Khodii/OmniMoveCar/README.md

# OmniMoveCar
Design, Herstellung und Software für ein OmniMove Auto in kleinem Maßstab

Praktikum Konstruktionslehre
Besondere Eigenschaft: omnidirektionales Fahren möglich durch holonome Räder und Planetengetriebe
