Khodii/OmniMoveCar/Bericht/LaTeX/kapitel3.tex

\chapter{Planung}
Nachdem das Lastenheft abgegeben wurde war der nächste Meilenstein der Abschluss der Konzeptphase, zu dem eine kurze Präsentation über Gesamt- und Teilfunktionen, Lösungsprinzipien und Morphologischer Kasten gehalten werden sollte. Außerdem sollte die Präsentation pro Gruppenmitglied ein vorläufiges Konzept mit Freihandskizze enthalten. 

\section{Entwürfe}
Da die Entscheidung für das finale Konzept sehr früh gefallen ist, wurde sich darauf geeinigt, dass zwei Gruppenmitglieder dieses Konzept bearbeiten, und dabei viel tiefer ins Detail gehen. 
Die übrigen zwei Gruppenmitglieder haben jeweils eine eigene Idee behandelt, blieben dabei aber deutlich oberflächlicher. 

Insgesamt sind dabei die drei im Folgenden vorgestellte Konzepte entwickelt worden.

\subsection{Seggway}
Das Konzept des (S)Eggways (Abb.~\ref{bild:seggway}) ist, wie der Name schon verrät, inspiriert durch die immer populärer werdende Fortbewegungsart des Segways. 
Dieses Konzept würde viele Vorteile mit sich bringen: Das Gesamtgewicht des Seggways ist relativ gering, da es keine massiven Bauteile gibt und technische Bauteile wie das Breadboard gleichzeitig mehrere Zwecke erfüllen (Stabilisierung und Verbindung). 

Zusätzlich könnte der Seggway einen sicheren Ei-Transport durch eine passende Regelung sicherstellen, da diese ermöglicht, dass auch bei starken Steigungen und unebenen Strecken immer das Gleichgewicht beibehalten beziehungsweise wiederhergestellt werden kann. 
Das gelingt durch das Prinzip des inversen Pendels. 

Die Steuerung des Fahrzeugs erfolgt über das eingezeichnete Bluetooth-Modul, welches die erhaltenen Daten an den Arduino weitergibt. 
Der Arduino verarbeitet die Daten und steuert anschließend (falls nötig) die zwei Stepper-Motoren an. 

Die Stepper-Motoren sind für diese Anwendung ideal geeignet und können auch direkt ohne Getriebe mit den zwei Reifen verbunden werden. 
Das Gyroskop dient dem Messen von Geschwindigkeit, Beschleunigung und aktuellem Winkel. 

Der Eierhalter ist genau so konzipiert wie in dem realisierten TEGGLA Modell, nämlich werden mehrere einzelne Segmente verbunden um möglichst wenig Gewicht mit möglichst viel Stabilität zu verbinden.

\begin{figure}[H]
	\centering
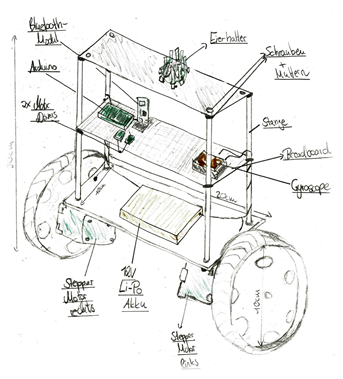
[picture p1: Bericht/LaTeX/bilder/seggway.png]
	
	\caption{Skizze Seggway}
	\label{bild:seggway}
\end{figure}

Siehe Tabelle~\ref{table:seggway} für eine genaue Aufzählung der benötigten Komponenten. 
Alle restlichen Bauteile wie die Stangen, Ebenen und Reifen könnten problemlos via 3D-Druck mit PLA hergestellt werden.

\begin{table}[H]
	\centering
\begin{tabular}{lc}
	Bezeichnung & Anzahl \\
	\midrule[2pt]
	Bluetooth-Modul & 1\\
	\midrule
	Arduino & 1 \\
	\midrule
	Motor Driver & 2 \\
	\midrule
	Stepper Motor & 2 \\
	\midrule
	12V Li-Po Akku & 1 \\
	\midrule
	Gyroscope & 1 \\
	\midrule
	Breadboard & 1 \\
	\midrule
	Schraube + Mutter & 8 \\

\end{tabular} 
\caption{Stückliste Seggway} 
\label{table:seggway}
\end{table} 

\subsection{Weggchair}
Beim Weggchair ist die Namensgebung leider ein wenig misslungen. 
Der Rest vom Konzept wäre mit den vom Lehrstuhl bereitgestellten Materialien recht leicht zu realisieren gewesen.
Deswegen wäre es der Plan B gewesen, falls das präferierte Konzept nicht realisiert werden kann. 

Das Konzept orientiert sich, wie der Name andeuten soll, recht nahe an einem Rollstuhl. 
Die gesamte Elektronik befindet sich in einer Zwischenebene unter der ``Sitzfläche''. 
Gelenkt wird der Weggchair indem sich beide Motoren verschieden schnell drehen. 

Wie in der Skizze (Abb.~\ref{bild:weggchair}) zu sehen ist, ist das ``Stützrad'' eher eine ``Stützkugel'', die in alle Richtungen über den Boden gleiten kann. 
Statt einer Kugel wären auch eine oder zwei drehbar gelagerte Rollen denkbar gewesen, ähnlich wie bei einem Einkaufswagen oder natürlich dem originalen Rollstuhl. 

Da die verwendeten DC-Motoren unter Volllast über 7000 Umdrehungen schaffen, dafür aber weniger Drehmoment haben, wäre -- wie in der finalen Idee -- ein Planetengetriebe innerhalb der großen Räder zum Einsatz gekommen. 

Das Ei wäre beim Weggchair an der Stelle befestigt, wo normalerweise der Rollstuhlfahrer sitzt. Dafür wäre eine Federung und Halterung an dieser Stelle gewesen. Vermutlich wäre ein mit Watte oder einem ähnlichen elastischen, polsternden Material ausgestatteter Eierbecher zum Einsatz gekommen.

\begin{figure}[!htbp]
	\centering
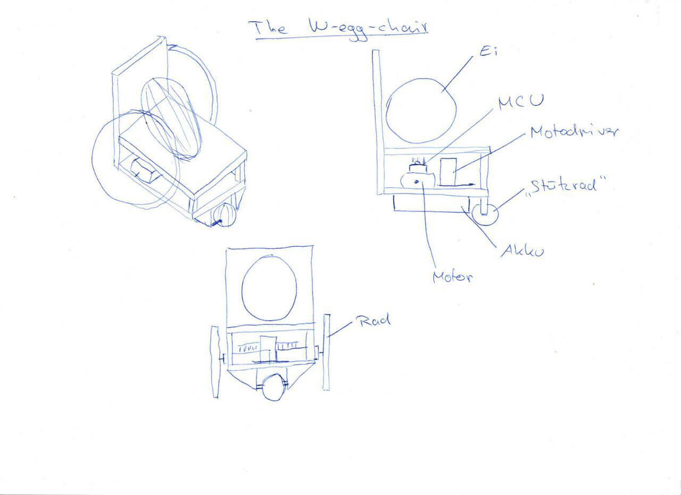
[picture p2: Bericht/LaTeX/bilder/weggchair.jpg]
	
	\caption{Skizze Weggchair}
	\label{bild:weggchair}
\end{figure}

\subsection{TEGGLA}
Da sich die nächsten drei Kapitel nur mit dem finalen Konzept auseinandersetzen, wird an dieser Stelle nur ganz kurz auf das Konzept des TEGGLA (Abb.~\ref{bild:tegglaskizze}) eingegangen, damit die nachfolgenden Kapitel nachvollziehbar sind. 

Das besondere Feature beim TEGGLA sind die omnidirektionalen Räder, auch als Mecanum bezeichnet, die neben dem normalen Vorwärtsfahren auch Seitwärtsbewegungen und Rotation zulassen. 
Diese drei Freiheitsgrade lassen sich auch beliebig kombinieren. 
Dadurch ist in der Ebene jede denkbare Richtung befahrbar. Dazu sind allerdings vier Motoren notwendig. 

Daher wächst die Elektronikteileliste wie folgt: Für die zwei Extramotoren wird eine zusätzliche H-Brücke benötigt. 
Leider hat das bereitgestellte ESP-8266 nicht genug Pins für die zusätzliche Elektronik, weswegen zum ESP-32 upgegraded werden musste. 

Es folgen noch viel mehr Details, aber um die folgenden Kapitel zu verstehen, muss noch gesagt werden, dass der TEGGLA in der Entwicklungsphase noch Omni-Move hieß. Beide Namen sind im Folgenden also synonym. 

\begin{figure}[!ht]
	\centering
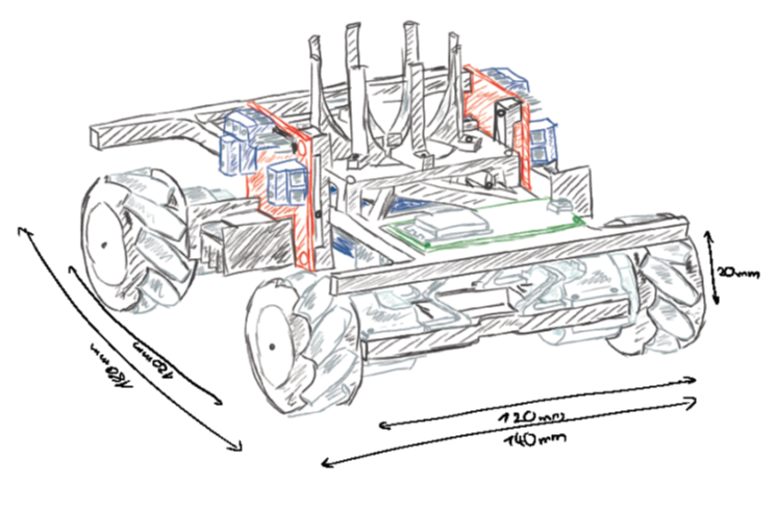
[picture p3: Bericht/LaTeX/bilder/tegglaskizze.png]
	
	\caption{Skizze TEGGLA}
	\label{bild:tegglaskizze}
\end{figure}

\section{Morphologischer Kasten}
Mithilfe des Morphologischen Kastens (Abb.~\ref{bild:morphkasten}) lassen sich die benötigten Komponenten auf eine einfach ersichtliche Weise vergleichen.
\begin{figure}[!htb]
	\centering
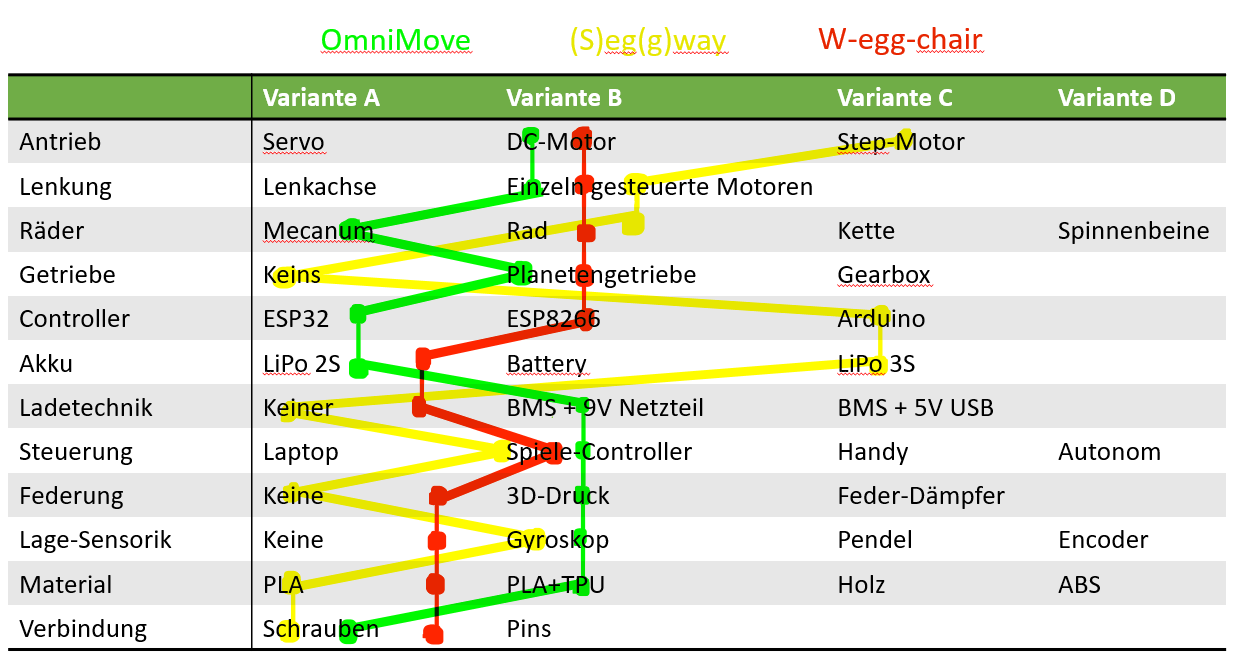
[picture p4: Bericht/LaTeX/bilder/morphkasten.png]
	
	\caption{Morphologischer Kasten}
	\label{bild:morphkasten}
\end{figure}

Um sich aufrecht zu halten benötigt der Seggway Stepper-Motoren statt der DC-Motoren, da diese genauer kontrolliert werden können.
Dadurch könnte das Getriebe gespart werden. Allerdings braucht der Seggway auf jeden Fall ein Gyroskop (und eine gute Regelung) um aufrecht stehen zu bleiben und zu fahren. 

Bei der Steuerung setzen alle Konzepte auf einen Spiele-Controller, da es keine leichtere und intuitivere Steuerung gibt.

Der Weggchair würde, wie oben angemerkt, mit den vom Lehrstuhl bereitgestellten Materialien auskommen. Für die Übersetzung wäre ein Planetengetriebe im Rad zuständig. 

Der TEGGLA braucht ein ESP-32, da das ESP-8266 zu wenig Anschlüsse hat. Das Highlight, die Räder, sind bei diesem Konzept die Mecanum-Wheels. Als Energiespeicher kommt ein zweizelliger LiPo in Kombination mit einem BMS (Battery Management System) zum Einsatz. Hier ist der Einsatz des Spiele Controllers besonders wichtig, da damit alle drei Achsen (X-Achse, Y-Achse und Rotation) analog gesteuert werden können. Für die Sicherheit des Eies sorgt eine Federung aus TPU. Zum TEGGLA werden alle Teile und Entscheidungen in diesem Bericht noch näher beleuchtet. 

\section{Online Bestellungen}
Um das Fahrzeug nach dem Praktikum behalten zu können, war eine Voraussetzung, dass nur Teile verbaut werden, die nicht Eigentum des Lehrstuhls sind.
Aus diesem Grund wurden die nötigen Bauteile bei unterschiedlichen Onlineshops herausgesucht und bestellt.
Hierbei fiel die Entscheidung auf Pollin, einem deutschen Elektronik-Händler und AliExpress, einem chinesischen Großhändler.
In der ursprünglichen Planung wurden die Kosten pro Fahrzeug auf circa \EUR{20} -- \EUR{25} überschlagen.
In der finalen Bestellung beliefen sich die Kosten auf insgesamt etwa \EUR{32}.

Da die Bauteile in Sammelbestellungen für insgesamt 4 Fahrzeuge getätigt wurden, verteilten sich die Versandkosten auf die Fahrzeuge, wodurch sich der Preis nach unten hin anpasste. 

Siehe Tabelle~\ref{table:Kosten} für eine genaue Aufteilung der Kosten.
\begin{table}[!ht]
	\centering
\begin{tabular}{lcccc}
	Artikel & Stk & \euro/Stk & \euro{} & Laden\\
	\midrule[2pt]
	Netzteil 9V 1A & 1 & 0,95 & 0,95 & Pollin\\
	\midrule
	DC Motor & 4 & 0,95 & 3,80 & Pollin\\
	\midrule
	2S LiPo & 1 & 9,95 & 9,95 & Pollin\\
	\midrule
	XT60 5er Satz & 0,5 & 1,8 & 0,90 & AliExpress\\
	\midrule
	ESP32 & 1 & 3,77 & 3,77 & AliExpress\\
	\midrule
	2s BMS & 1 & 0,89 & 0,89 & AliExpress\\
	\midrule
	Kabelset 20cm & 0,5 & 3,30 & 1,65 & AliExpress\\
	\midrule
	Kabelset F -- F 10cm & 0,5 & 0,68 & 0,34 & AliExpress\\
	\midrule
	Gyroskop & 1 & 0,93 & 0,93 & AliExpress\\
	\midrule
	H-Brücken & 2 & 1,17 & 2,34 & Bestand\\
	\midrule
	Filament \textit{[kg]} & 0,05 & 20,00 & 1,00 & Bestand\\
	\midrule
	Schrauben + Muttern \textit{[Set]} & 1 & 1,00 & 1,00 & Bestand\\
	\midrule
	Motorkabel & 1 & 0,50 & 0,50 & Bestand\\
	\midrule
	Versandkosten AliExpress & 0,25 & 9,00 & 2,25 & \\
	\midrule
	Versandkosten Pollin & 0,25 & 5,00 & 1,25 & \\
	\midrule
	\midrule
	 &  & Total & \EUR{31,52} & \\
\end{tabular} 
\caption{Kostenübersicht} 
\label{table:Kosten}
\end{table} 

\section{Verwendete Technologien}
Damit alle Teammitglieder an dem Projekt arbeiten können, musste sich vor dem Beginn auf die Software geeinigt werden, die verwendet wird. 
Diese Entscheidungsfindung wird in diesem Kapitel genauer betrachtet.

\subsection{Git}
Zu Beginn des Projekts war bereits klar, dass eine Datenversionskontrolle für alle Projektdateien benötigt wird.
Durch verschiede Vorerfahrungen fiel die Entscheidung sehr leicht. Git löst genau diese Aufgaben perfekt. Das Projekt wurde in einem privaten Repository auf Github gehostet. 
Die Wahl der graphischen Oberfläche für Git war jedem Gruppenmitglied selbst überlassen.
Vereinzelt wurde hier auf ``Git Extensions'' oder meist eher ``GitKraken'' (Abb.~\ref{bild:gitkraken}) gesetzt, aufgrund der übersichtlichen graphischen Oberfläche.

\begin{figure}[!ht]
	\centering
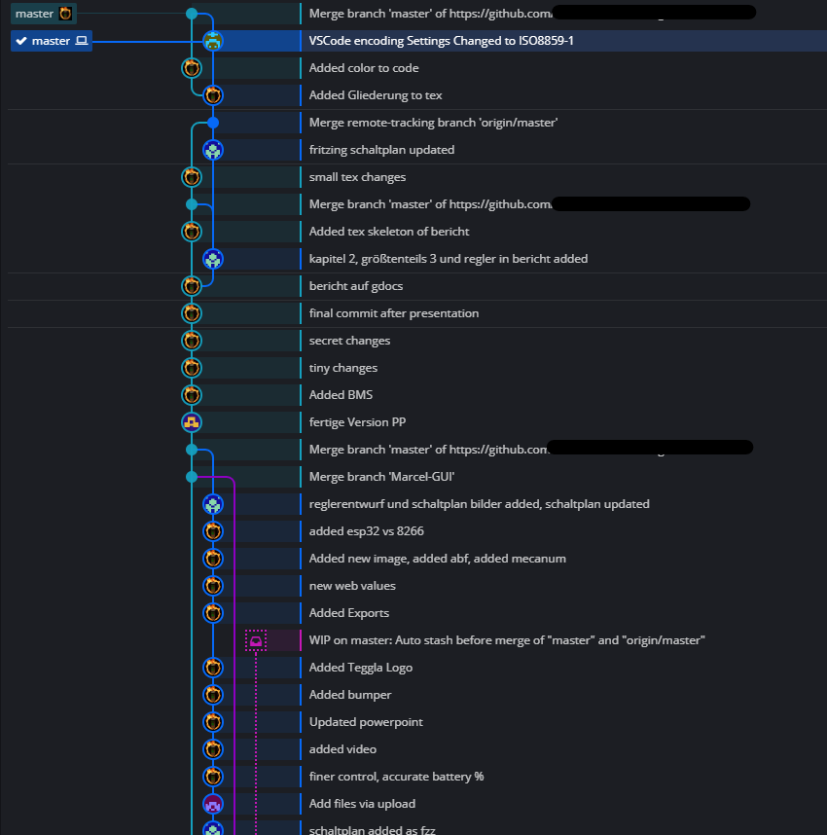
[picture p5: Bericht/LaTeX/bilder/GitKrakenUebersicht.png]
	
	\caption{Graphische Oberfläche für Git (GitKraken)}
	\label{bild:gitkraken}
\end{figure}

\subsection{Creo}
Bei der CAD-Software standen mehrere unterschiedliche Programme unterschiedlicher Hersteller zur Auswahl.
Diese waren ``Catia'' von Dassault Systemes, ``Sketchup'' von Trimble Inc., ``Creo Parametrics'' von PTC Inc., ``Blender'' von Blender Foundation, ``OpenSCAD'' (Opensource Programm) und ``FreeCAD'' (ebenfalls Opensource).
Nach längerem Abwägen fiel die Entscheidung auf das Programm Creo Parametrics (Abb.~\ref{bild:gitkraken}), da dieses vergleichbar einfach zu bedienen ist, aber trotzdem einen sehr großen Funktionsumfang bieten kann.
Des Weiteren bietet Creo eine gute 3D-Maus Unterstützung, was das Modellieren deutlich vereinfacht.
Trotz des großen Funktionsumfangs reichten die Möglichkeiten, die Creo bietet, nicht immer aus, weshalb in Einzelfällen auf andere CAD-Programme zurückgegriffen wurde. Diese werden allerdings an den betroffenen Stellen extra erwähnt. 

\begin{figure}[!ht]
	\centering
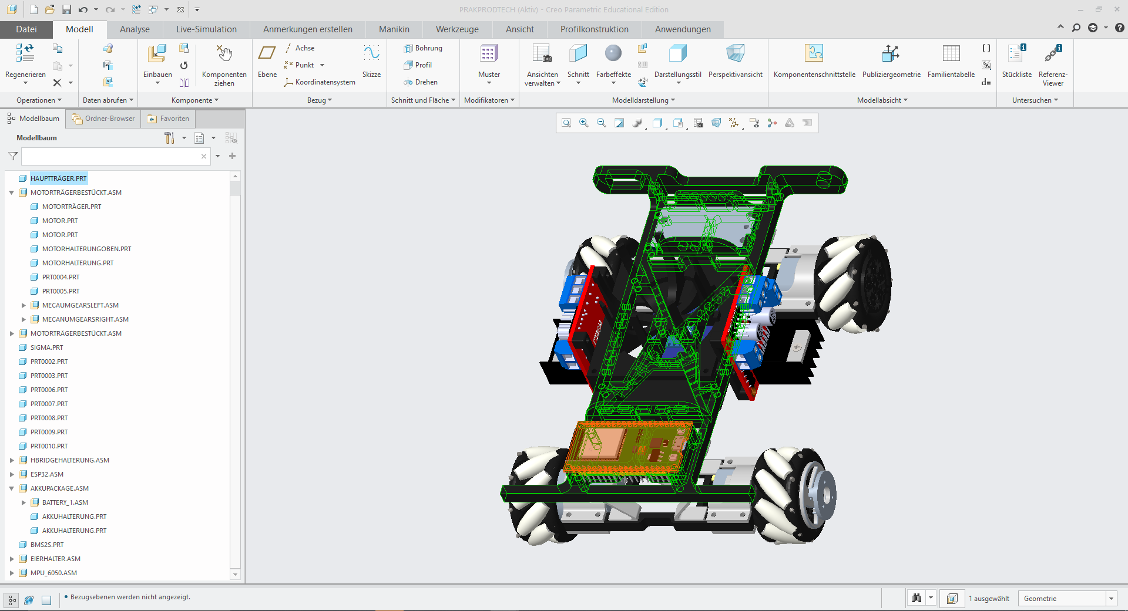
[picture p6: Bericht/LaTeX/bilder/CreoParametrics.png]
	
	\caption{CAD Programm ``Creo Parametrics''}
	\label{bild:creo}
\end{figure}

\newpage
\subsection{PlatformIO}
Die Wahl der Entwicklungsumgebung fiel auf Visual Studio Code mit PlatformIO, anstelle der in der Vorlesung vorgestelleten Arduino IDE.

Mit der umfangreichen Erweiterbarkeit von VSCode ist hier die Programmierung einfacher und fehlerfreier durchzuführen, da in Arduino IDE nur bedingtes Syntax-checking vorhanden ist.

Durch PlatformIO stellt sich das Einbinden von externen Bibliotheken ebenfalls als Leichtigkeit heraus.
Des Weiteren ist hier die Unterstützung von einer Vielzahl von MicroControllern bereits integriert.
