Khodii/OmniMoveCar/Bericht/LaTeX/anhang_quellcode.tex

\chapter{Quellcode}

\section{ESP32}
\includeC{../../Arduino/OmniMoveESP/src/communication.cpp}{communication.cpp}
\includeC{../../Arduino/OmniMoveESP/src/communication.h}{communication.h}

\includeC{../../Arduino/OmniMoveESP/src/movement.cpp}{movement.cpp}
\includeC{../../Arduino/OmniMoveESP/src/movement.h}{movement.h}

\includeC{../../Arduino/OmniMoveESP/src/util.cpp}{util.cpp}
\includeC{../../Arduino/OmniMoveESP/src/util.h}{util.h}

\includeC{../../Arduino/OmniMoveESP/src/main.cpp}{main.cpp}

\section{Webpage}
\includeLang{../../Arduino/OmniMoveESP/data/index.html}{index.html}{html}
\includeLang{../../Arduino/OmniMoveESP/data/code.js}{code.js}{java}
\includeLang{../../Arduino/OmniMoveESP/data/style.css}{style.css}{java}

\section{Java}
\includeLang{../../Code_GUI/ProduktionstechnikPraktikum/src/main/ConnectUI.java}{main/ConnectUI.java}{java}

\includeLang{../../Code_GUI/ProduktionstechnikPraktikum/src/components/SpeedMeter.java}{components/SpeedMeter.java}{java}
\includeLang{../../Code_GUI/ProduktionstechnikPraktikum/src/Toaster/Toaster.java}{Toaster/Toaster.java}{java}
\includeLang{../../Code_GUI/ProduktionstechnikPraktikum/src/Toaster/ToasterBody.java}{Toaster/ToasterBody.java}{java}
\includeLang{../../Code_GUI/ProduktionstechnikPraktikum/src/Utils/UIUtils.java}{Utils/UIUtils.java}{java}
\includeLang{../../Code_GUI/ProduktionstechnikPraktikum/src/Utils/TextFieldIP.java}{Utils/TextFieldIP.java}{java}
\includeLang{../../Code_GUI/ProduktionstechnikPraktikum/src/Utils/TextFieldPort.java}{Utils/TextFieldPort.java}{java}
\includeLang{../../Code_GUI/ProduktionstechnikPraktikum/src/zweitesFenster/Main.java}{main/Main.java}{java}
\includeLang{../../Code_GUI/ProduktionstechnikPraktikum/src/zweitesFenster/ZweitesFenster.java}{main/ZweitesFenster.java}{java}
