Khodii/OmniMoveCar/Praktikum Produktionstechnik M2.pptx

## Praktikum Produktionstechnik

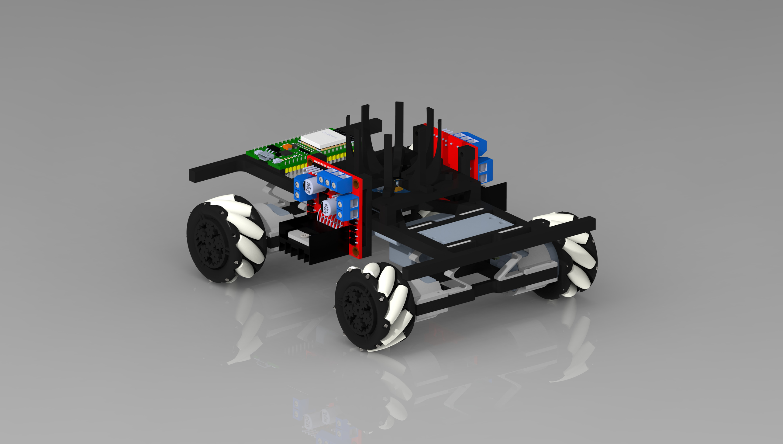
[picture p32: figure]

M2: Abschluss Konzeptphase
Gruppe 4

## Gliederung

1. Morphologischer Kasten
2. Alternative 1: (S)EggWay
(1) Skizze
3. Alternative 2: W-egg-Chair
  1. Skizze
4. Hauptidee: OmniMove
  1. Skizzen
  2. Gesamt- und Teilfunktionen
  3. Lösungsprinzipien

## Morphologischer Kasten

OmniMove

(S)eg(g)way

W-egg-chair

| Variante A | Variante B | Variante C | Variante D
Antrieb | Servo | DC-Motor | Step-Motor
Lenkung | Lenkachse | Einzeln gesteuerte Motoren
Räder | Mecanum | Rad | Kette | Spinnenbeine
Getriebe | Keins | Planetengetriebe | Gearbox
Controller | ESP32 | ESP8266 | Arduino
Akku | LiPo 2S | Battery | LiPo 3S
Ladetechnik | Keiner | BMS + 9V Netzteil | BMS + 5V USB
Steuerung | Laptop | Spiele-Controller | Handy | Autonom
Federung | Keine | 3D-Druck | Feder-Dämpfer
Lage-Sensorik | Keine | Gyroskop | Pendel | Encoder
Material | PLA | PLA+TPU | Holz | ABS
Verbindung | Schrauben | Pins

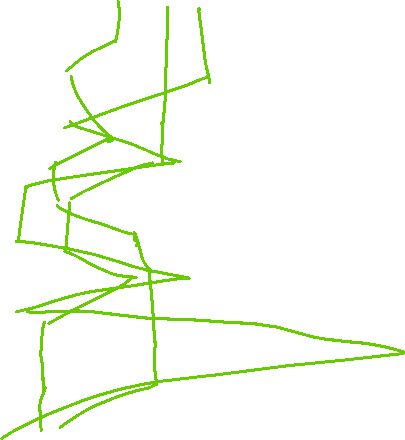
[picture p33: figure]

## (S)EggWay : Skizze

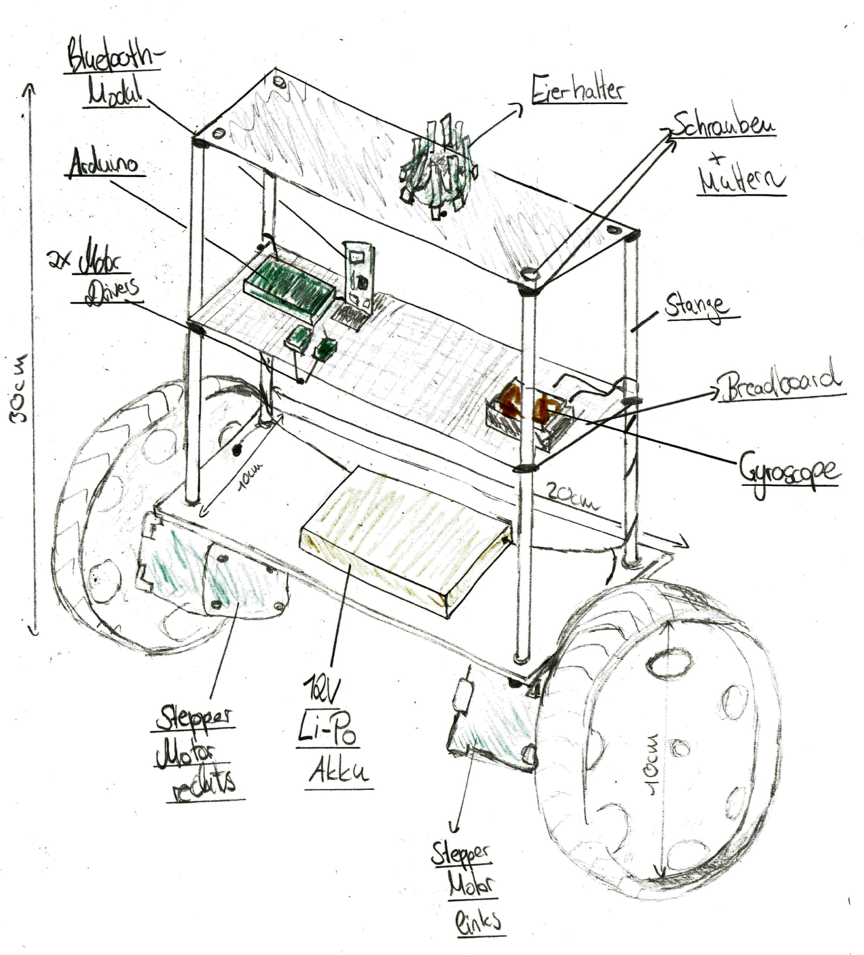
[picture p34: figure]

## W-egg-Chair: Isometrische Darstellung

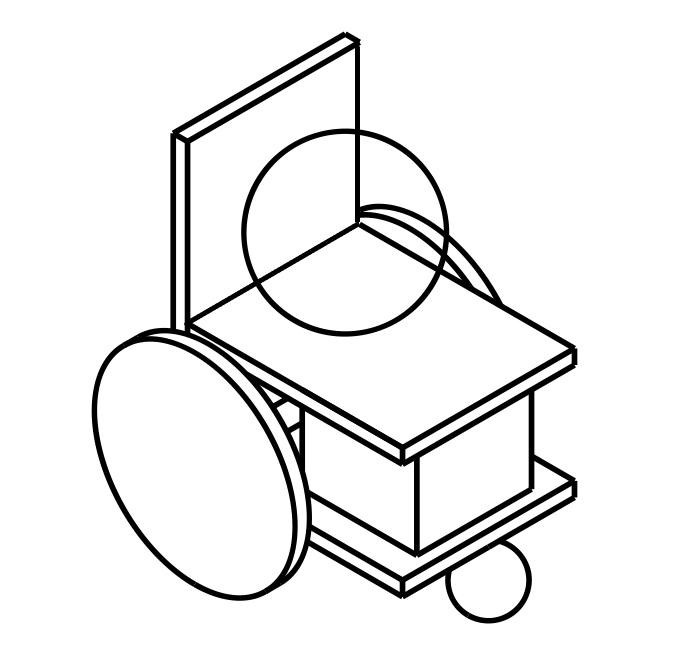
[picture p35: figure]

## W-egg-Chair: Skizze


## OmniMove: Gesamt- und Teilfunktionen (wichtigste Subsysteme)

OmniMove

Chassis

Steuerung

Antrieb

TPU- Federung

H-Brücke

Eierhalter

Gyroscope

ESP32

DC-Motor

Räder

Getriebe

Mecanum

## OmniMove Skizze: Isometrisch


## Slide 9

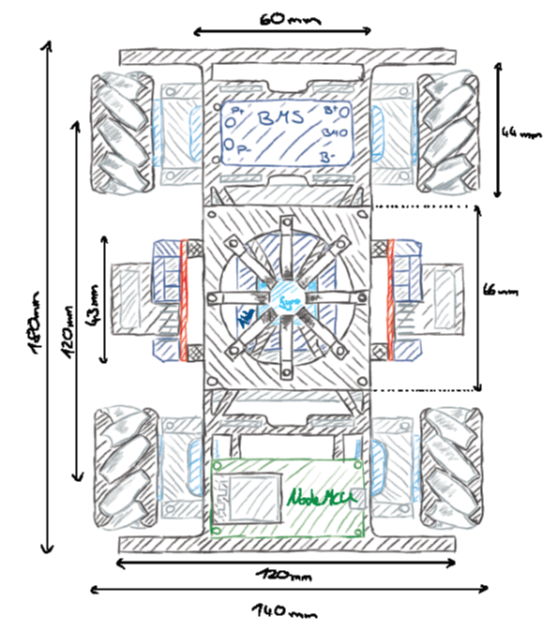
[picture p36: figure]

OmniMove
Skizze: Draufsicht

## OmniMove Skizze: Mecanum Räder & Planetengeriebe

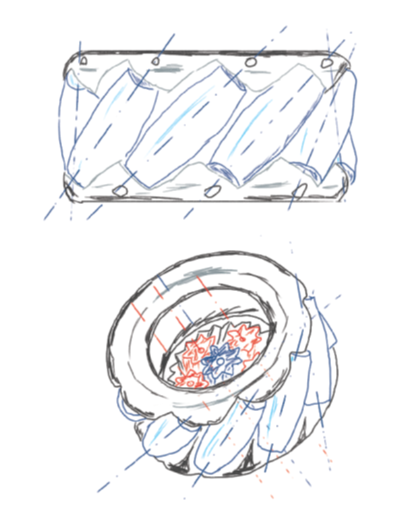
[picture p37: figure]
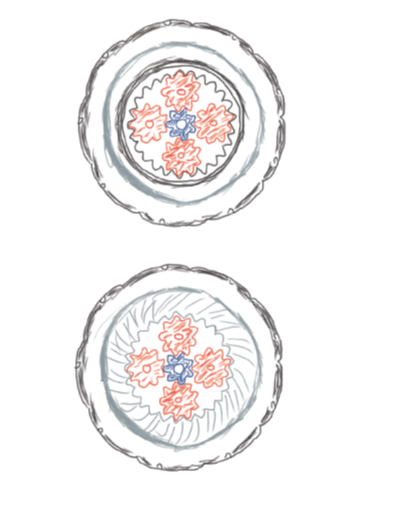
[picture p38: figure]

## Danke für die Aufmerksamkeit
