Khodii/OmniMoveCar/Praktikum ProdTech Präsentation.pdf

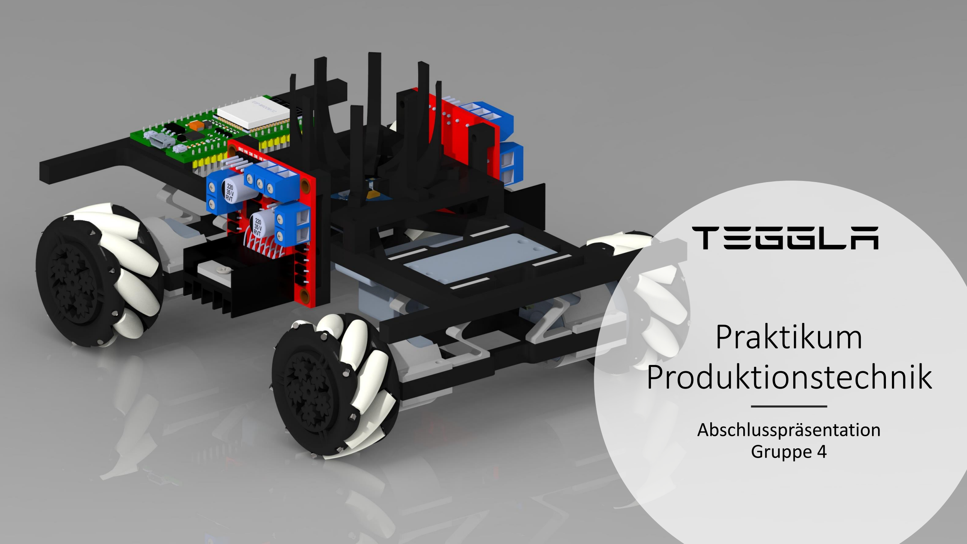
[picture p39: page 1]

# Praktikum Produktionstechnik

Abschlusspräsentation
Gruppe 4

## TEGGLA

# Gliederung

### 1. Vorführung des TEGGLA

### 2. Entwicklungsprozess (via V-Modell)

### 3. Merkmale und Schlüsseltechnologien

### 4. Erweiterungs – und Verbesserungsmöglichkeiten

### 5. Quellen

# 1. Vorführung des TEGGLA

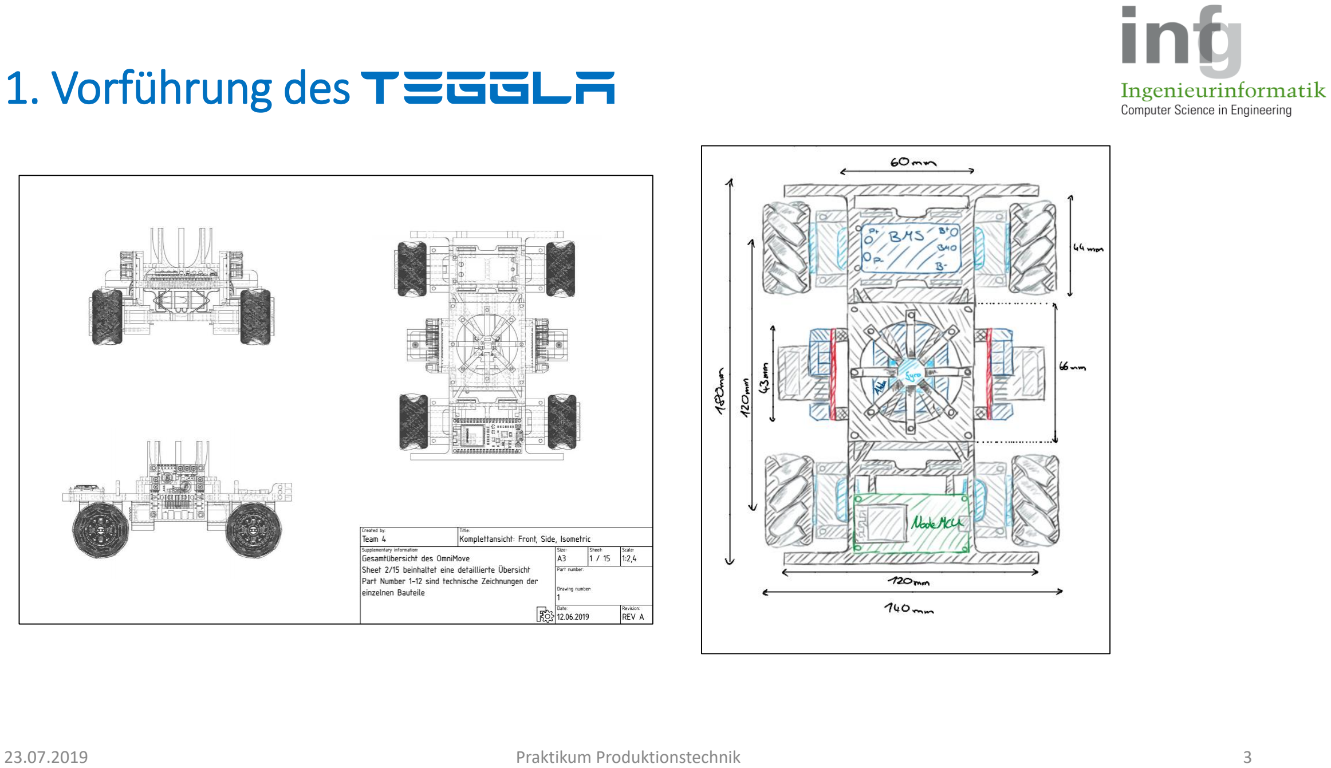
[picture p40: page 3]

23.07.2019 | Praktikum Produktionstechnik | 3

## 2.1 Planung

## 2.2 Anforderungsermittlung

## 2.3 Systementwurf

## 2.4 TEGGLA Test & Validierung

## 2.1 Planung

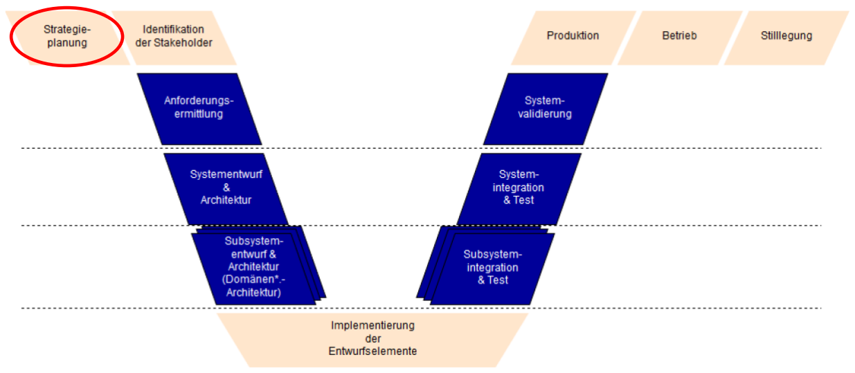
[picture p41: figure]

## 2.1 Planung (Morphologischer Kasten)

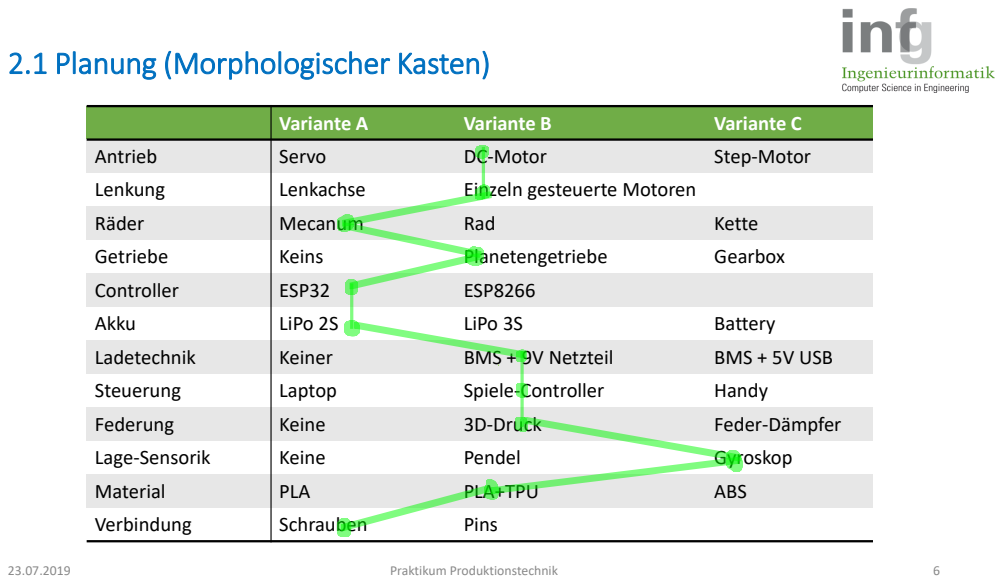
[picture p42: page 6]
Variante A; Variante B; Variante C; Antrieb; Servo; DC-Motor; Step-Motor; Lenkung; Lenkachse; Einzeln gesteuerte Motoren; Räder; Mecanum; Rad; Kette; Getriebe; Keins; Planetengetriebe; Gearbox; Controller; ESP32; ESP8266; Akku; LiPo 2S; LiPo 3S; Battery; Ladetechnik; Keiner; BMS + 9V Netzteil; BMS + 5V USB; Steuerung; Laptop; Spiele-Controller; Handy; Federung; Keine; 3D-Druck; Feder-Dämpfer; Lage-Sensorik; Pendel; Gyroskop; Material; PLA; PLA+TPU; ABS; Verbindung; Schrauben; Pins

## 2.2 Anforderungsermittlung

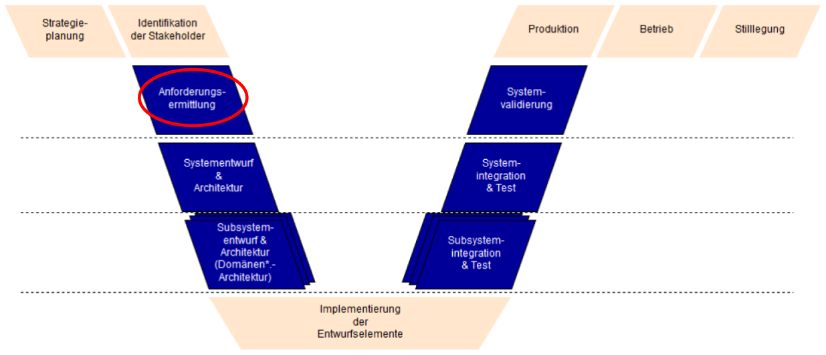
[picture p43: figure]

## 2.2 Anforderungsermittlung (Auswahl)

Anforderungen

Funktionen

Fahren (F) | Lenken können (F)
Mindestdistanz 4 Meter (F) | Ei Transport (F)

Omnidirektionales
Fahren

Steuerung via XBOX
Controller

Reichweite lediglich durch WLAN & Akku begrenzt

Eihalterung
(Chassis + Federung)

## 2.3 Systementwurf

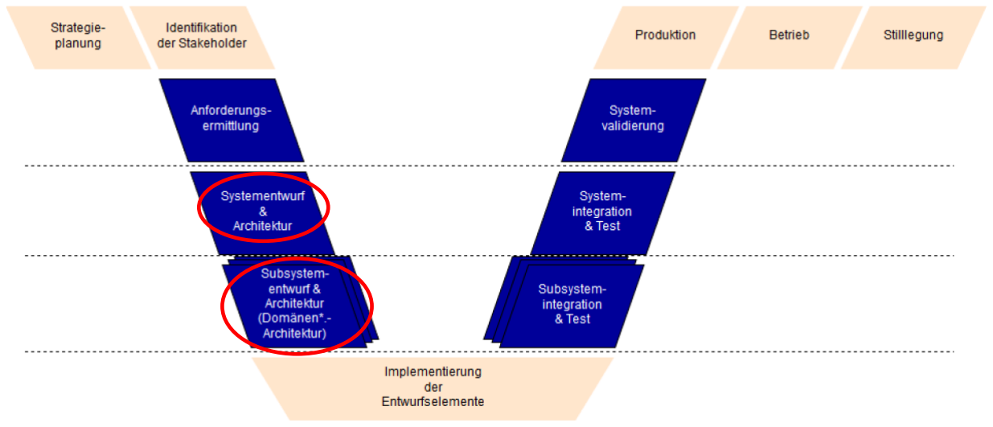
[picture p44: figure]

## TEGGLA: Gesamt- und

Teilfunktionen (wichtigsten Subsysteme)

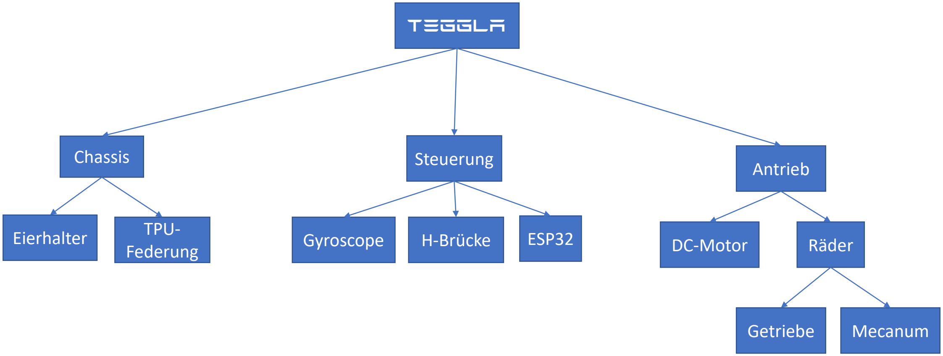
[picture p45: figure]
TEGGLA; Antrieb Chassis; Steuerung; Mecanum; H-Brücke; DC-Motor Eierhalter; ESP32 TPU-; Federung; Getriebe; Gyroscope; Räder

## 2.3 Systementwurf (Technische Zeichnung – Auswahl)

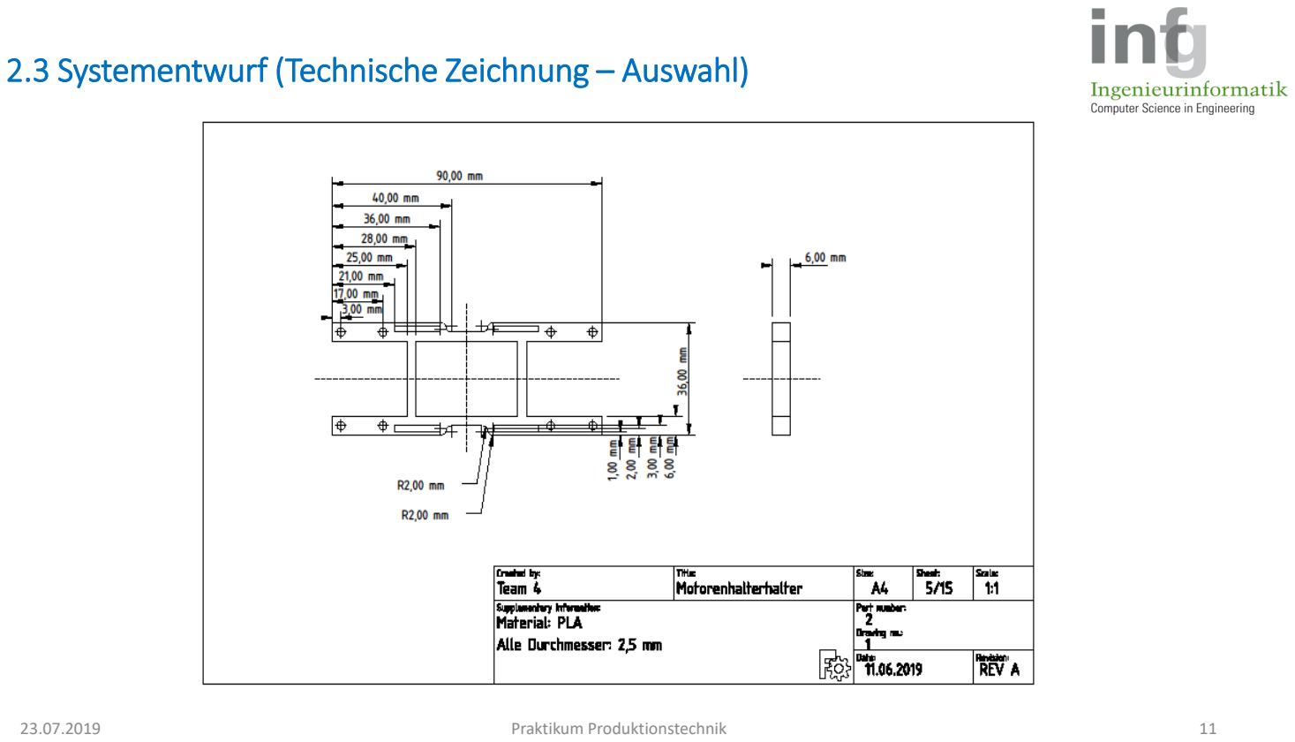
[picture p46: page 11]

## 2.3 Systementwurf (Technische Zeichnung – Auswahl)

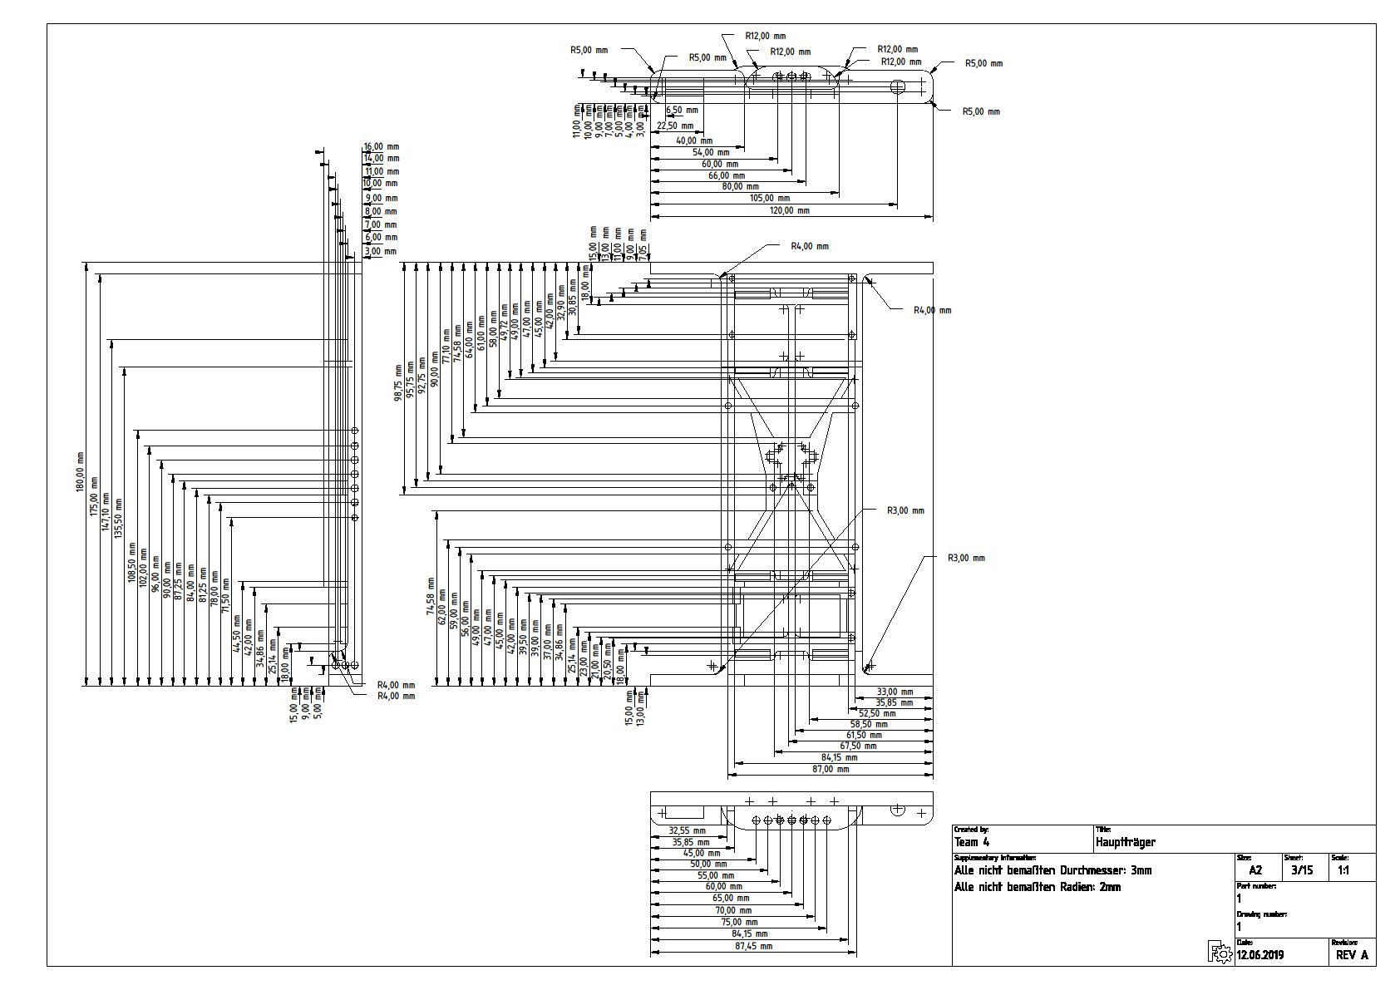
[picture p47: figure]

## 2.3 Systementwurf (Schaltplan)

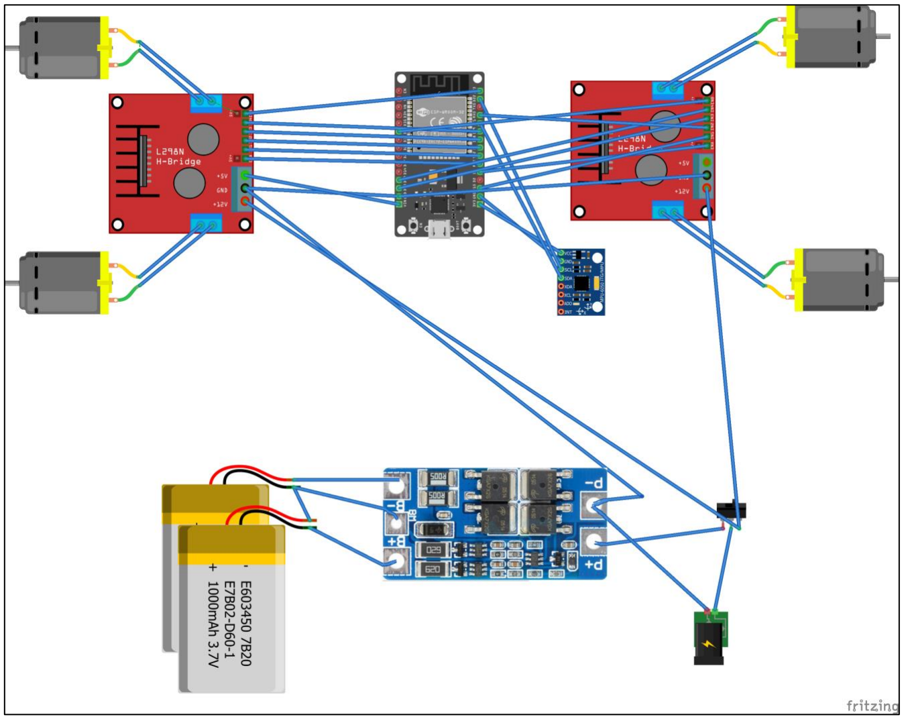
[picture p48: figure]

## 2.3 Systementwurf Kommunikation und Steuerung 1 – Java (obsolet)

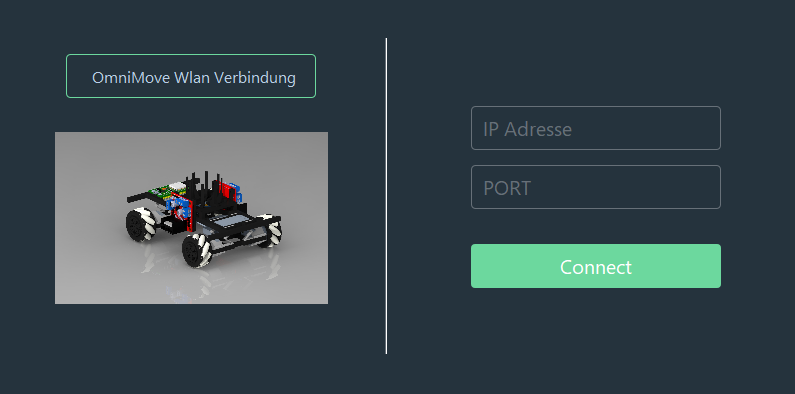
[picture p49: figure]

## 2.3 Systementwurf Kommunikation und Steuerung 1 – Java (obsolet)

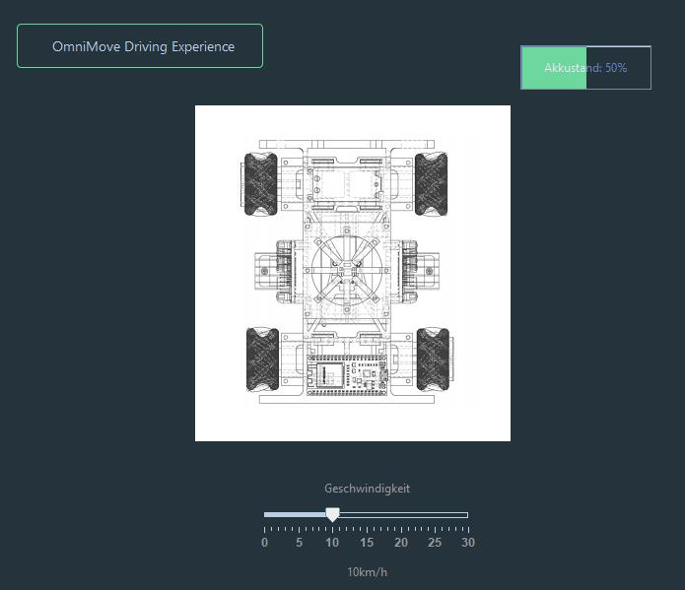
[picture p50: figure]

## 2.3 Kommunikation und Steuerung 2 HTML5 & Websocket

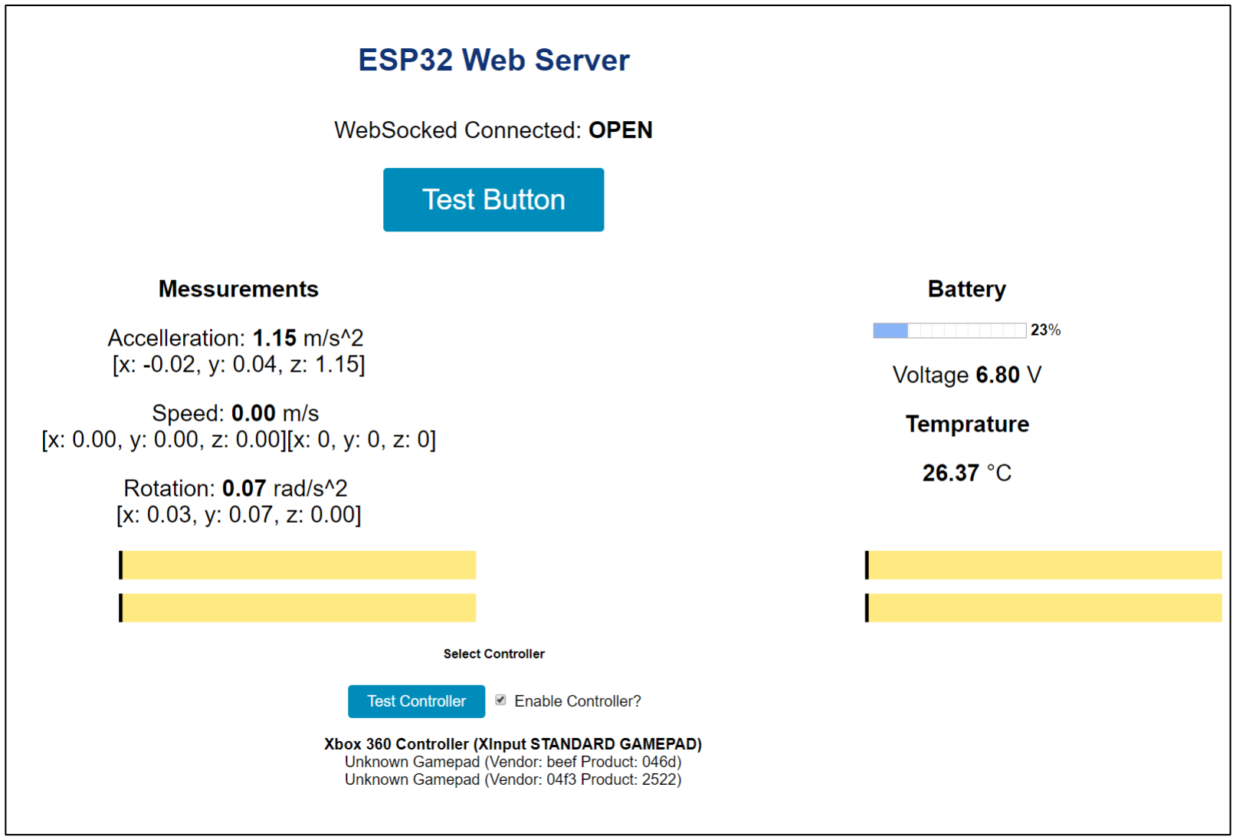
[picture p51: figure]

## 2.3. Kommunikation und Steuerung 2 ABNF

Name | ID | Werte
DRIVE | 0 | X-Achse L | Y-Achse L | X-Achse R | Y-Achse R
GYRO | 1 | Speed - X | Speed - Y | Speed - Z | Accel - X | Accel - Y | Accel - Z | Rot - X | Rot - Y | Rot - Z
BATTERY | 2 | Voltage
MOTOR | 3 | Speed – M1 | Speed – M2 | Speed – M3 | Speed – M4
COMB | 4 | Speed - X | Speed - Y | Speed - Z | Accel - X | Accel - Y | Accel - Z | Rot - X | Rot - Y | Rot - Z | Battery | Temp

→Werte je 16 bit signed Integer

## 2.4 Test & Validierung

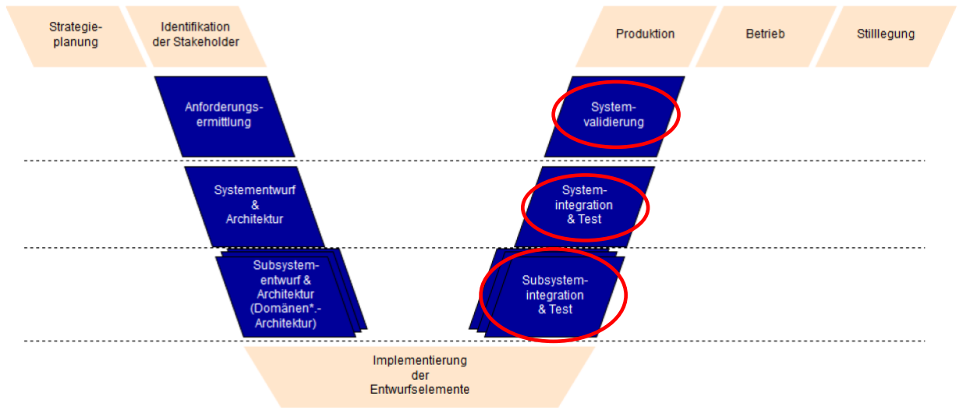
[picture p52: figure]

## 2.4 Test & Validierung (Video)

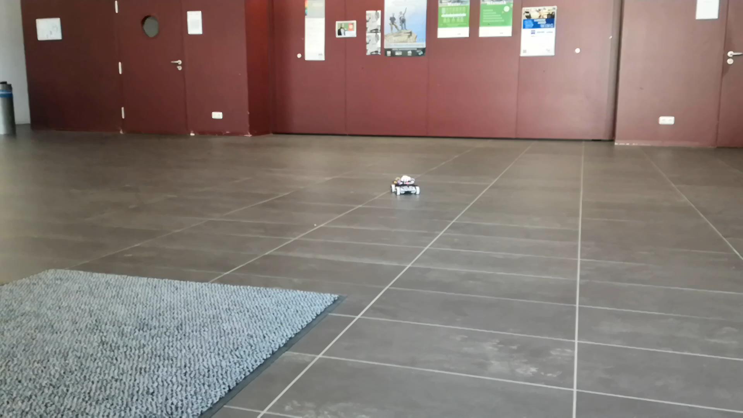
[picture p53: figure]

## 3.1 Gesamtübersicht

## 3.2 Mecanum Räder & Planetengetriebe

## 3.3 PLA vs TPU

## 3.4 ESP32 vs ESP8266

## 3.5 BMS

## 3.1 Gesamtübersicht

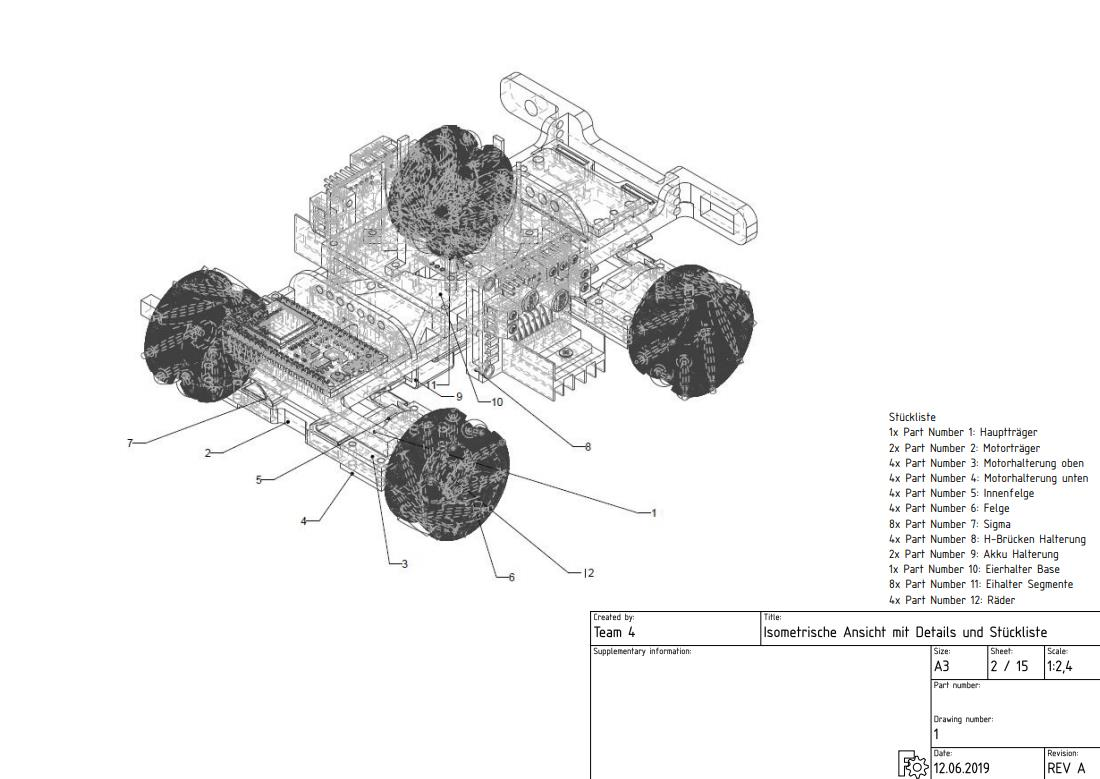
[picture p54: figure]

Stückliste:
1x Hauptträger
2x Motorträger
4x Motorhalterung oben
4x Motorhalterung unten
4x Innenfelge & Felge
8x Sigma
4x H-Brücken Halterung
2x Akku Halterung
1x Eierhalter Base
8x Eihalter Segmente
4x Mecanum Räder

## 3.2 Mecanum Räder & Planetengetriebe

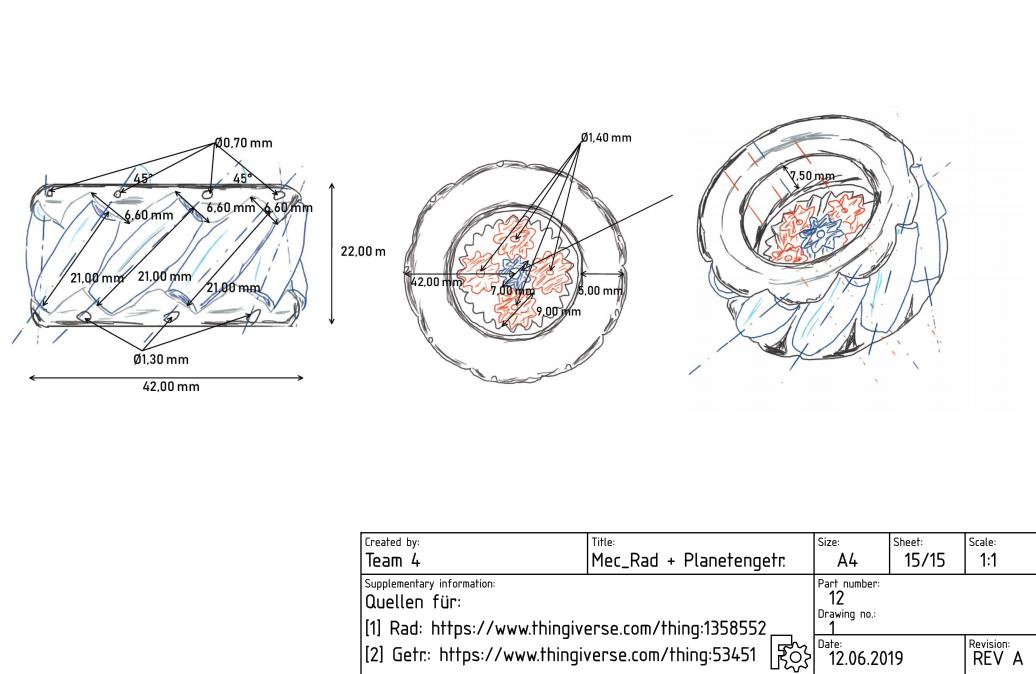
[picture p55: figure]

## 3.2 Mecanum – Steuerung & Formeln

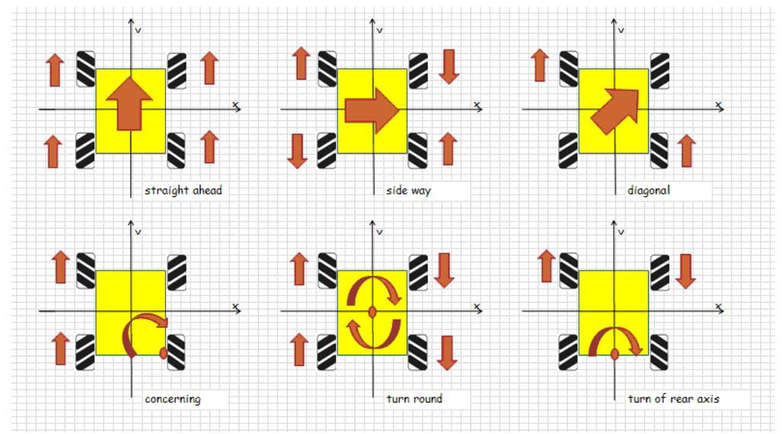
[picture p56: figure]

https://www.roboteq.com/index.php/applications/applications-blog/entry/driving-mecanum-wheels-omnidirectional-robots

## 3.2 Mecanum Steuerung & Formeln

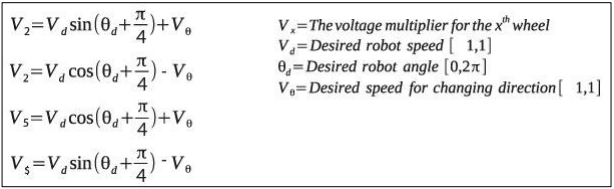
[picture p57: figure]

https://www.roboteq.com/index.php/applications/applications-blog/entry/driving-mecanum-wheels-omnidirectional-robots

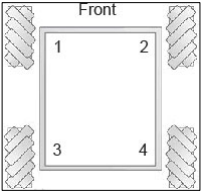
[picture p58: figure]

## 3.3 PLA vs. TPU

- Nicht alle Teile wurden mit PLA (=Polyactide) Filament gedruckt
- Folgende Teile wurden mit TPU (=thermoplastisches Elastometer) Filament gedruckt:
1) Motorhalterung und 2) Sigma
PLA | TPU
Hohes E-Modul(=Zugfestigkeit) und Steifigkeit | Mehr Flexibilität und Elastizität als PLA Material
Sehr einfache Verarbeitung | Teurer als PLA Filament
Problemloser Druckprozess | Fehleranfälliger Druckprozess

Wesentliche Unterschiede zwischen PLA und TPU

## 3.4 ESP32 vs ESP8266

| ESP8266 | ESP32
Cores | single core | dual core
Max Frequenz | 160 MHz | 240 MHz
GPIO | 17 (11 nutzbar) | 36 (30 nutzbar)
SRAM | 160 KB | 520 KB
ADC Auflösung | 10-Bit | 12-Bit
Preis (aus China) | 2€ | 4€

Benötigte Pins
4x PWM | Motor Enable
8x Output | Motor Richtung
2x I²C | Gyroskop
1x ADC | Batteriespannung
| 15 Pins

## 3.5 BMS – Battery Management System

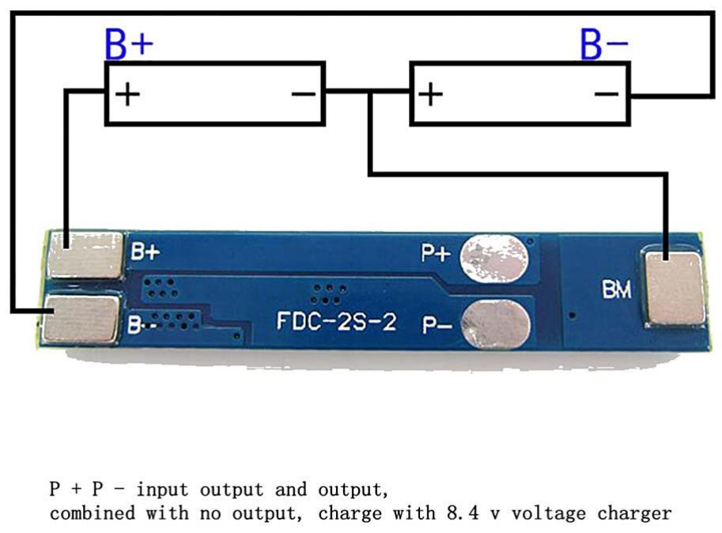
[picture p59: figure]

https://ae01.alicdn.com/kf/HTB1LH27HqSWBuNjSsrbq6y0mVXaG/3A-2-s-BMS-18650-Li-Ion-Lithium-Batterie-PCM-7-4-v-8-4-v.jpg

- Überspannungsschutz: max 4.2V pro Zelle
- Unterspannungsschutz: min 3.2V pro Zelle
- Ausgleichen der Zellen beim Laden

## 4.1 Erweiterung Regler

## 4.2 Verbesserungsvorschläge

## 4.1 Erweiterungsmöglichkeiten (Regler)

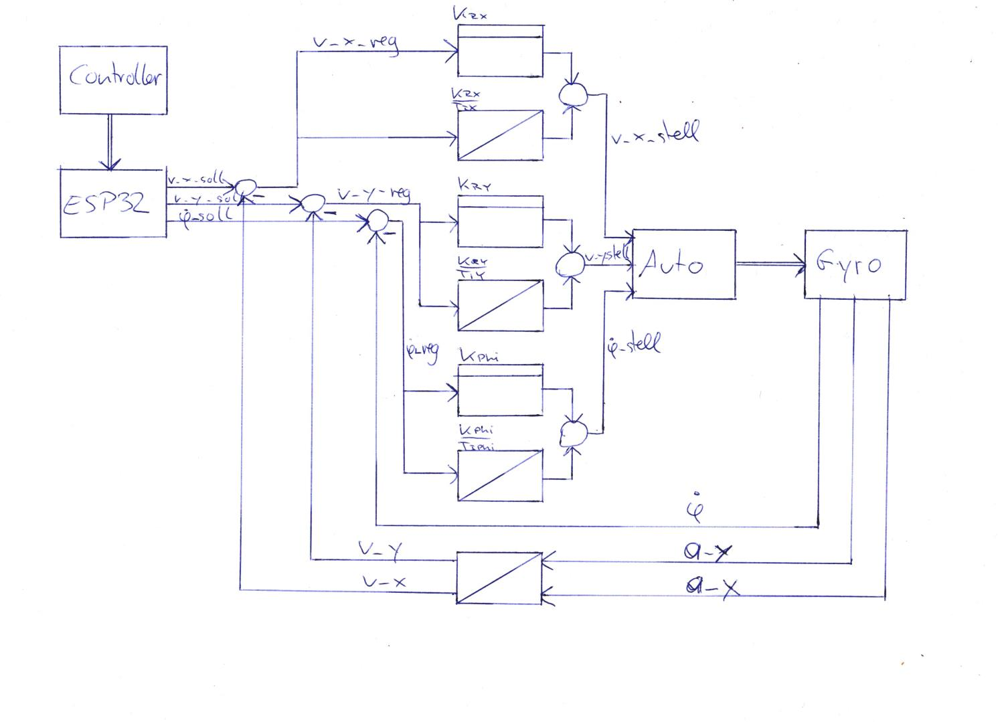
[picture p60: figure]

## 4.2 Verbesserungsvorschläge

- Stepper-Motor anstatt DC-Motoren
- Besserer Ladestecker
- Höhere Übersetzungen
- Spannung mit Step-Up / Step-Down konstant halten
- Weniger Spiel im Getriebe
- Mehr Grip auf den kleinen Rollen
- Notaus-Schalter neu designen

## 5 Quellen

3D - Modelle:
1. Source for 24mm customized Gear Bearing http://www.thingiverse.com/thing:53451
2. Source for 44mm Mecanum Wheel http://www.thingiverse.com/thing:1358552
3. Source for 11:1 Planetary Gearbox https://www.thingiverse.com/thing:2666785
4. Source for 66.46:1 Compound Planetary Gearbox https://www.thingiverse.com/thing:2277105

Library:
1. Source for WebServer
https://github.com/me-no-dev/ESPAsyncWebServer?utm_source=platformio&utm_medium=piohome
2. Source for Gyro Code
https://github.com/jrowberg/i2cdevlib?utm_source=platformio&utm_medium=piohome
