Khodii/OmniMoveCar/Bericht/LaTeX/dokument.tex

%% ++++++++++++++++++++++++++++++++++++++++++++++++++++++++++++
%% Hauptdatei, Wurzel des Dokuments
%% ++++++++++++++++++++++++++++++++++++++++++++++++++++++++++++
%
%  Gerüst:
%  * Version 0.2
%  * Dipl.-Ing. Florian Evers, florian.evers@tu-ilmenau.de
%  * Fachgebiet Kommunikationsnetze, TU Ilmenau
%  * Dipl.-Ing. Christian Tolks, christian.tolks@informatik.uni-augsburg.de
%  * Lehrstuhl für Regelungstechnik, Universität Augsburg
%
%  Für Hauptseminare, Studienarbeiten, Diplomarbeiten
%
%  Autor           : Max Mustermann
%  Letzte Änderung : 31.12.2015
%
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
	identifierstyle=\color{BlueViolet},
	stringstyle=\itshape\color{ForestGreen},
	breaklines=true,
	breakatwhitespace=true,
	tabsize=4,
	xleftmargin=\parindent,
	belowcaptionskip=1\baselineskip,
	frame=L,
	captionpos=b,
	keepspaces=true,
	numbers=left,
	numbersep=6pt,
	rulecolor=\color{black},
	numberstyle=\tiny\color{black!80},
	xleftmargin=\parindent,
	frame=single
}

\lstset{literate=%
    {Ö}{{\"O}}1
    {Ä}{{\"A}}1
    {Ü}{{\"U}}1
    {ß}{{\ss}}1
    {ü}{{\"u}}1
    {ä}{{\"a}}1
    {ö}{{\"o}}1
	{~}{{\textasciitilde}}1
	{°}{{\degree}}1
}

\newcommand{\includeC}[2]{\lstinputlisting[escapechar=, language=C++, style=customstyle, caption=#2]{#1} \bigskip}

\newcommand{\includeLang}[3]{\lstinputlisting[escapechar=, language=#3, style=customstyle, caption=#2]{#1} \bigskip}

% Verhindert Einrücken von Text nach Absatz
\parindent 0pt
% Update Dokument auf pdflatex v1.6, verhinder Fehlermeldung "`pdf inclusion..."'
\pdfminorversion=6
% Tiefe der Kapitelnummerierung beeinflussen
\setcounter{secnumdepth}{3} % Tiefe der Nummerierung
\setcounter{tocdepth}{3}    % Tiefe des Inhaltsverzeichnisses

% Hier in die zweite geschweifte Klammer jeweils
% die persönlichen Daten eintragen:
% \newcommand{\artderausarbeitung}{Abschlussarbeit}
% \newcommand{\namedesautors}{Max Mustermann}
% \newcommand{\titelderarbeit}{Anfertigung einer Ausarbeitung mit \LaTeX}
% \newcommand{\inventarisierungsnummer}{AA / BB / CC / DD}

% Alternativ: Eine Hauptseminararbeit hat keine Inventarisierungsnummer:
\newcommand{\artderausarbeitung}{Praktikum für Produktionstechnik}
\newcommand{\titelderarbeit}{Entwicklungsprozess eines lenkbaren Fahrzeuges\\ TEGGLA}
\newcommand{\namedesautors}{Wilfert, Paprotta, Evertz, Khodabakhsh}
\newcommand{\inventarisierungsnummer}{}

% Abkürzungsverzeichnis beeinflussen. Hier nichts ändern!
\usepackage[intoc]{nomencl}
  \let\abbrev\nomenclature
  \renewcommand{\nomname}{Abkürzungsverzeichnis und Formelzeichen}
  \setlength{\nomlabelwidth}{.25\hsize}
  \renewcommand{\nomlabel}[1]{#1 \dotfill}
  \setlength{\nomitemsep}{-\parsep}
  \makenomenclature
\usepackage[normalem]{ulem}
  \newcommand{\markup}[1]{\textbf{#1}}

% Seitenlayout festlegen. Hier nichts ändern!
\pagestyle{scrplain}
\ihead[]{\headmark}
\ohead[]{\pagemark}
\chead[]{}
\ifoot[]{\scriptsize \artderausarbeitung}
\ofoot[]{\scriptsize \namedesautors}
\cfoot[]{}
\renewcommand{\titlepagestyle}{scrheadings}
\renewcommand{\partpagestyle}{scrheadings}
\renewcommand{\chapterpagestyle}{scrheadings}
\renewcommand{\indexpagestyle}{scrheadings}

% Abschnittsweise Nummerierung anstatt fortlaufend. Hier nichts ändern!
\makeatletter
\@addtoreset{equation}{chapter}
\@addtoreset{figure}{chapter}
\@addtoreset{table}{chapter}
\renewcommand\theequation{\thechapter.\@arabic\c@equation}
\renewcommand\thefigure{\thechapter.\@arabic\c@figure}
\renewcommand\thetable{\thechapter.\@arabic\c@table}
\makeatother

% Quelltextrahmen, klein. Hier nichts ändern!
\newsavebox{\inhaltkl}
\def\rahmenkl{\sbox{\inhaltkl}\bgroup\small\renewcommand{\baselinestretch}{1}\vbox\bgroup\hsize\textwidth}
\def\endrahmenkl{\par\vskip-\lastskip\egroup\egroup\fboxsep3mm%
\framebox[\textwidth][l]{\usebox{\inhaltkl}}}

% Quelltextrahmen, normale Groesse. Hier nichts ändern!
\newsavebox{\inhalt}
\def\rahmen{\sbox{\inhalt}\bgroup\renewcommand{\baselinestretch}{1}\vbox\bgroup\hsize\textwidth}
\def\endrahmen{\par\vskip-\lastskip\egroup\egroup\fboxsep3mm%
\framebox[\textwidth][l]{\usebox{\inhalt}}}

% Trennvorschläge für falsch getrennte Wörter.
% Wird häufig bei eingedeutschen Wörtern benötigt, da LaTeX hierbei
% gerne falsch trennt. Alternativ kann auch im Fliesstext ein
% Trennvorschlag per "\-" hinterlegt werden, bspw.:
% Die Hard\-ware besteht aus A und B.
\hyphenation{
Hard-ware
Benutzer-oberfläche
}

% Sonstige Befehlsdefinitionen hier ablegen.
\newcommand{\entspricht}{\stackrel{\wedge}{=}}
\clubpenalty = 10000 \widowpenalty = 10000 \displaywidowpenalty = 10000 % Strafpunkte bei schlechten Absätzen

\begin{document}
\onehalfspacing
\input{titelblatt.tex}
% \input{vorwort.tex}
\input{kurzfassung.tex}

% Inhaltsverzeichnis
\cleardoublepage % Seitenumbruch erzwingen vor Änderung des Nummerierungsstils
\pagenumbering{roman} % Nummerierung der Seiten ab hier: i, ii, iii, iv...
\pagestyle{scrheadings} % Ab hier mit Kopf- und Fusszeile
\tableofcontents

% Die einzelnen Kapitel
\cleardoublepage % Seitenumbruch erzwingen vor Änderung des Nummerierungsstils
\pagenumbering{arabic} % Nummerierung der Seiten ab hier: 1, 2, 3, 4...
\input{kapitel1.tex}
\input{kapitel2.tex}
\input{kapitel3.tex}
\input{kapitel4.tex}
\input{kapitel5.tex}
\input{kapitel6.tex}

\appendix
\part*{Anhang}
\input{anhang_quellcode.tex}
\input{anhang_techzeichnungen.tex}

% Literaturverzeichnis einbinden
\input{anhang_literaturverzeichnis.tex}

% Abbildungsverzeichnis einbinden
\input{anhang_listings.tex}

% Abbildungsverzeichnis einbinden
\input{anhang_abbildungsverzeichnis.tex}

% Tabellenverzeichnis einbinden
\input{anhang_tabellenverzeichnis.tex}

% Abkürzungsverzeichnis einbinden
% \input{anhang_abkuerzungsverzeichnis.tex}

% Thesen
% \input{thesen.tex}

% Abschlusserklärung
% \input{abschlusserklaerung.tex}

\end{document}
