Khodii/OmniMoveCar/Bericht/LaTeX/kurzfassung.tex

%% ++++++++++++++++++++++++++++++++++++++++++++++++++++++++++++
%% Zusammenfassung, Abstract
%% ++++++++++++++++++++++++++++++++++++++++++++++++++++++++++++
%
%  Gerüst:
%  * Version 0.10
%  * Dipl.-Ing. Florian Evers, florian.evers@tu-ilmenau.de
%  * Fachgebiet Kommunikationsnetze, TU Ilmenau
%
%  Für Hauptseminare, Studienarbeiten, Diplomarbeiten
%
%  Autor           : Max Mustermann
%  Letzte Änderung : 31.12.2004
%

\renewcommand{\abstractname}{Kurzfassung}
\begin{abstract}
Dieser Bericht soll als Dokumentation des Entwicklungsprozesses und der technischen Komponenten des TEGGLA dienen. 
Hierbei handelt es sich um ein Fahrzeugs, welches durch die besonderen Mecanum-Räder mehr Freiheitsgrade hat als ein konventionelles Automobil.
Dieses wurde im Rahmen des Praktikum für Produktionstechnik entwickelt und gebaut.
\end{abstract}
