Khodii/OmniMoveCar/Bericht/LaTeX/anhang_literaturverzeichnis.tex

%% ++++++++++++++++++++++++++++++++++++++++++++++++++++++++++++
%% Anhang: Literaturverzeichnis
%% ++++++++++++++++++++++++++++++++++++++++++++++++++++++++++++
%
%  Gerüst:
%  * Version 0.2
%  * Dipl.-Ing. Florian Evers, florian.evers@tu-ilmenau.de
%  * Fachgebiet Kommunikationsnetze, TU Ilmenau
%  * Dipl.-Ing. Christian Tolks, christian.tolks@informatik.uni-augsburg.de
%  * Lehrstuhl für Regelungstechnik, Universität Augsburg
%
%  Für Hauptseminare, Studienarbeiten, Diplomarbeiten
%
%  Autor           : Max Mustermann
%  Letzte Änderung : 31.12.2015
%

% Mit dem Befehl \nocite werden auch nicht im Text zitierte
% aus der Literaturdatenbank mit in das Literaturverzeichnis aufgenommen.
% Ein "\nocite{*}" übernimmt ungeprüft die komplette Datenbank.
%\nocite{*}

\cleardoublepage
\ihead[]{Literaturverzeichnis}
\bibliographystyle{plaindin} % oder {itmalpha}
\bibliography{literatur} % "literatur.bib" ist hier die einzige Literaturdatenbank.

% Alternativ: Mehrere Datenbanken verwenden, falls eine
% oder mehrere umfangreiche Sammlungen exisitieren:
%\bibliography{literatur_buecher,literatur_weblinks}
