Khodii/OmniMoveCar/Bericht/LaTeX/anhang_techzeichnungen.tex

\chapter{Technische Zeichnungen}

\begin{figure}[ht!]
	 	
	\caption{Komplettansicht}
\end{figure}

\begin{figure}[ht!]
	 
	\caption{Isometrisch und Stückliste}
\end{figure}

\begin{figure}[ht!]
	 	
	\caption{Hauptträger}
\end{figure}

\begin{figure}[ht!]
	 	
	\caption{Hauptträger Isometrisch}
\end{figure}

\begin{figure}[ht!]
	 	
	\caption{Motorenhalterhalter}
\end{figure}

\begin{figure}[ht!]
	 	
	\caption{Motorenhalterung Oben}
\end{figure}
\begin{figure}[ht!]
	 	
	\caption{Motorenhalterung Unten}
\end{figure}
\begin{figure}[ht!]
	 	
	\caption{Innenfelge}
\end{figure}
\begin{figure}[ht!]
	 	
	\caption{Felge}
\end{figure}
\begin{figure}[ht!]
	 	
	\caption{Sigma}
\end{figure}
\begin{figure}[ht!]
	 	
	\caption{H-Brücken-Halterung}
\end{figure}
\begin{figure}[ht!]
	 	
	\caption{Akkuhalterung}
\end{figure}
\begin{figure}[ht!]
	 	
	\caption{Ei-Halterung-Halterung}
\end{figure}
\begin{figure}[ht!]
	 	
	\caption{Ei-Halterung}
\end{figure}
\begin{figure}[ht!]
	 	
	\caption{Reifen und Planetengetriebe}
\end{figure}
