Khodii/OmniMoveCar/Lastenheft - Niklas.docx

# Lastenheft (Praktikum Produktionstechnik)

## Ei Transportieren können(F)

Es wird gefordert, dass das finale Fahrzeug in der Lage ist, ein Ei über eine gewisse Distanz transportieren zu können.

## Abgabe Bericht 30.07(F)

Der abschließende Bericht des Projekts soll am 30.07.2019 vorliegen. Der Aufbau soll der Form des Musteraufbaus

MUSTERAUFBAU

- Deckblatt
- Inhaltsverzeichnis
- Abbildungs-/Tabellenverzeichnis
1. Einleitung
2. Hauptteil (Produktentwicklungsprozess)
3. Schluss (Ergebnisse und Zusammenfassung
- Anhang

folgen.

## Kosteneffizienz(F)

Da das Budget dieses Projektes begrenzt ist, ist darauf zu achten, dass das Fahrzeug sehr Kosteneffizient realisiert wird.

## Schnelles Fahren(F)

Da in der Logistikbranche immer Zeitdruck herrscht, besteht der Wusch, dass das Fahrzeug die zurückzulegende Strecke in möglichst kurzer Zeit bewältigt und sich deshalb mit hohem Tempo fortbewegt.
