Khodii/OmniMoveCar/Bericht/LaTeX/bilder/GetriebeV1.png

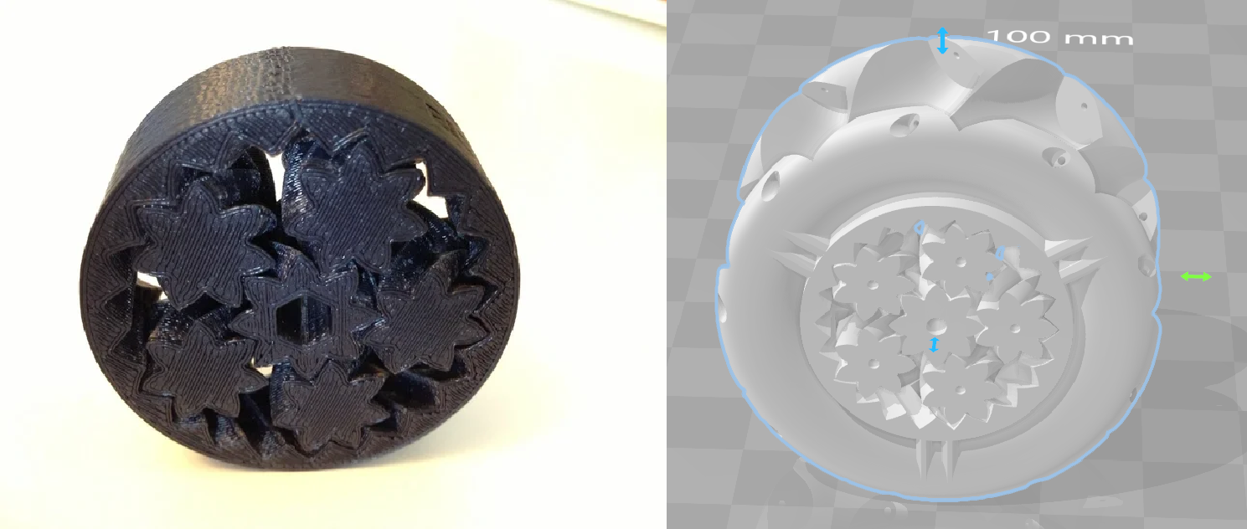
Bericht/LaTeX/bilder/GetriebeV1.png
