Khodii/OmniMoveCar/CAD/bms/bmsBack.jpg

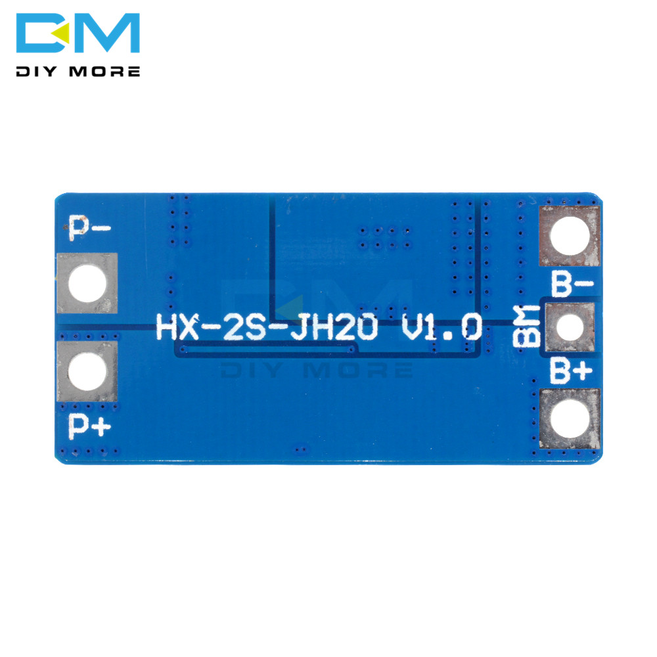
CAD/bms/bmsBack.jpg
