Khodii/OmniMoveCar/CAD/bms/bmsBackOnly.png

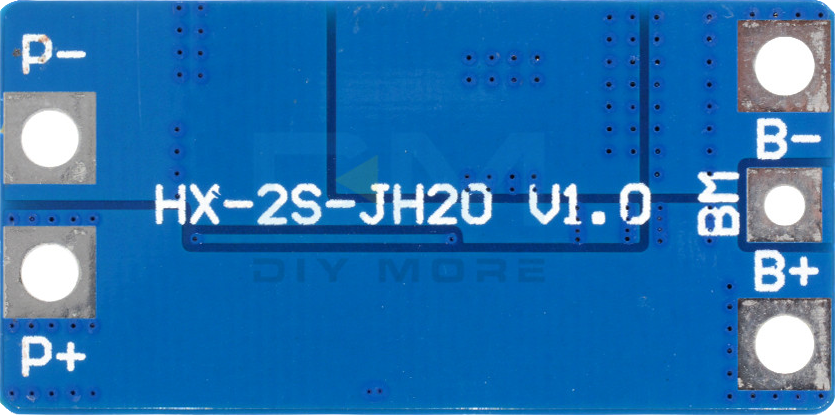
CAD/bms/bmsBackOnly.png
