Khodii/OmniMoveCar/CAD/bms/bmsFront.webp

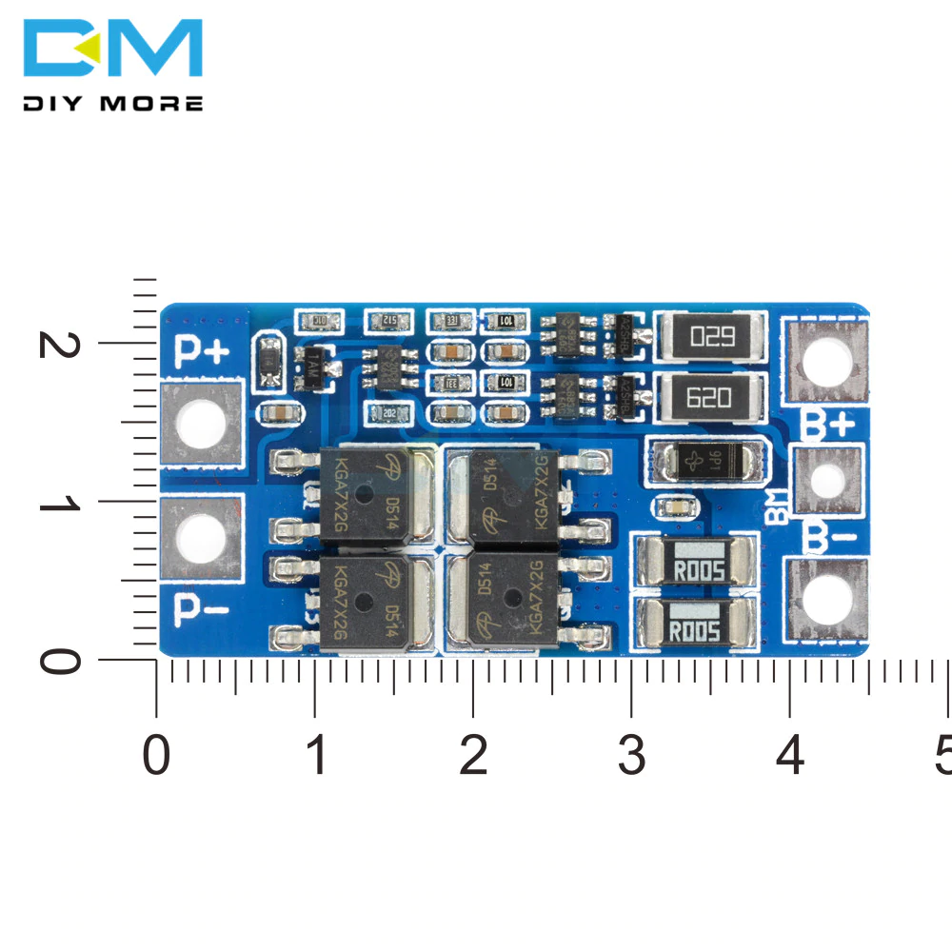
CAD/bms/bmsFront.webp
