Khodii/OmniMoveCar/CAD/bms/bmsFrontOnly.png

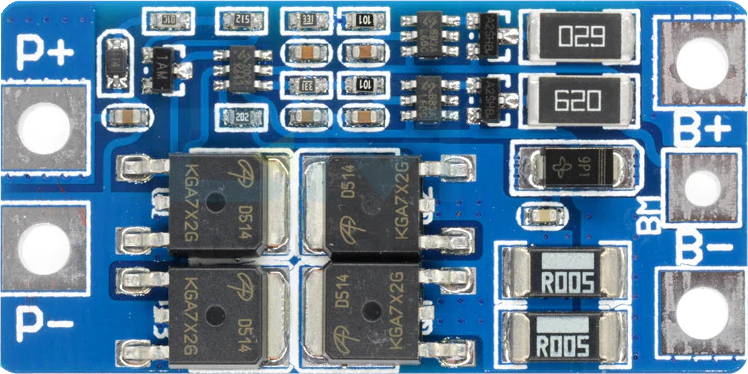
CAD/bms/bmsFrontOnly.png
