Khodii/OmniMoveCar/CAD/renders/creo2.jpg

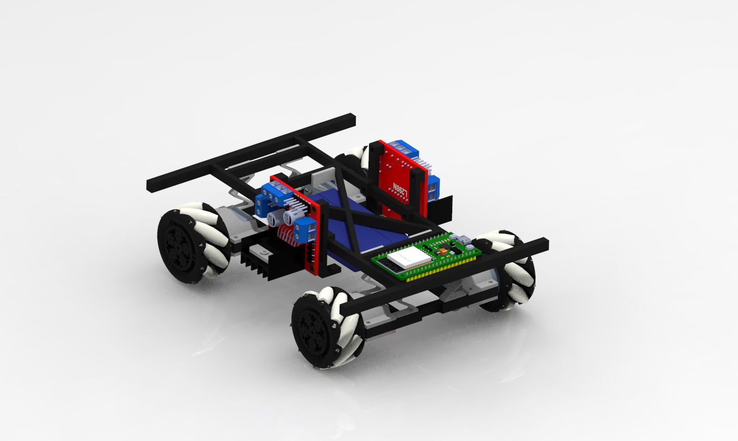
CAD/renders/creo2.jpg
