Khodii/OmniMoveCar/CAD/renders/creo.jpg

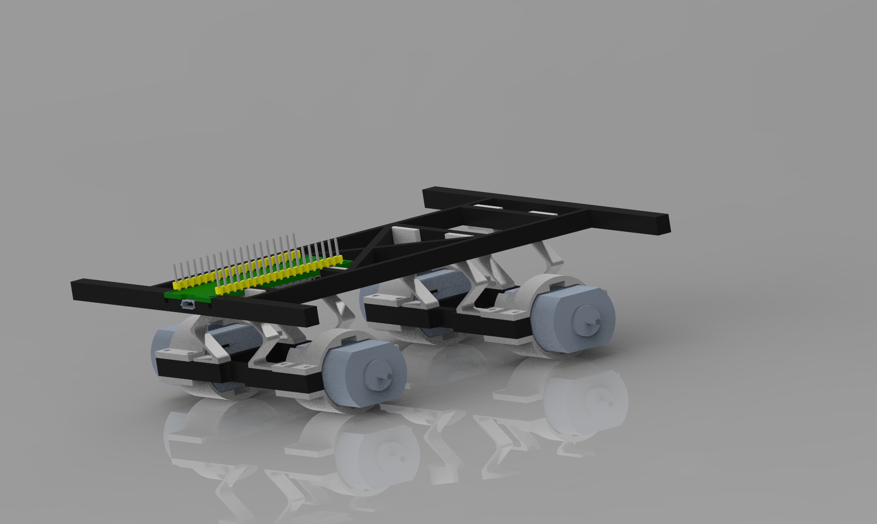
CAD/renders/creo.jpg
