Khodii/OmniMoveCar/CAD/renders/screenshot2.png

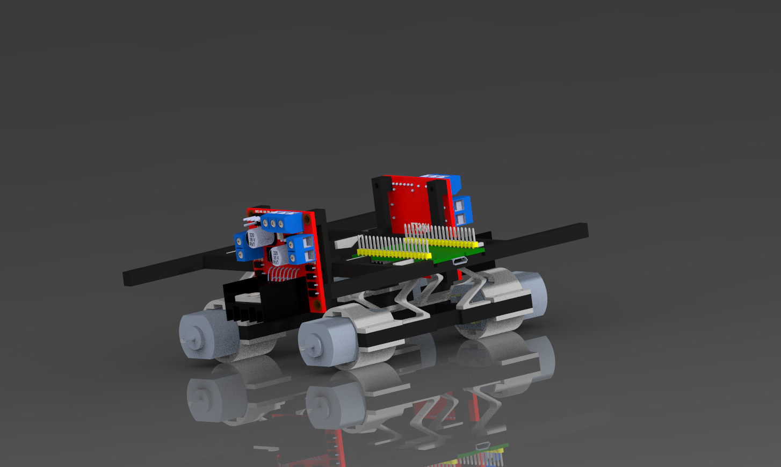
CAD/renders/screenshot2.png
