Khodii/OmniMoveCar/Code_GUI/ProduktionstechnikPraktikum/resources/robot2.PNG

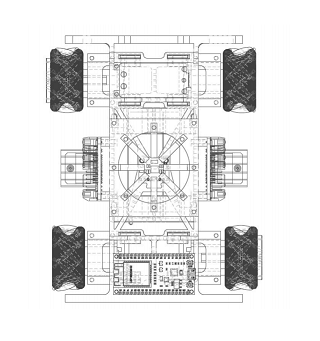
Code_GUI/ProduktionstechnikPraktikum/resources/robot2.PNG
