Khodii/OmniMoveCar/render.jpg

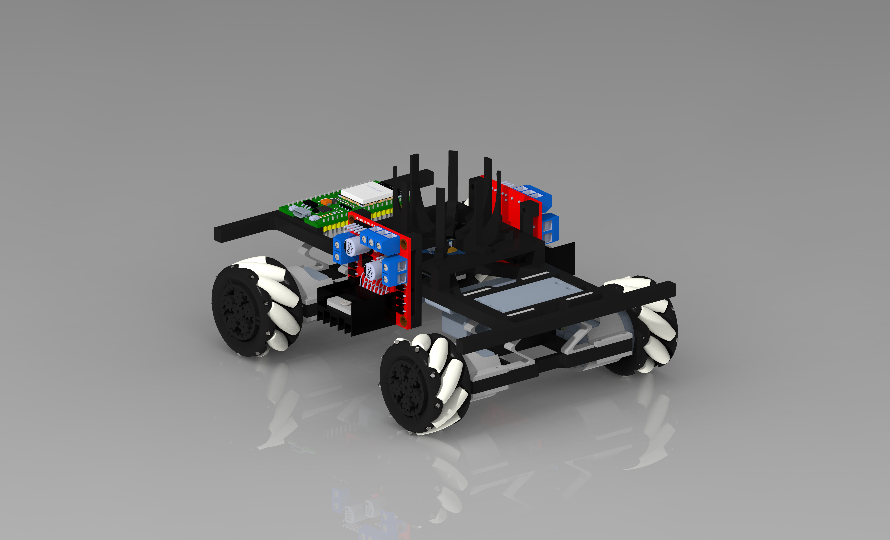
render.jpg
