Khodii/OmniMoveCar/skizzen/skizzenNiklas/Vorlagen/Front.PNG

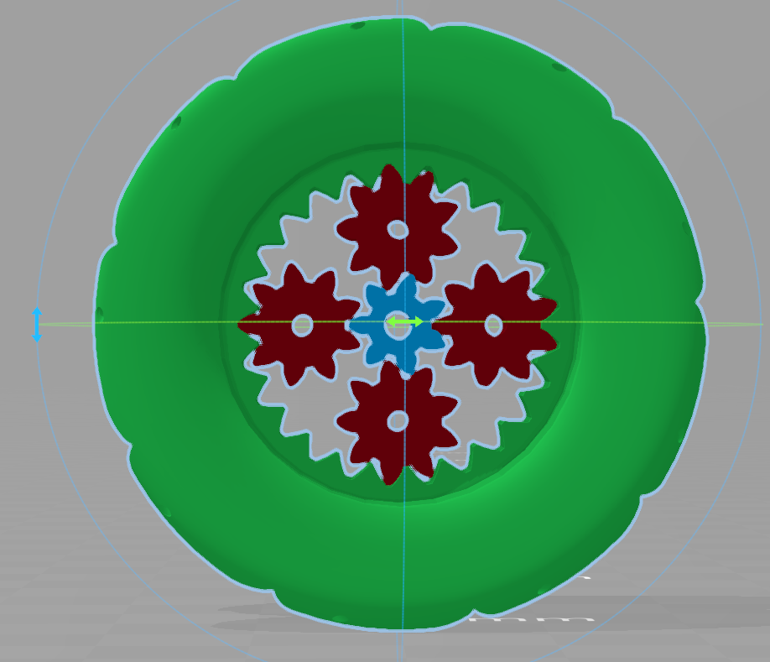
skizzen/skizzenNiklas/Vorlagen/Front.PNG
