Khodii/OmniMoveCar/skizzen/skizzenNiklas/Vorlagen/Rück.PNG

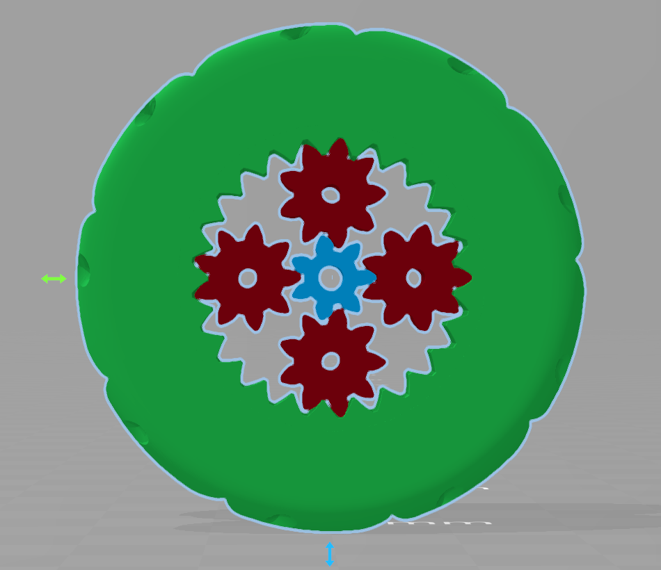
skizzen/skizzenNiklas/Vorlagen/Rück.PNG
