Khodii/OmniMoveCar/skizzen/skizzenNiklas/Vorlagen/SeiteLeer.PNG

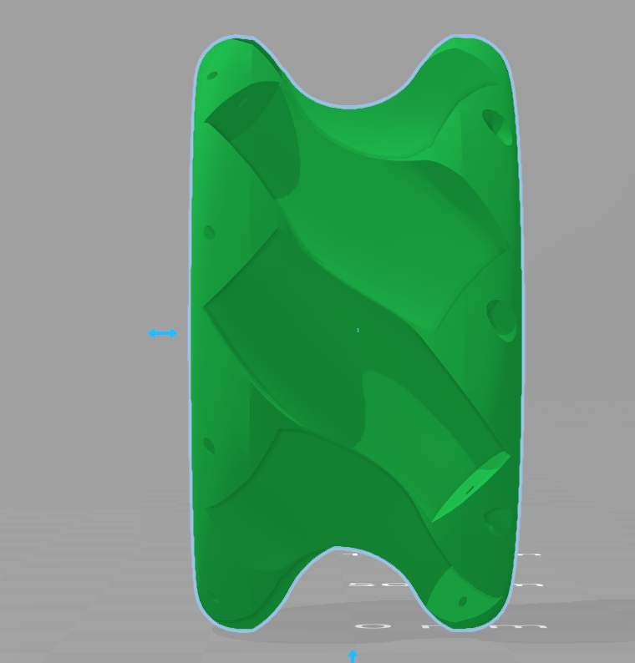
skizzen/skizzenNiklas/Vorlagen/SeiteLeer.PNG
