Khodii/OmniMoveCar/skizzen/skizzenNiklas/Vorlagen/SeiteVoll.PNG

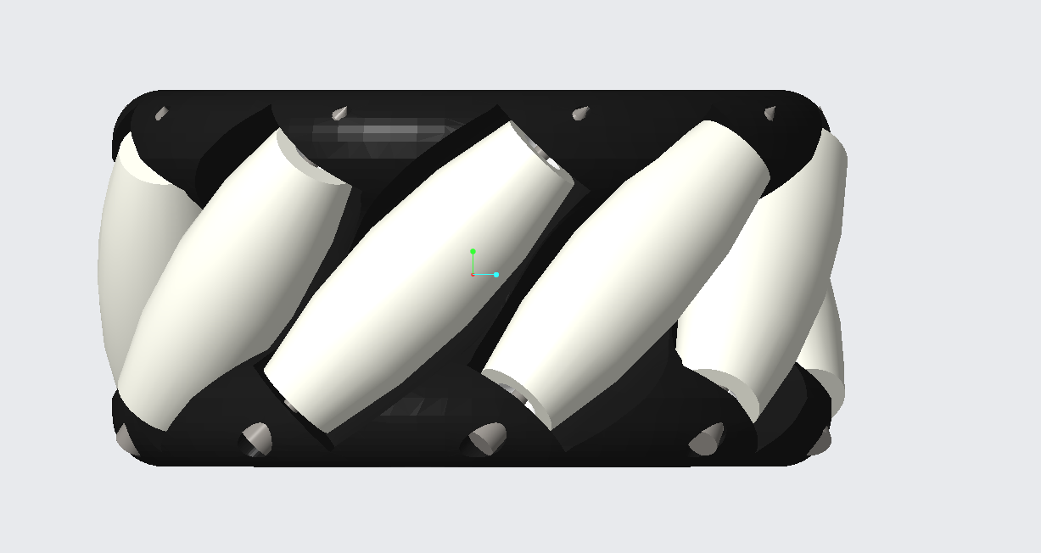
skizzen/skizzenNiklas/Vorlagen/SeiteVoll.PNG
