Khodii/OmniMoveCar/skizzen/skizzenNiklas/Vorlagen/standard.PNG

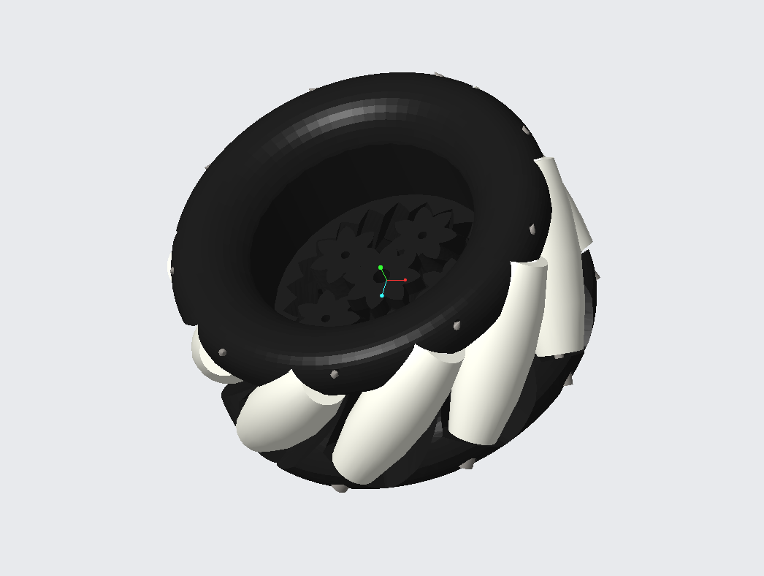
skizzen/skizzenNiklas/Vorlagen/standard.PNG
