Khodii/OmniMoveCar/CAD/imports/H-Brücke/l298n-stepper-motor-driver-red-1.snapshot.3/L298N Stepper Motor Driver (Red).SLDASM

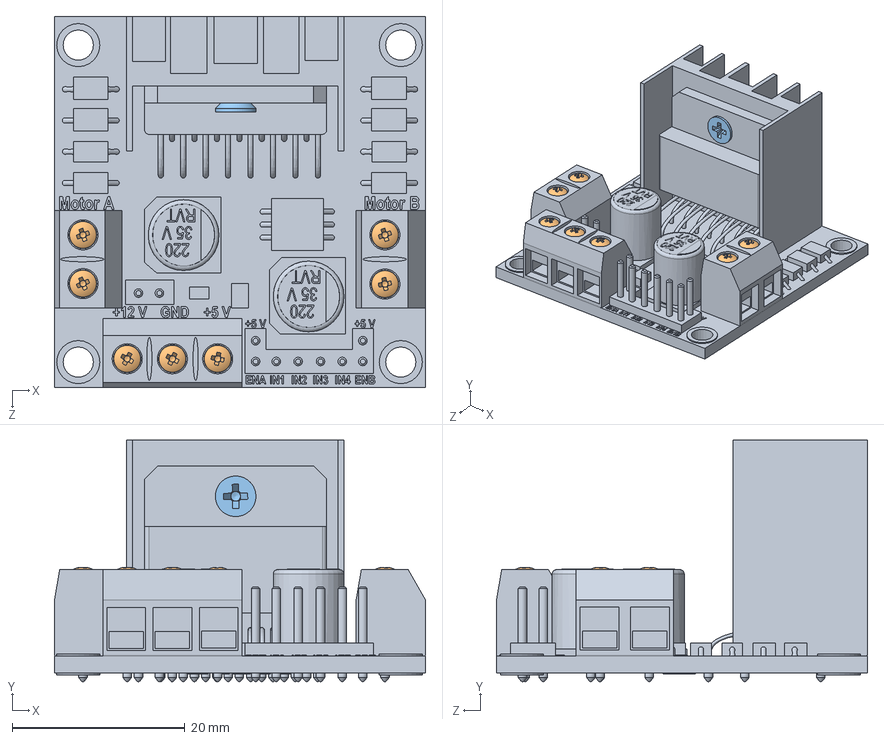
[picture p80: CAD file, 2019-05-23]
CAD/imports/H-Brücke/l298n-stepper-motor-driver-red-1.snapshot.3/L298N Stepper Motor Driver (Red).SLDASM
43.0 x 28.0 x 43.0 mm
L298N Stepper Motor Driver (Red)
pan head cross recess screw_iso x 7
countersunk flat head cross recess screw_iso
