Khodii/OmniMoveCar/Models/2stepgetriebe/SunMain.obj

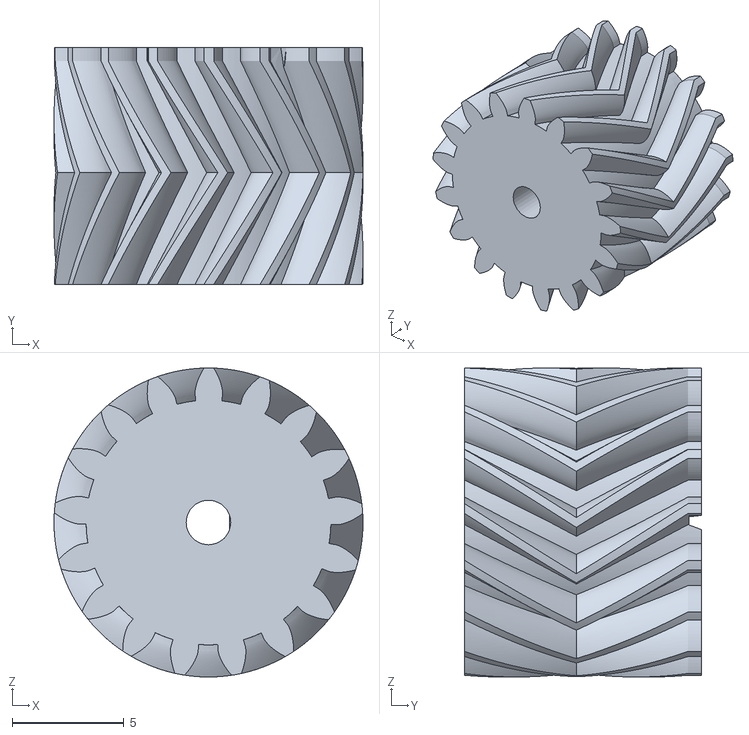
[picture p81: CAD file, 2019-06-13]
Models/2stepgetriebe/SunMain.obj
13.8 x 10.6 x 13.8
