Khodii/OmniMoveCar/24mm_customized_Gear_Bearing/3P6S11.stl

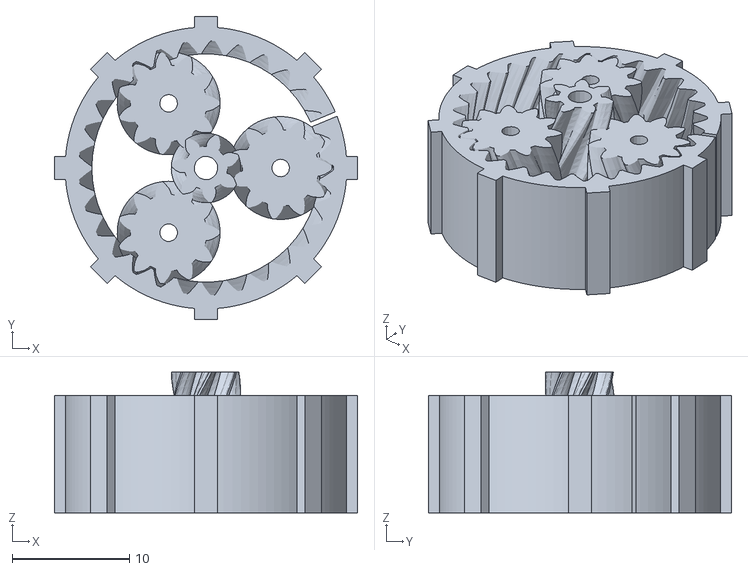
[picture p82: CAD file, 2019-07-22]
24mm_customized_Gear_Bearing/3P6S11.stl
25.8 x 25.8 x 12.0
