Khodii/OmniMoveCar/24mm_customized_Gear_Bearing/files/bearing_20190520-61-6oq5m5.stl

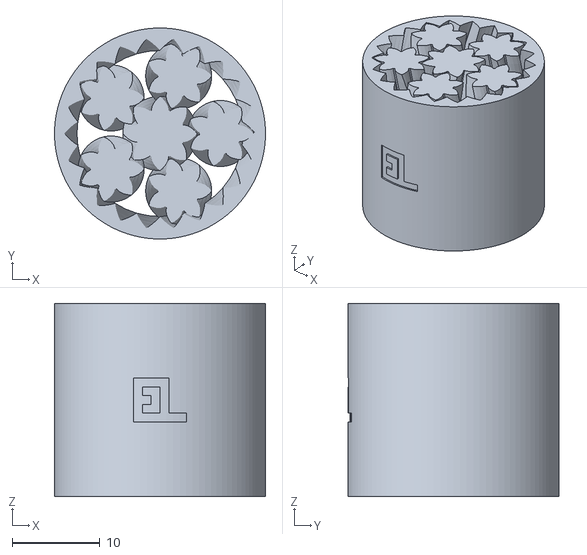
[picture p83: CAD file, 2019-05-20]
24mm_customized_Gear_Bearing/files/bearing_20190520-61-6oq5m5.stl
24.0 x 24.0 x 22.0
