Khodii/OmniMoveCar/44mm_Mecanum_Wheel_Small_Solid_and_Low_Cost/files/Body_Right.STL

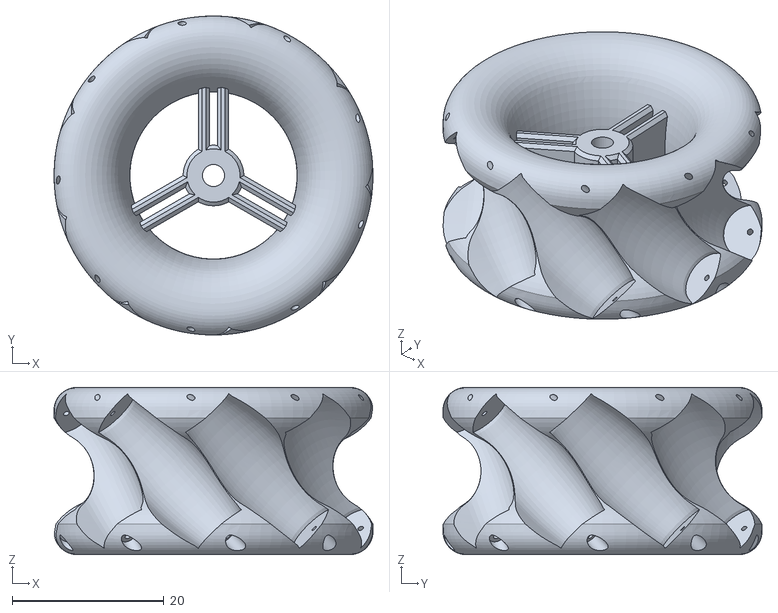
[picture p84: CAD file, 2019-05-18]
44mm_Mecanum_Wheel_Small_Solid_and_Low_Cost/files/Body_Right.STL
42.0 x 42.0 x 22.0
