Khodii/OmniMoveCar/44mm_Mecanum_Wheel_Small_Solid_and_Low_Cost/TestRing24mm.stl

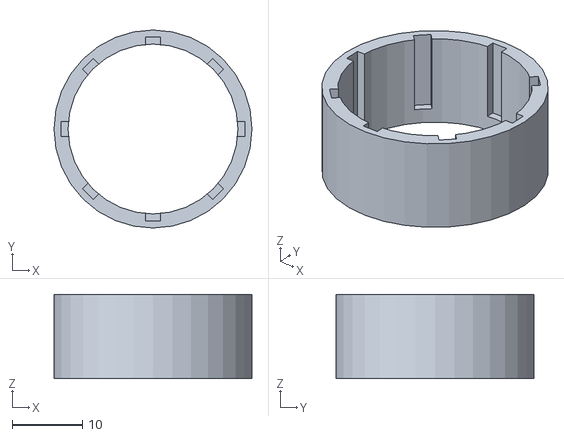
[picture p85: CAD file, 2019-07-22]
44mm_Mecanum_Wheel_Small_Solid_and_Low_Cost/TestRing24mm.stl
28.2 x 28.2 x 12.0
