Khodii/OmniMoveCar/66CompMod/2StageGearsSun2mm.stl

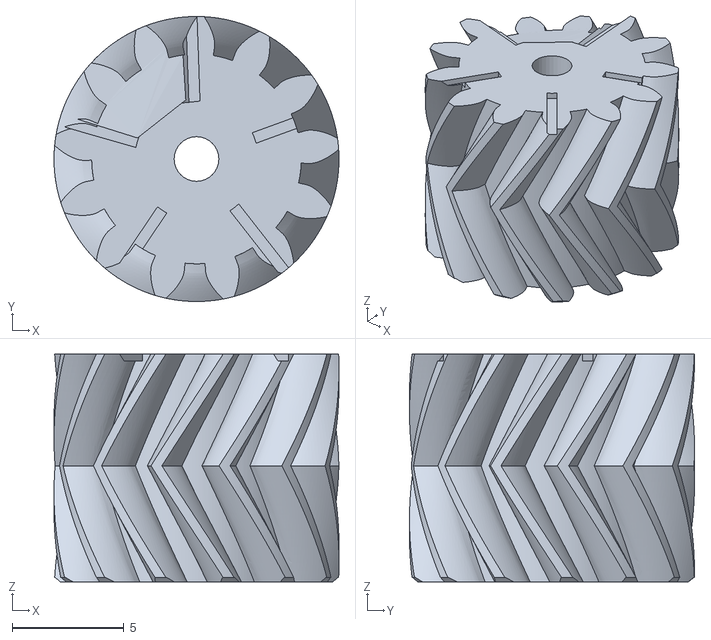
[picture p86: CAD file, 2019-07-22]
66CompMod/2StageGearsSun2mm.stl
12.8 x 12.8 x 10.2
