Khodii/OmniMoveCar/Abgabe M3/STL-Modelle/PLA/motortrger0.stl

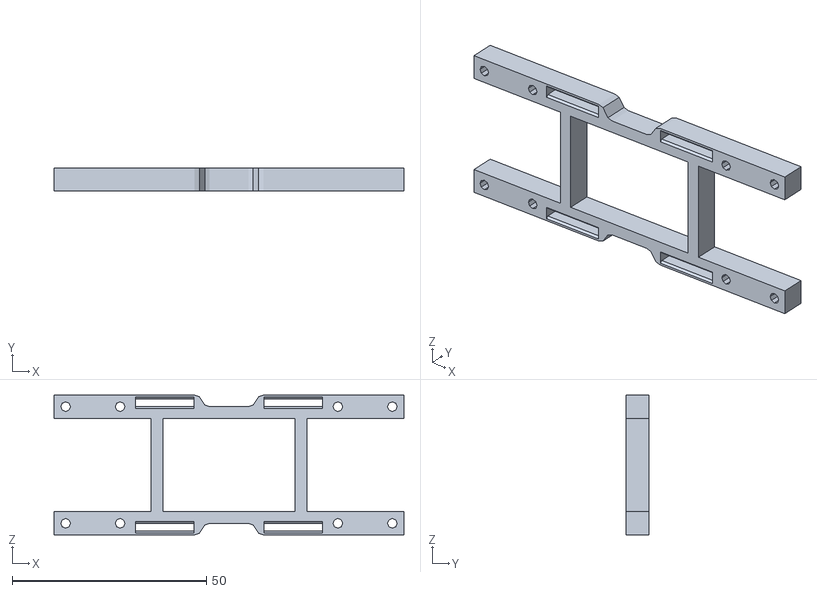
[picture p87: CAD file, 2019-06-12]
Abgabe M3/STL-Modelle/PLA/motortrger0.stl
90.0 x 6.00 x 36.0
