Khodii/OmniMoveCar/Abgabe M3/STL-Modelle/TPU/motorhalterungoben.stl

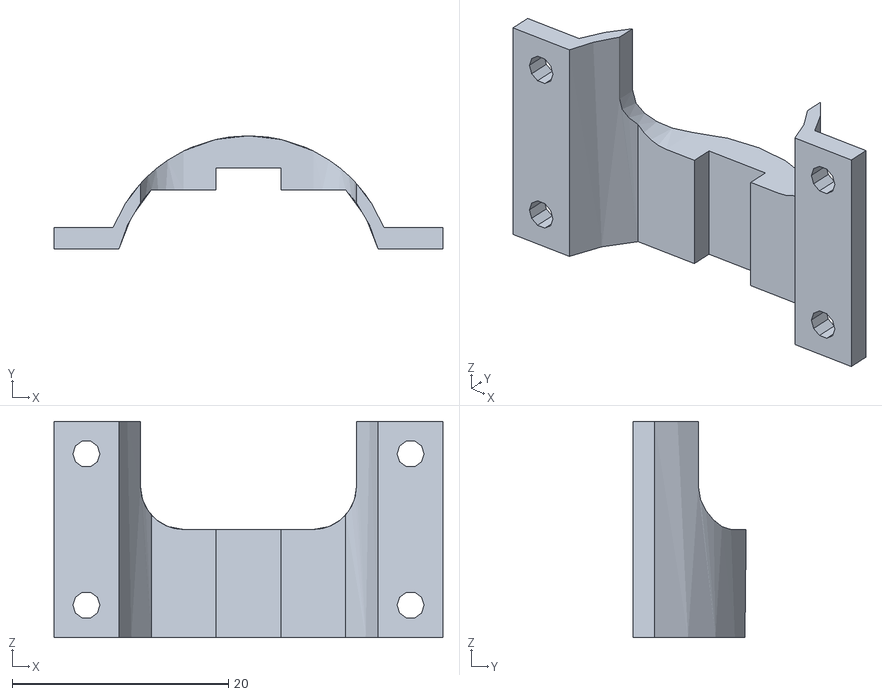
[picture p88: CAD file, 2019-06-12]
Abgabe M3/STL-Modelle/TPU/motorhalterungoben.stl
36.0 x 10.5 x 20.0
