Khodii/OmniMoveCar/CAD/exports/motorgetriebehalterung.stl

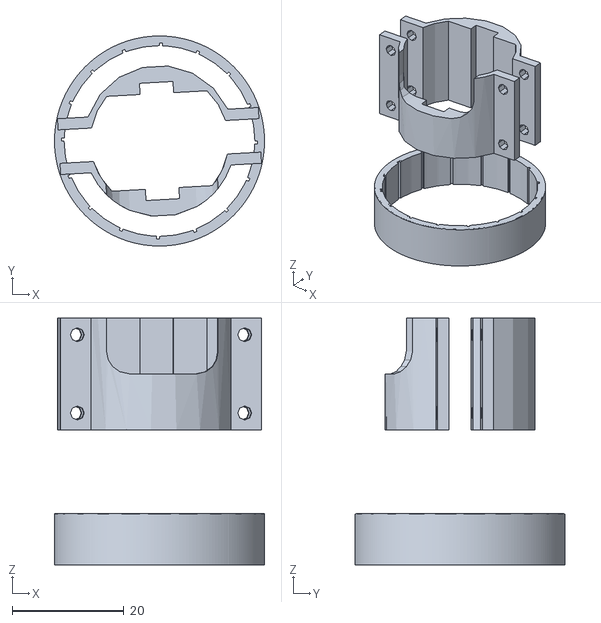
[picture p89: CAD file, 2019-06-27]
CAD/exports/motorgetriebehalterung.stl
37.6 x 37.6 x 44.2
