Khodii/OmniMoveCar/CAD/exports/PLA/eierhalterpins.stl

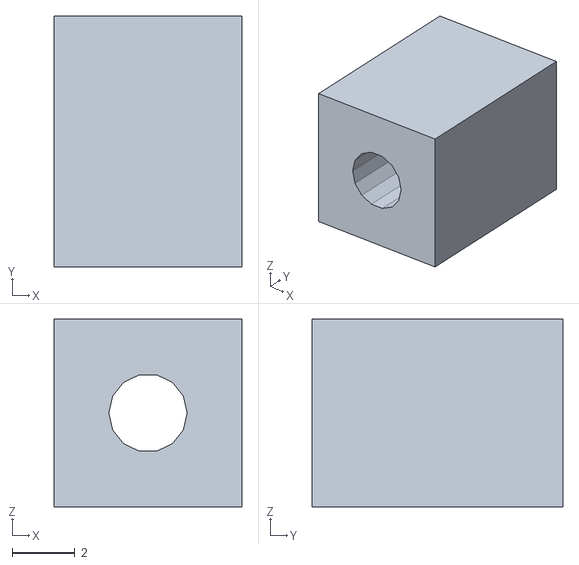
[picture p90: CAD file, 2019-07-22]
CAD/exports/PLA/eierhalterpins.stl
6.00 x 8.00 x 6.00
