Khodii/OmniMoveCar/CAD/exports/TPU/motorhalterungoben.stl

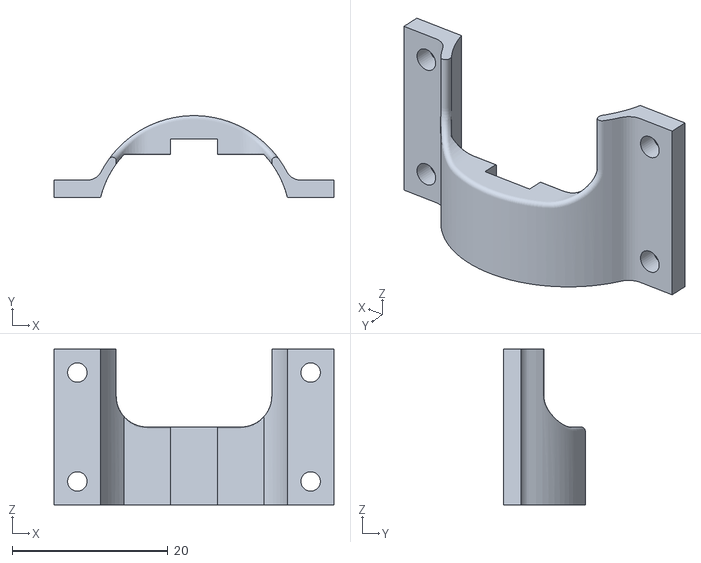
[picture p91: CAD file, 2019-07-22]
CAD/exports/TPU/motorhalterungoben.stl
36.0 x 10.5 x 20.0
