Khodii/OmniMoveCar/CAD/imports/gyro/mpu6050-1.snapshot.1/MPU_6050.step

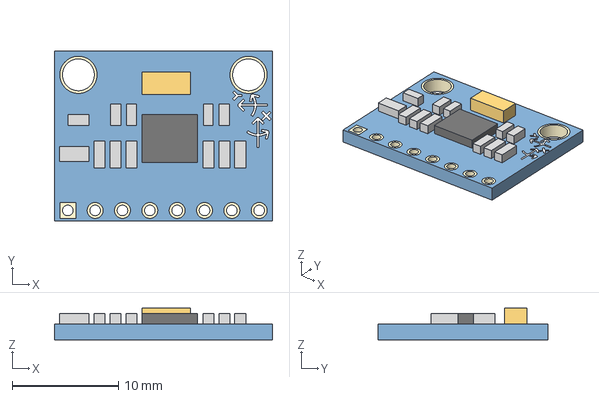
[picture p92: CAD file, 2019-05-24]
CAD/imports/gyro/mpu6050-1.snapshot.1/MPU_6050.step
20.5 x 16.0 x 3.00 mm
