Khodii/OmniMoveCar/CAD/imports/lipo/turnigy-nanotech-battery-1800mah-2s-1.snapshot.13/3D VIEW - Turnigy Batterie Nanotech 1800mAh 2S.IGS

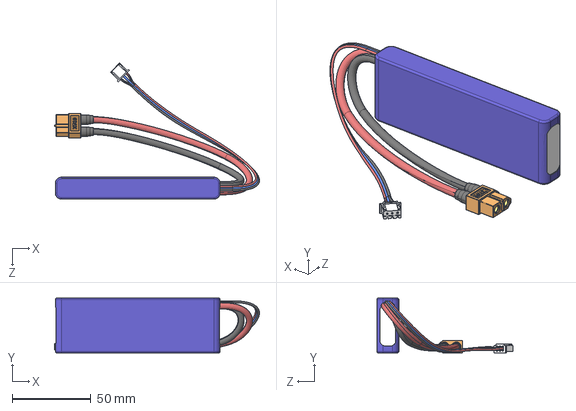
[picture p93: CAD file, 2019-05-23]
CAD/imports/lipo/turnigy-nanotech-battery-1800mah-2s-1.snapshot.13/3D VIEW - Turnigy Batterie Nanotech 1800mAh 2S.IGS
130.5 x 35.0 x 86.8 mm
