Khodii/OmniMoveCar/CAD/imports/lipo2/turnigy-nanotech-950mah-2s-25-50c-lipo-1.snapshot.4/Battery.step

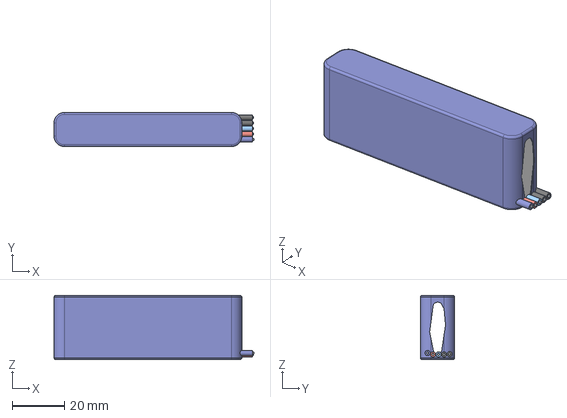
[picture p94: CAD file, 2019-05-24]
CAD/imports/lipo2/turnigy-nanotech-950mah-2s-25-50c-lipo-1.snapshot.4/Battery.step
76.2 x 13.0 x 24.5 mm
