Khodii/OmniMoveCar/CAD/imports/XT60/xt60-connector-1.snapshot.4/XT60 Connectors.stp

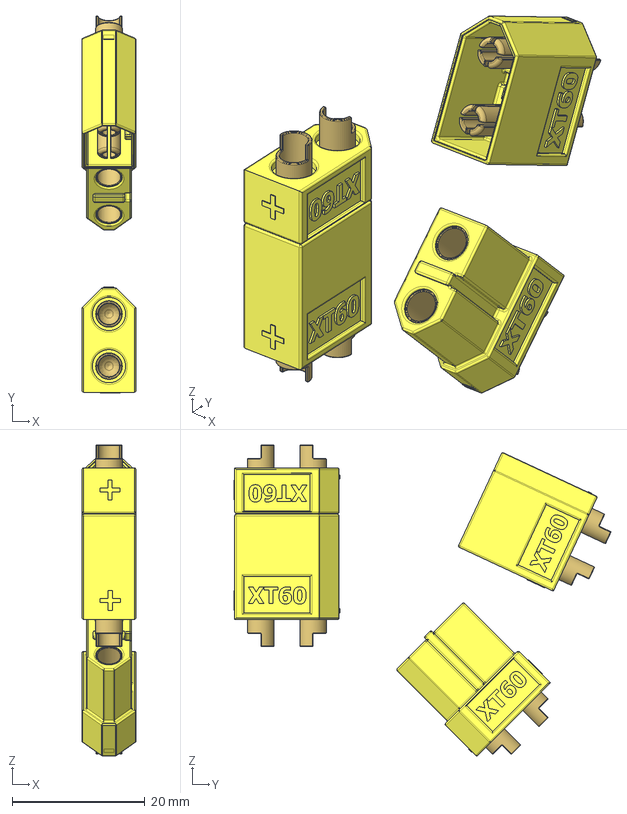
[picture p95: CAD file, 2019-05-23]
CAD/imports/XT60/xt60-connector-1.snapshot.4/XT60 Connectors.stp
8.13 x 56.8 x 46.9 mm
XT60 Connector Male Housing x 2
XT60 Connector Male Contact x 4
XT60 Connector Female Housing x 2
XT60 Connector Female Contact x 4
