Khodii/OmniMoveCar/CAD/sonstiges/testholeslarge.stl

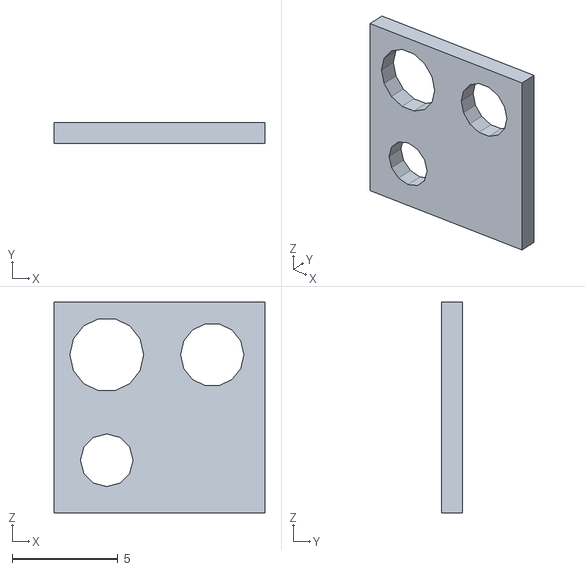
[picture p96: CAD file, 2019-07-02]
CAD/sonstiges/testholeslarge.stl
10.0 x 1.00 x 10.0
