Khodii/OmniMoveCar/CAD/wheels/getriebehalterunginnen.stl

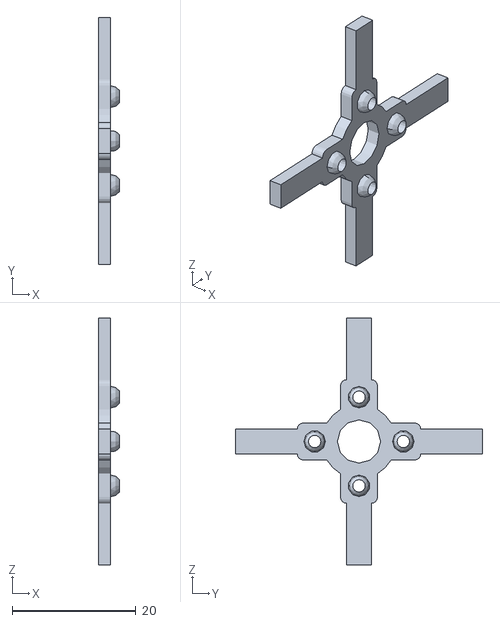
[picture p97: CAD file, 2019-07-02]
CAD/wheels/getriebehalterunginnen.stl
3.44 x 40.0 x 40.0
