Khodii/OmniMoveCar/currgetriebe/omni.stl

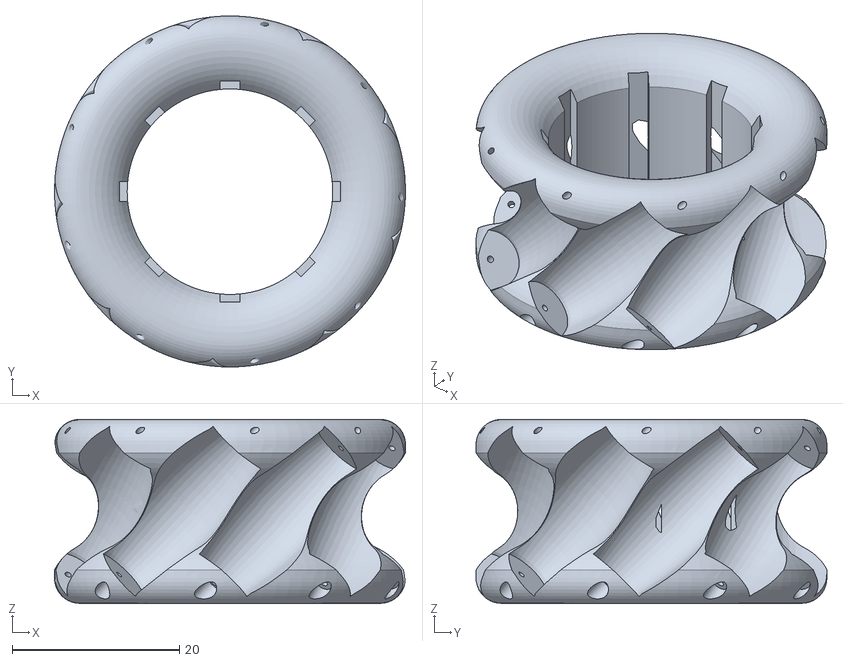
[picture p98: CAD file, 2019-07-22]
currgetriebe/omni.stl
42.0 x 42.0 x 22.0
