Khodii/OmniMoveCar/diffwheeltest/3_18_6.stl

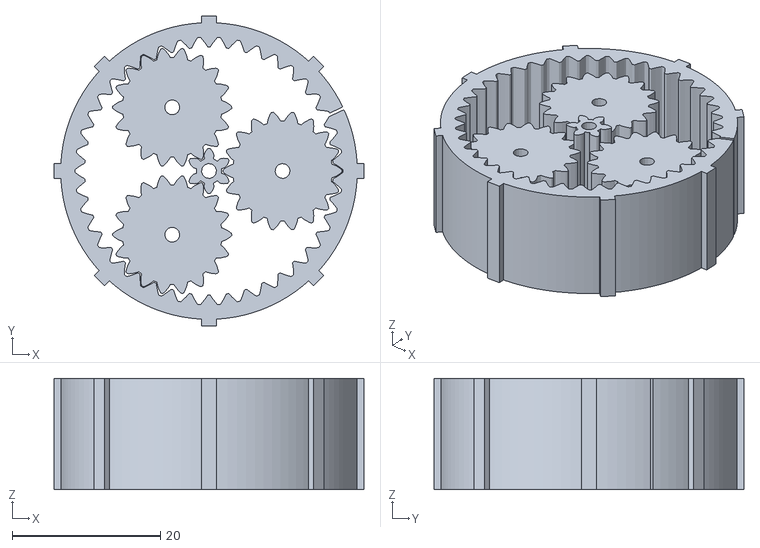
[picture p99: CAD file, 2019-07-22]
diffwheeltest/3_18_6.stl
41.8 x 41.8 x 15.0
