Khodii/OmniMoveCar/GetriebeVersionen/0,15.stl

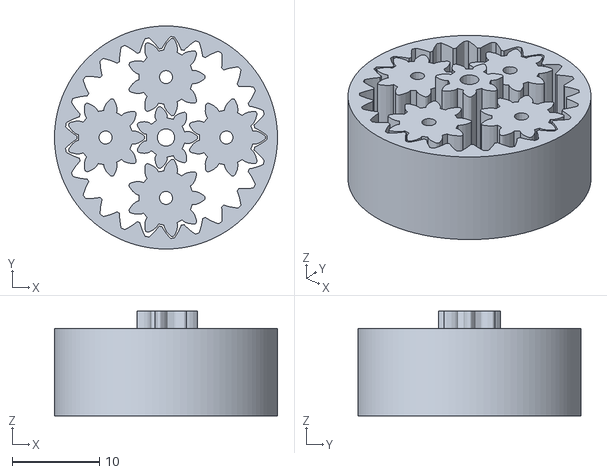
[picture p100: CAD file, 2019-06-10]
GetriebeVersionen/0,15.stl
25.5 x 25.5 x 12.0
