Khodii/OmniMoveCar/Models/2stepgetriebe/GearRing2.obj

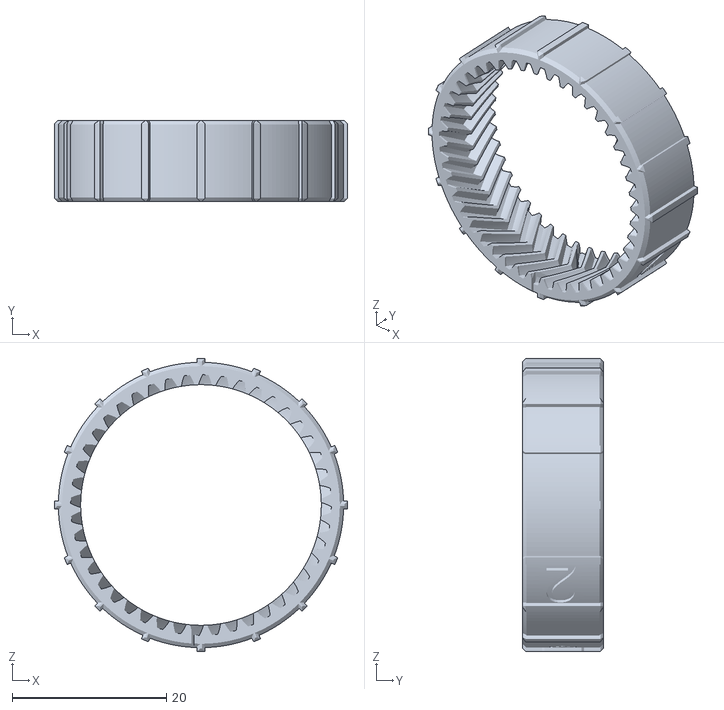
[picture p101: CAD file, 2019-06-13]
Models/2stepgetriebe/GearRing2.obj
38.0 x 10.5 x 38.0
