Khodii/OmniMoveCar/Models/MecanumInseredDoubleGearHalterungInnen.stl

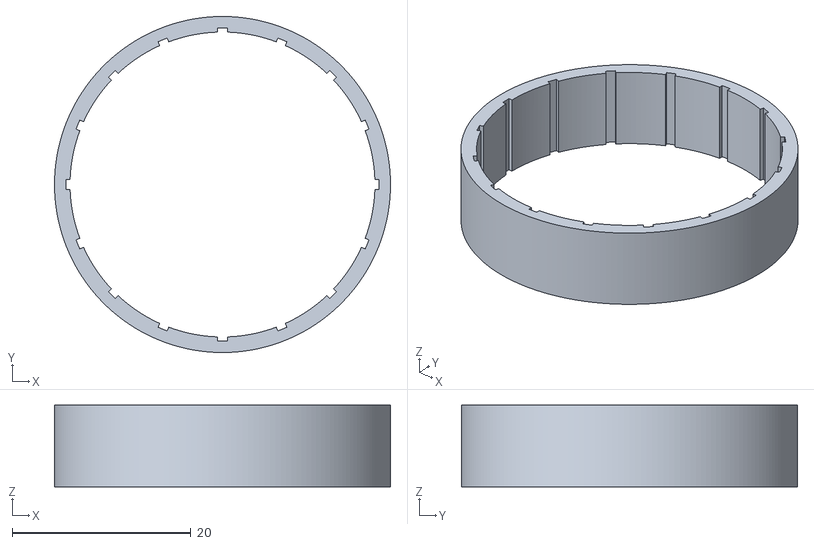
[picture p102: CAD file, 2019-06-13]
Models/MecanumInseredDoubleGearHalterungInnen.stl
37.6 x 37.6 x 9.17
