Khodii/OmniMoveCar/newgeartests/4_8_8_0,5.stl

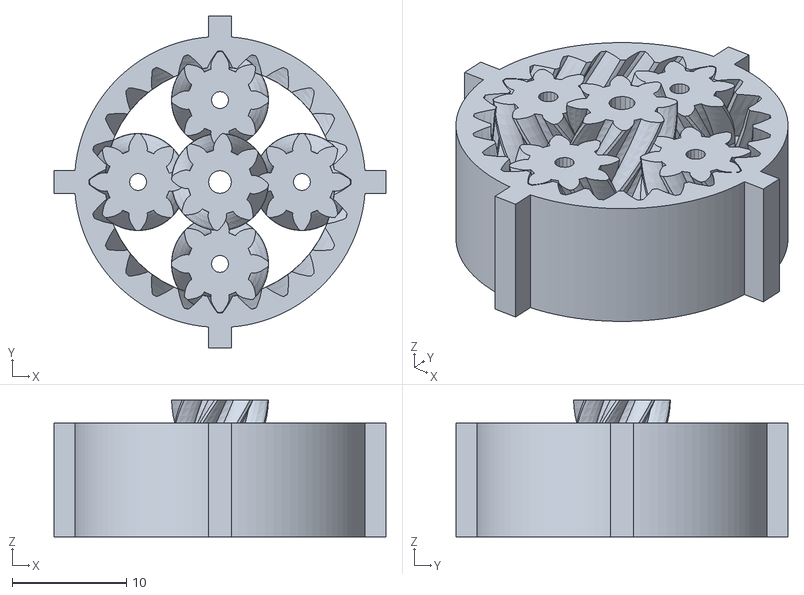
[picture p103: CAD file, 2019-07-02]
newgeartests/4_8_8_0,5.stl
29.1 x 29.1 x 12.0
