Khodii/OmniMoveCar/newgeartests/owncomp/owncompoundgears.stl

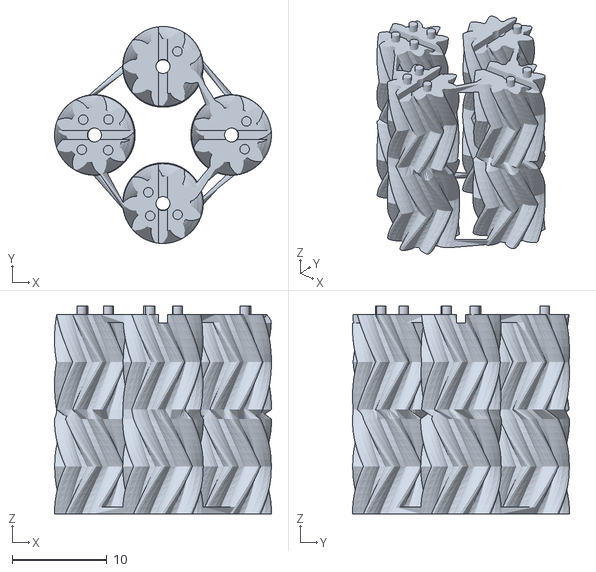
[picture p104: CAD file, 2019-07-02]
newgeartests/owncomp/owncompoundgears.stl
22.9 x 22.9 x 21.9
