Khodii/OmniMoveCar/Teggla/43524613/files/Tesla_Keychain.stl

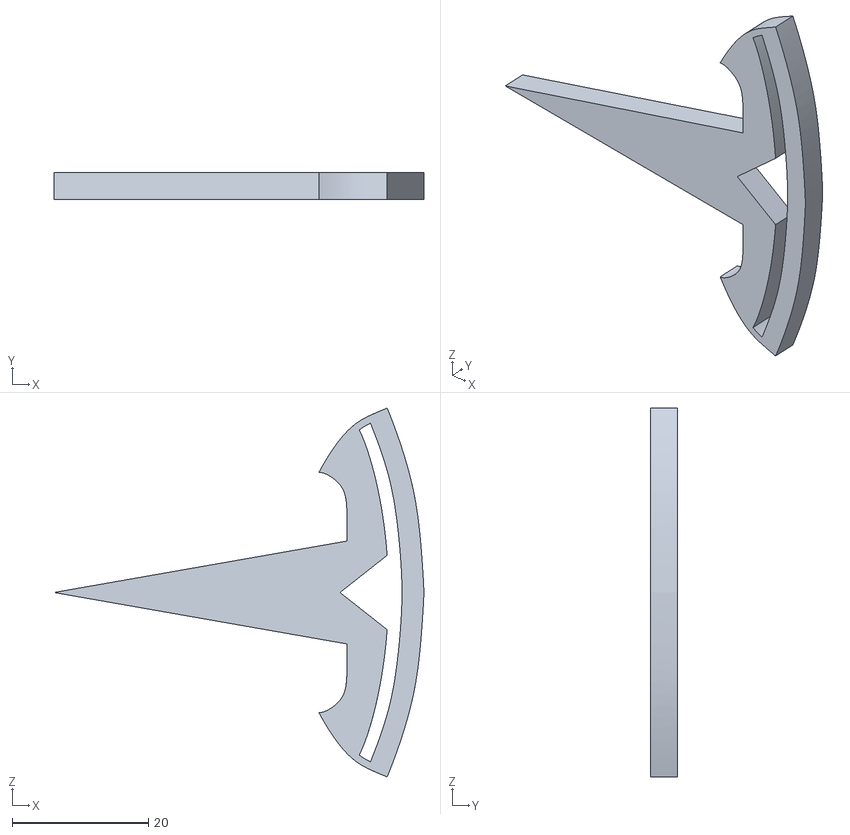
[picture p105: CAD file, 2019-07-22]
Teggla/43524613/files/Tesla_Keychain.stl
54.3 x 4.00 x 54.2
