Khodii/OmniMoveCar/24mm_customized_Gear_Bearing/codeFor3P14S7.stl

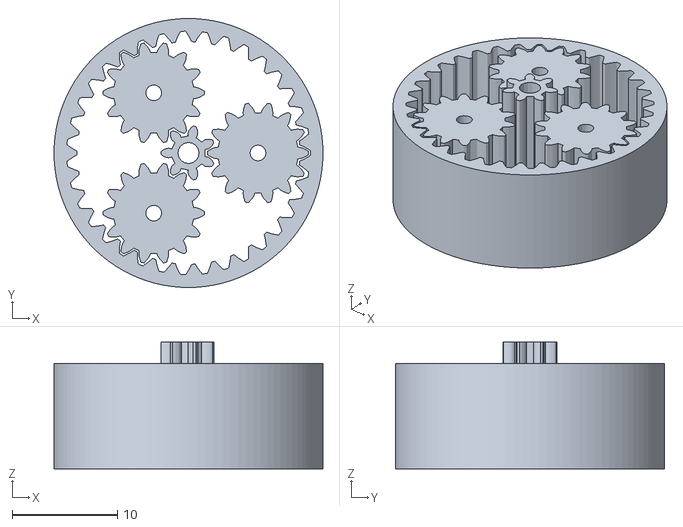
[picture p106: CAD file, 2019-06-10]
24mm_customized_Gear_Bearing/codeFor3P14S7.stl
25.5 x 25.5 x 12.0
