Khodii/OmniMoveCar/44mm_Mecanum_Wheel_Small_Solid_and_Low_Cost/files/bottom.STL

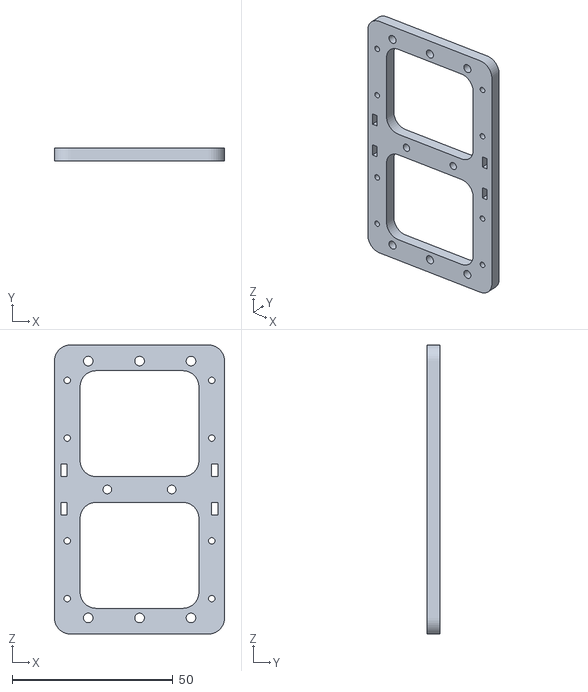
[picture p107: CAD file, 2019-05-18]
44mm_Mecanum_Wheel_Small_Solid_and_Low_Cost/files/bottom.STL
53.0 x 4.00 x 90.0
