Khodii/OmniMoveCar/66CompMod/Ring_Closures_For_Test.stl

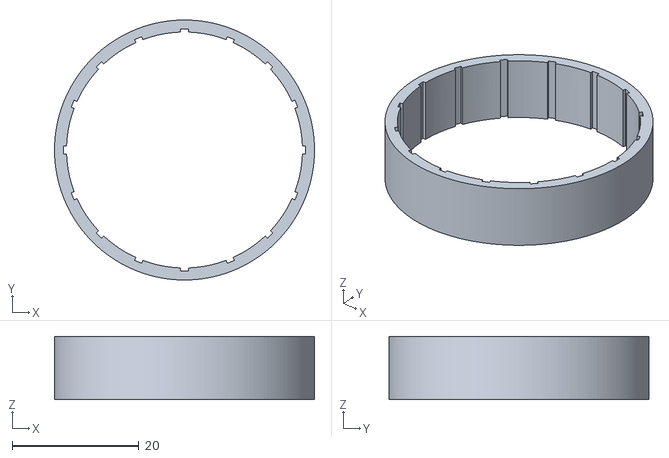
[picture p108: CAD file, 2019-07-02]
66CompMod/Ring_Closures_For_Test.stl
41.0 x 41.0 x 10.0
