Khodii/OmniMoveCar/Abgabe M3/STL-Modelle/PLA/akkuhalterung.stl

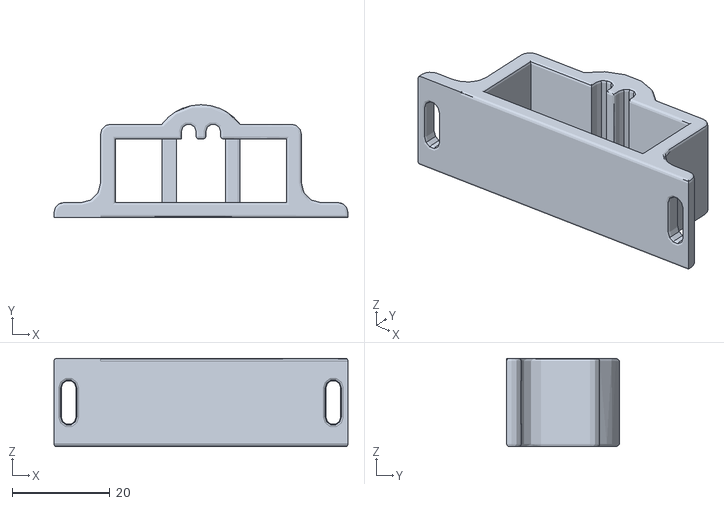
[picture p109: CAD file, 2019-06-12]
Abgabe M3/STL-Modelle/PLA/akkuhalterung.stl
60.0 x 23.0 x 18.0
