Khodii/OmniMoveCar/Abgabe M3/STL-Modelle/TPU/felge.stl

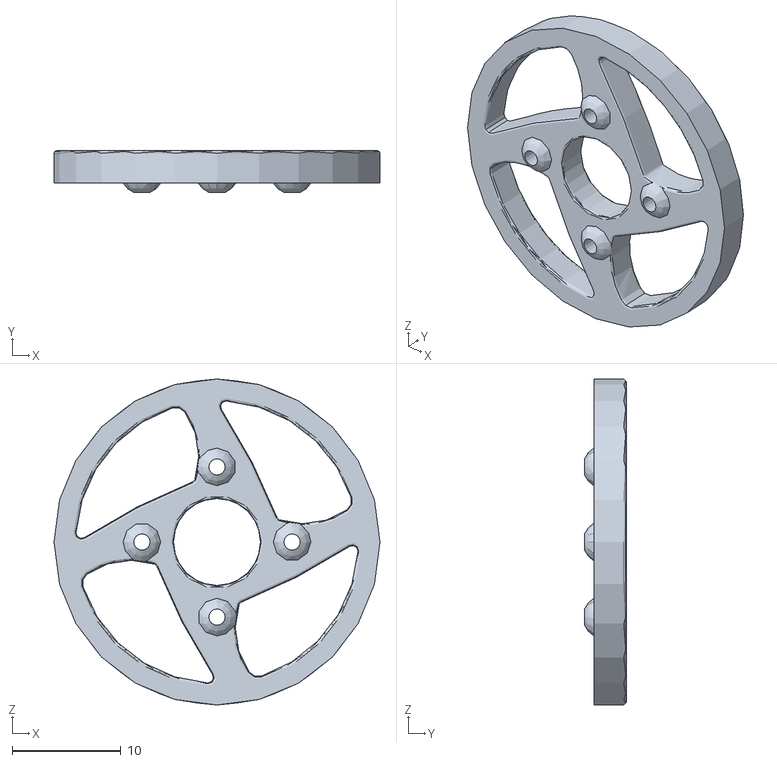
[picture p110: CAD file, 2019-06-12]
Abgabe M3/STL-Modelle/TPU/felge.stl
30.0 x 3.85 x 30.0
