Khodii/OmniMoveCar/CAD/exports/PLA/frontbumperreplacement.stl

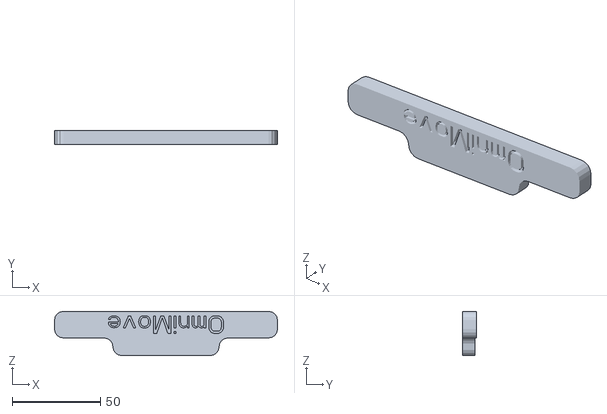
[picture p111: CAD file, 2019-07-22]
CAD/exports/PLA/frontbumperreplacement.stl
126.0 x 8.00 x 25.0
