Khodii/OmniMoveCar/CAD/exports/TPU/sigma.stl

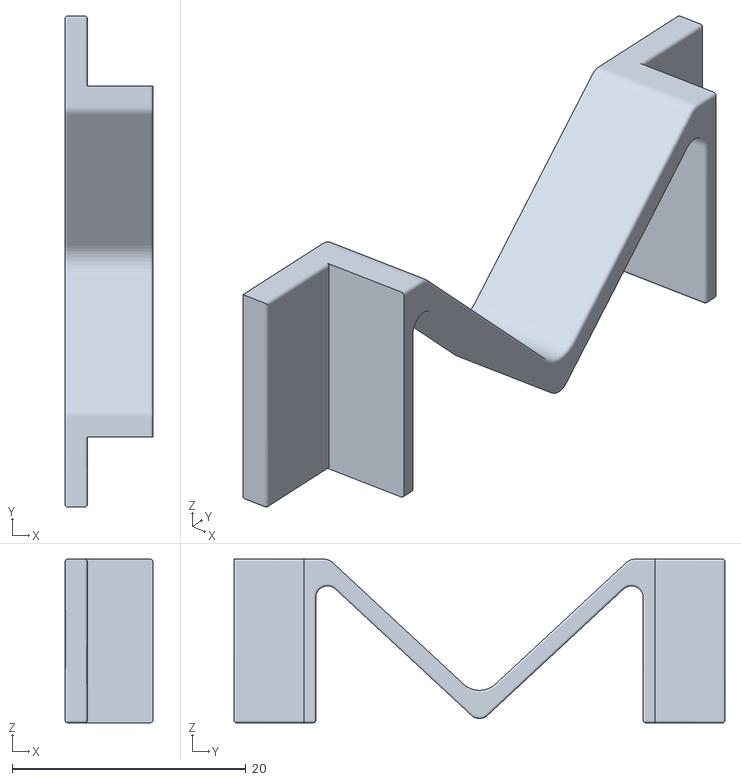
[picture p112: CAD file, 2019-07-22]
CAD/exports/TPU/sigma.stl
7.50 x 42.0 x 14.0
