Khodii/OmniMoveCar/CAD/sonstiges/testholes.stl

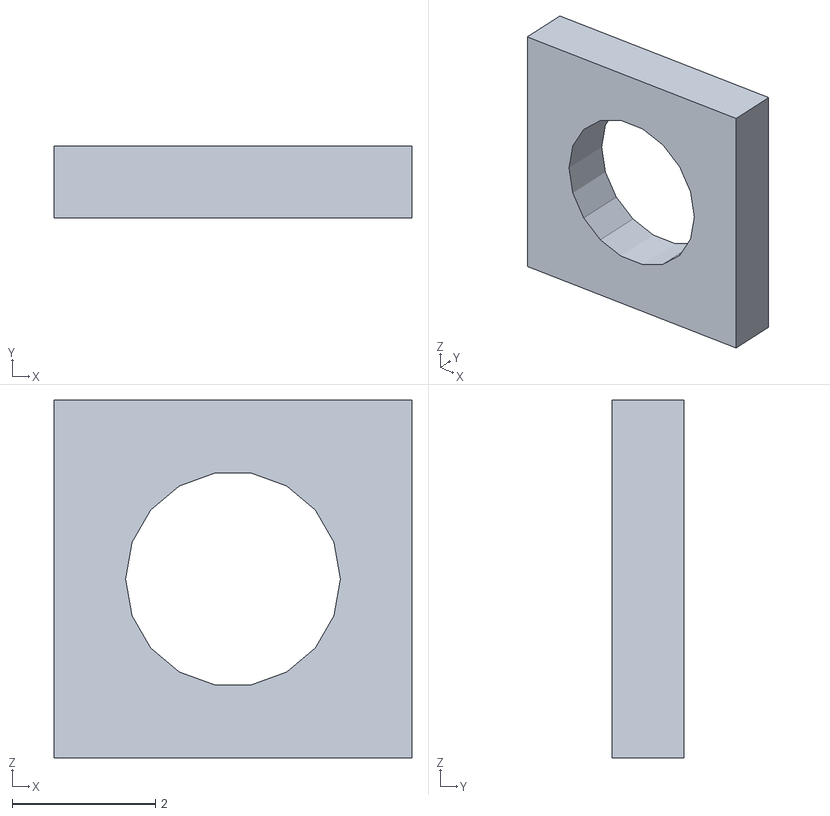
[picture p113: CAD file, 2019-07-02]
CAD/sonstiges/testholes.stl
5.00 x 1.00 x 5.00
