Khodii/OmniMoveCar/currgetriebe/getrGerade.stl

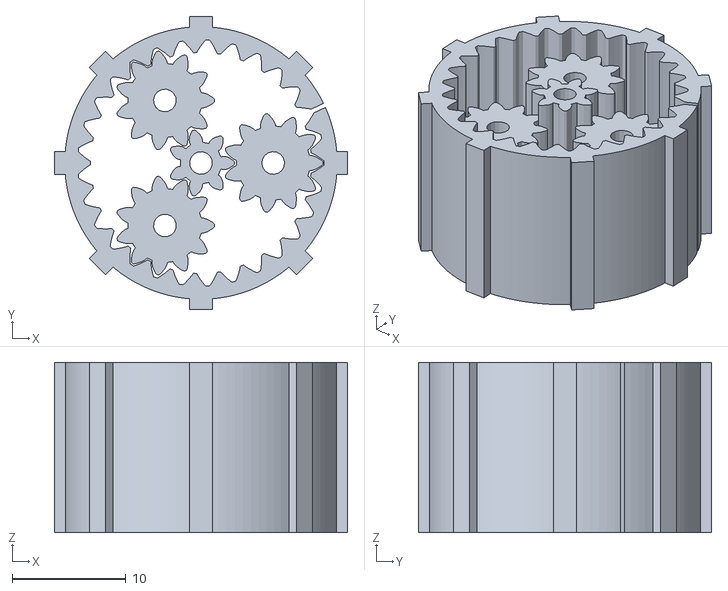
[picture p114: CAD file, 2019-07-22]
currgetriebe/getrGerade.stl
25.8 x 25.8 x 15.0
