Khodii/OmniMoveCar/Models/MecanumPlanetGearNew2Left.stl

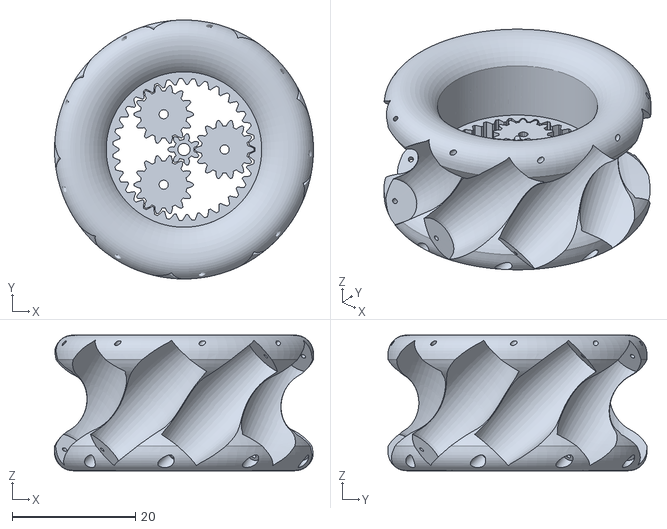
[picture p115: CAD file, 2019-06-10]
Models/MecanumPlanetGearNew2Left.stl
42.0 x 42.0 x 22.0
