Khodii/OmniMoveCar/newgeartests/cutopen4P8S22AppliedScaled.stl

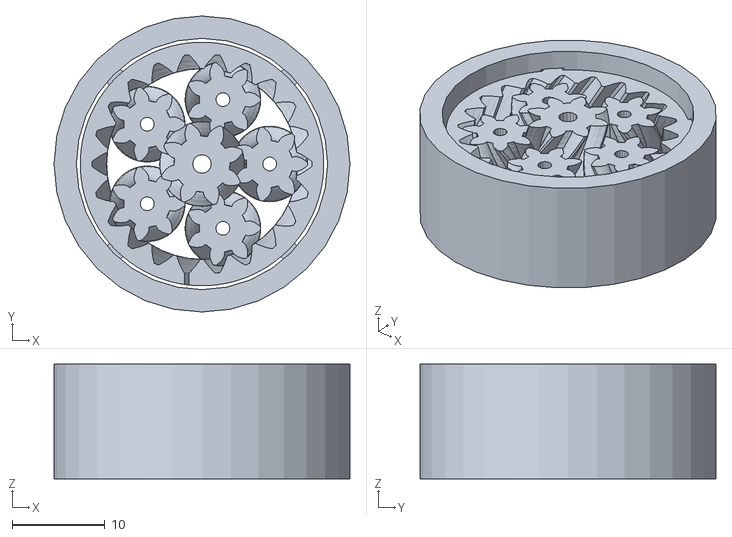
[picture p116: CAD file, 2019-07-02]
newgeartests/cutopen4P8S22AppliedScaled.stl
31.9 x 31.9 x 12.4
