Khodii/OmniMoveCar/newgeartests/owncomp/owncompoundgeats.stl

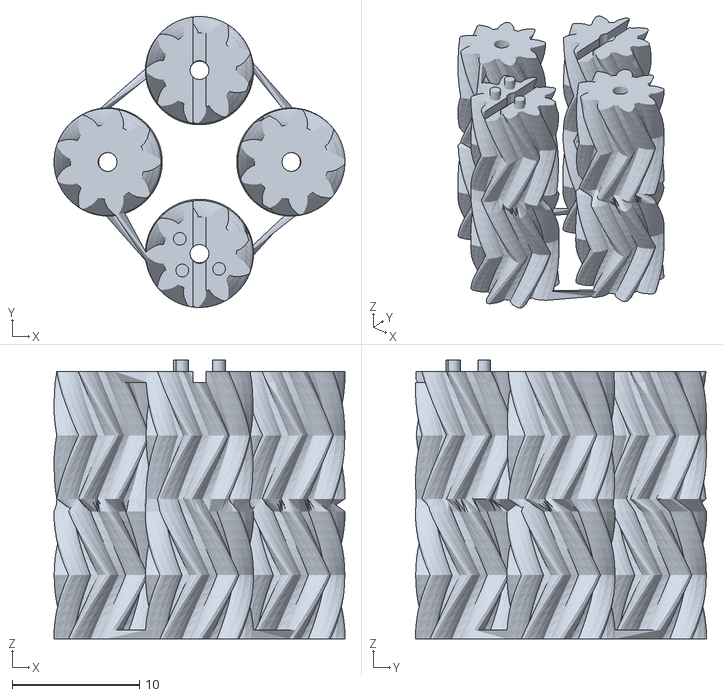
[picture p117: CAD file, 2019-07-02]
newgeartests/owncomp/owncompoundgeats.stl
22.9 x 22.9 x 21.9
