Khodii/OmniMoveCar/Teggla/tesla_keychain.stl

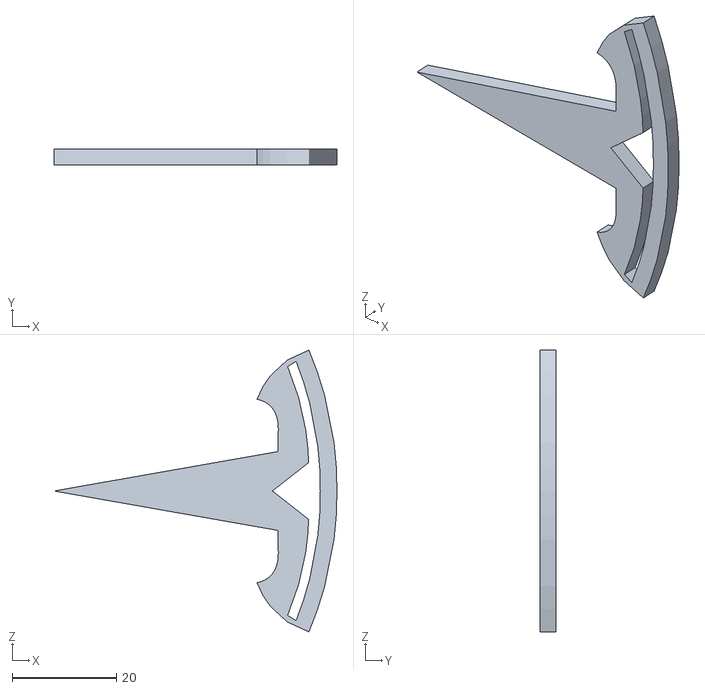
[picture p118: CAD file, 2019-07-22]
Teggla/tesla_keychain.stl
54.3 x 3.00 x 54.1
