Khodii/OmniMoveCar/44mm_Mecanum_Wheel_Small_Solid_and_Low_Cost/files/Roller.STL

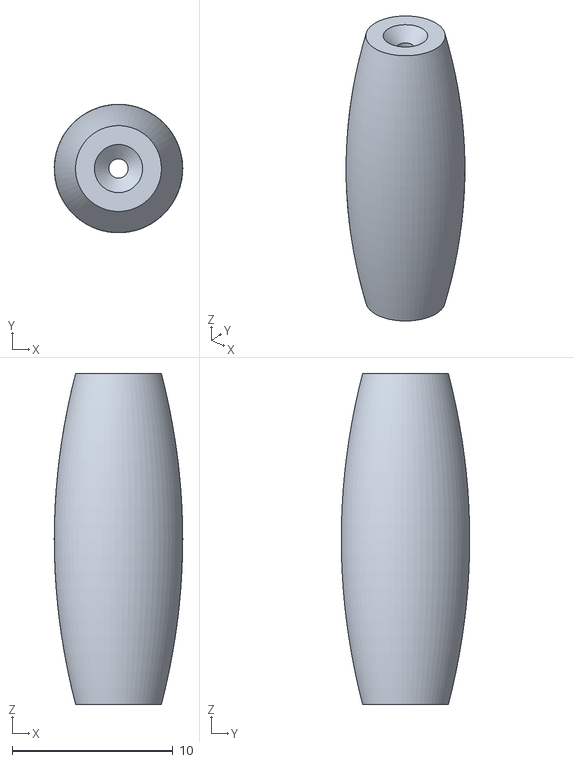
[picture p119: CAD file, 2019-05-18]
44mm_Mecanum_Wheel_Small_Solid_and_Low_Cost/files/Roller.STL
8.00 x 7.99 x 20.6
