Khodii/OmniMoveCar/Abgabe M3/STL-Modelle/PLA/eierhaltertrger0.stl

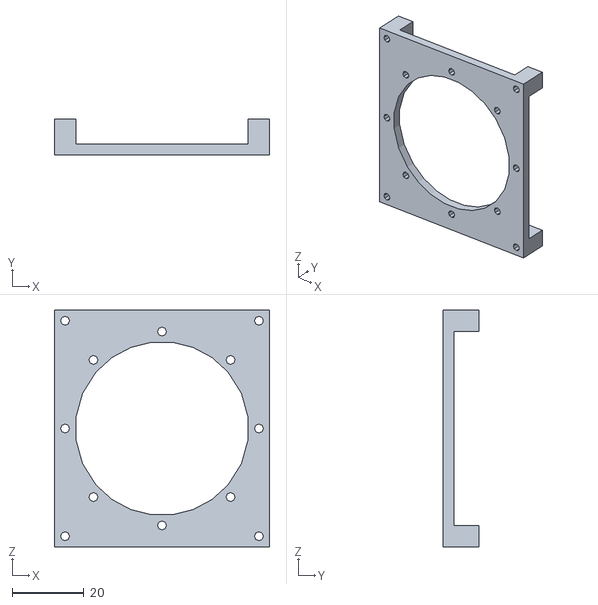
[picture p120: CAD file, 2019-06-12]
Abgabe M3/STL-Modelle/PLA/eierhaltertrger0.stl
60.0 x 10.0 x 66.0
