Khodii/OmniMoveCar/Abgabe M3/STL-Modelle/TPU/motorhalterung.stl

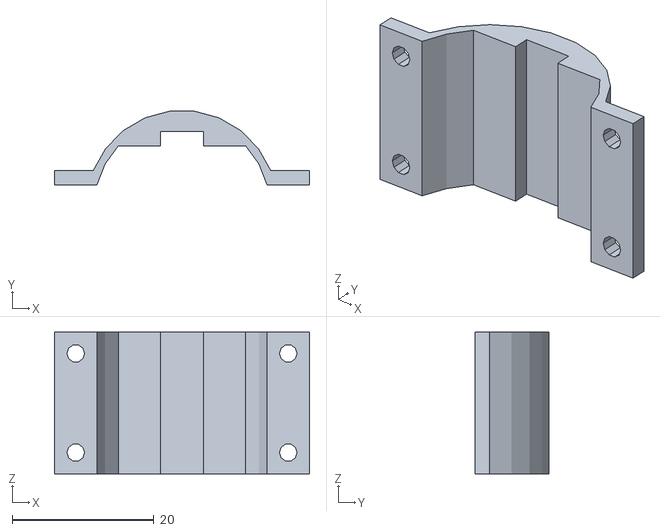
[picture p121: CAD file, 2019-06-12]
Abgabe M3/STL-Modelle/TPU/motorhalterung.stl
36.0 x 10.4 x 20.0
