Khodii/OmniMoveCar/CAD/exports/PLA/eierhalterträger.stl

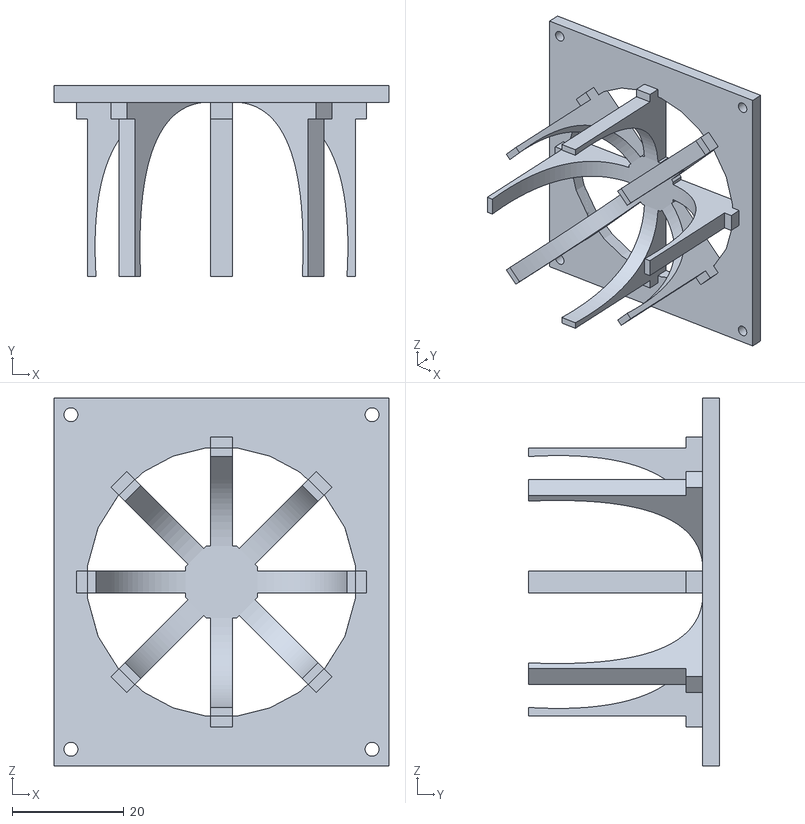
[picture p122: CAD file, 2019-07-22]
CAD/exports/PLA/eierhalterträger.stl
60.0 x 34.2 x 66.0
