Khodii/OmniMoveCar/CAD/sonstiges/pin.stl

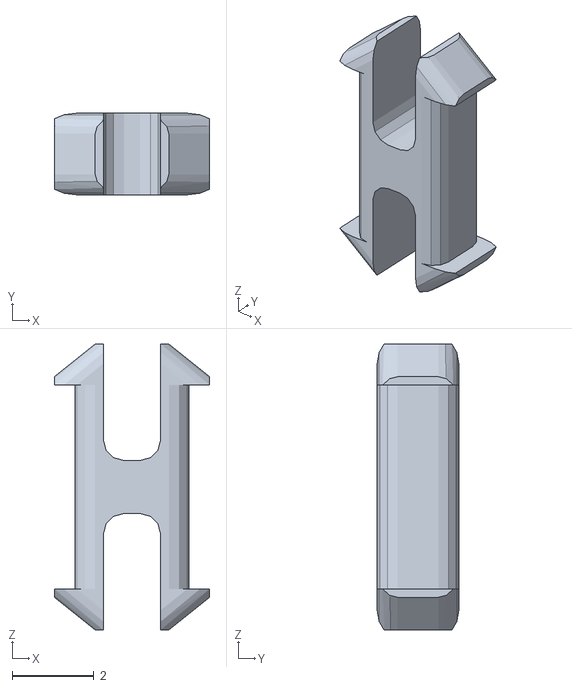
[picture p123: CAD file, 2019-07-02]
CAD/sonstiges/pin.stl
3.80 x 2.00 x 7.00
