Khodii/OmniMoveCar/currgetriebe/TestWheel.stl

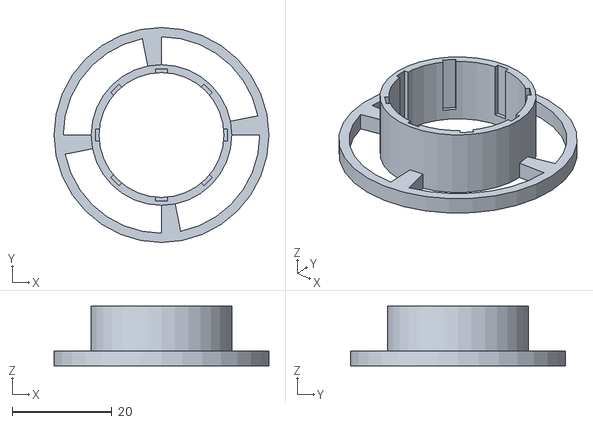
[picture p124: CAD file, 2019-07-22]
currgetriebe/TestWheel.stl
43.1 x 43.1 x 12.0
