Khodii/OmniMoveCar/Models/MecanumPlanetGearNew2.stl

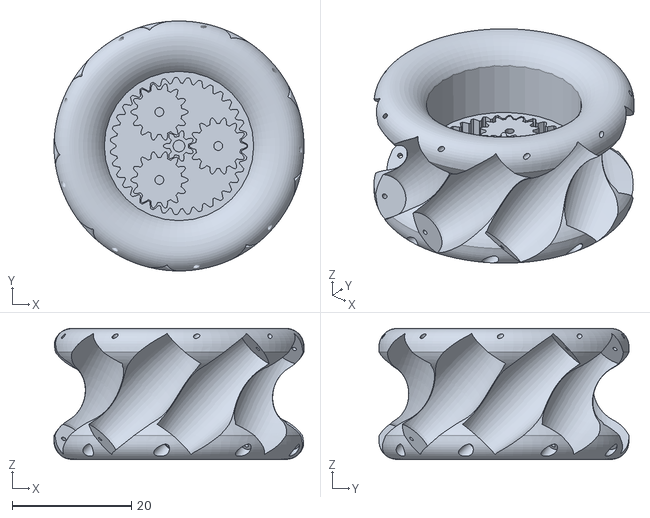
[picture p125: CAD file, 2019-06-10]
Models/MecanumPlanetGearNew2.stl
42.0 x 42.0 x 22.0
