Khodii/OmniMoveCar/newgeartests/3_23_8_0,01.stl

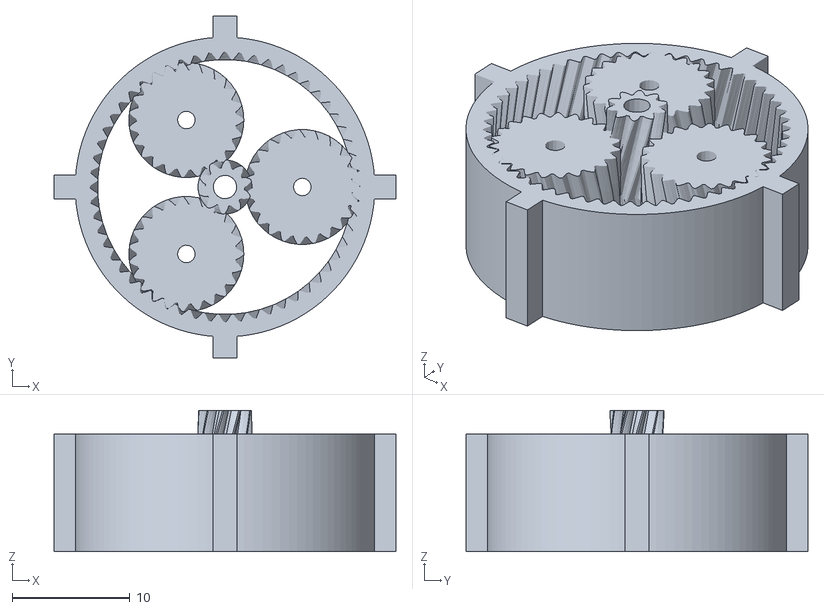
[picture p126: CAD file, 2019-07-02]
newgeartests/3_23_8_0,01.stl
29.1 x 29.1 x 12.0
