Khodii/OmniMoveCar/newgeartests/owncomp/owncompound.stl

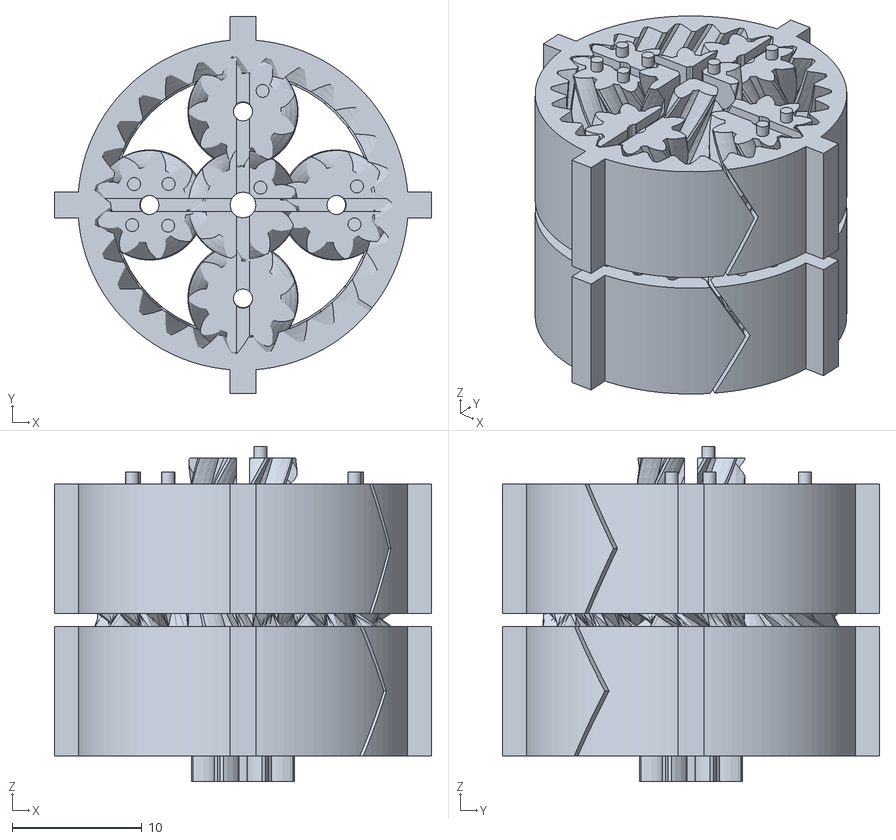
[picture p127: CAD file, 2019-07-02]
newgeartests/owncomp/owncompound.stl
29.1 x 29.1 x 25.9
