Khodii/OmniMoveCar/Technische Zeichnung/Car.FCStd

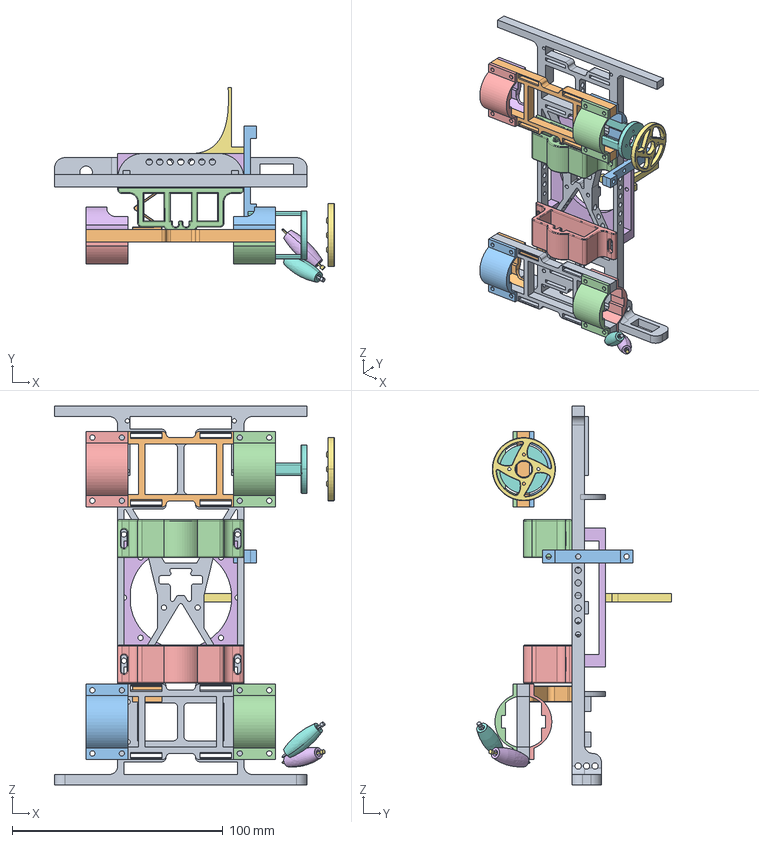
[picture p128: CAD file, 2019-06-12]
Technische Zeichnung/Car.FCStd
133.0 x 92.4 x 180.0 mm
FELGE
INNENFELGEL
SIGMA
AKKUHALTERUNG
AKKUHALTERUNG001
