Khodii/OmniMoveCar/Teggla/frontbumperreplacement.stl

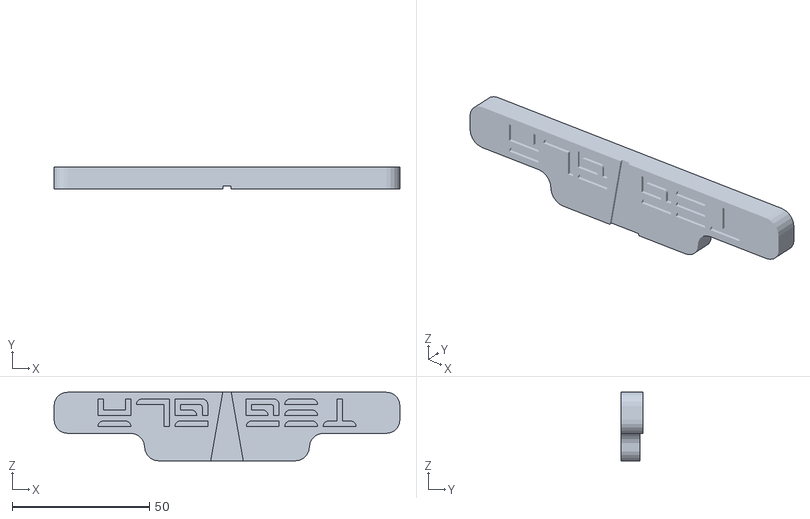
[picture p129: CAD file, 2019-07-22]
Teggla/frontbumperreplacement.stl
126.0 x 8.00 x 25.0
