Khodii/OmniMoveCar/24mm_customized_Gear_Bearing/4p7sonlyinner.obj

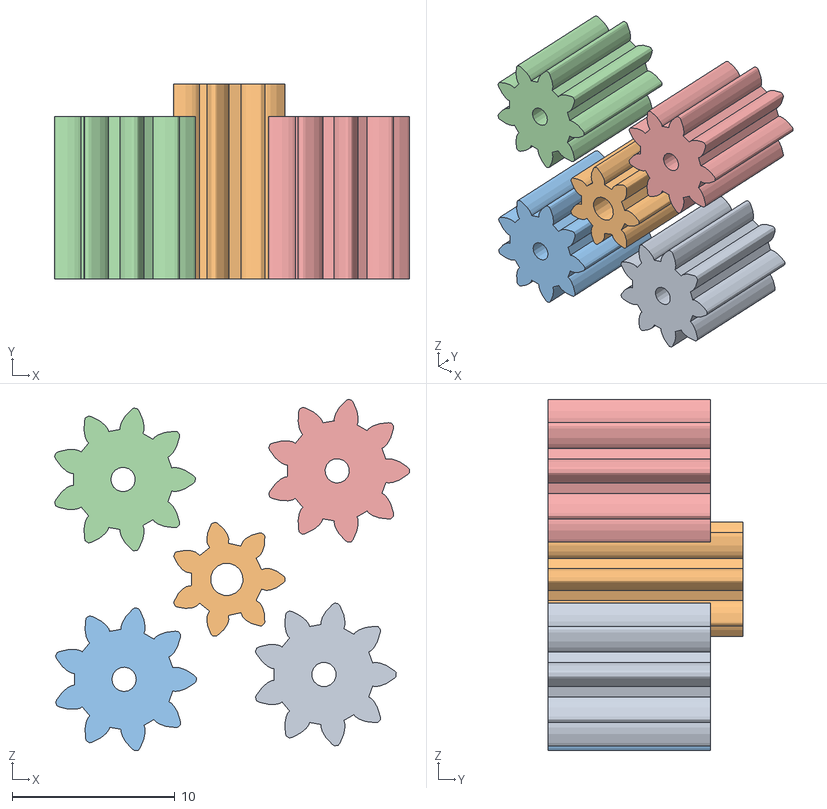
[picture p130: CAD file, 2019-06-03]
24mm_customized_Gear_Bearing/4p7sonlyinner.obj
21.8 x 12.0 x 21.6
4P7S02
4P7S02.002
4P7S02.003
4P7S02.004
4P7S02.005
