Khodii/OmniMoveCar/Abgabe M3/STL-Modelle/PLA/haupttrger0.stl

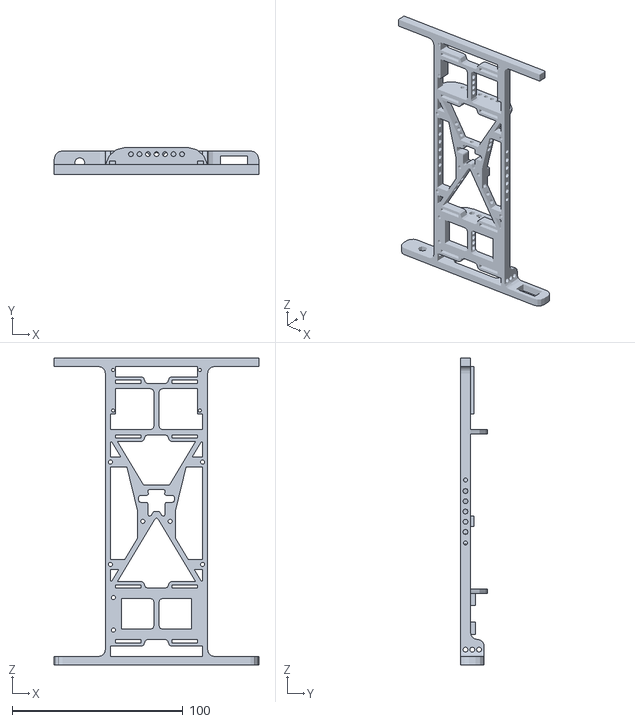
[picture p131: CAD file, 2019-06-12]
Abgabe M3/STL-Modelle/PLA/haupttrger0.stl
120.0 x 16.0 x 180.0
