Khodii/OmniMoveCar/Abgabe M3/STL-Modelle/TPU/innenfelgel.stl

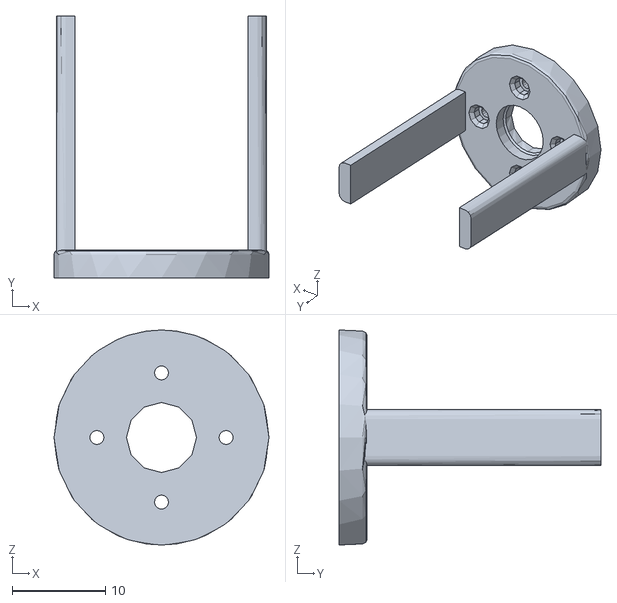
[picture p132: CAD file, 2019-06-12]
Abgabe M3/STL-Modelle/TPU/innenfelgel.stl
23.0 x 28.0 x 23.0
