Khodii/OmniMoveCar/CAD/exports/PLA/haupttrger0.stl

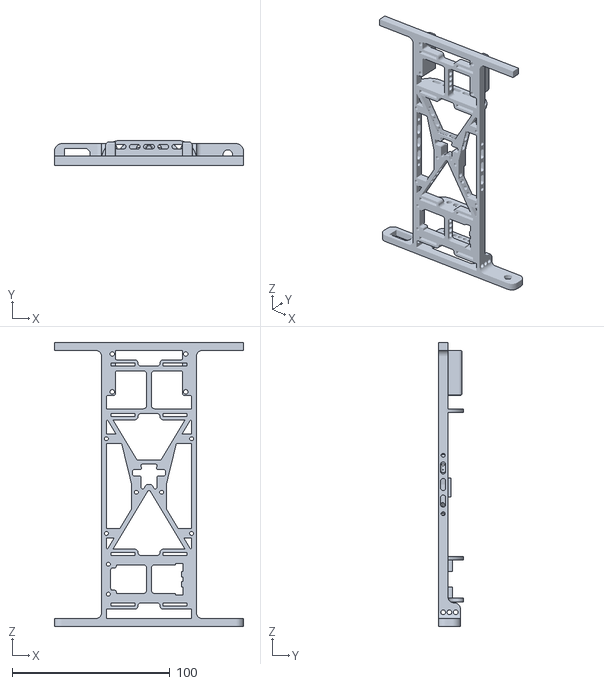
[picture p133: CAD file, 2019-07-22]
CAD/exports/PLA/haupttrger0.stl
120.0 x 16.0 x 180.0
