Khodii/OmniMoveCar/CAD/exports/TPU/motortrgerx0.stl

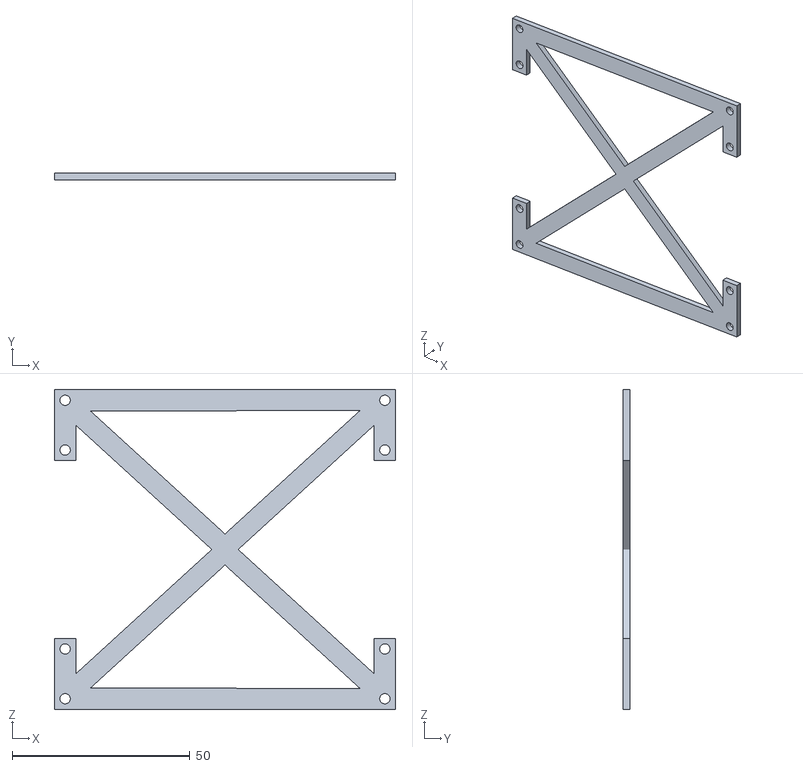
[picture p134: CAD file, 2019-07-22]
CAD/exports/TPU/motortrgerx0.stl
96.0 x 2.00 x 90.1
