Khodii/OmniMoveCar/currgetriebe/innenfelgel.stl

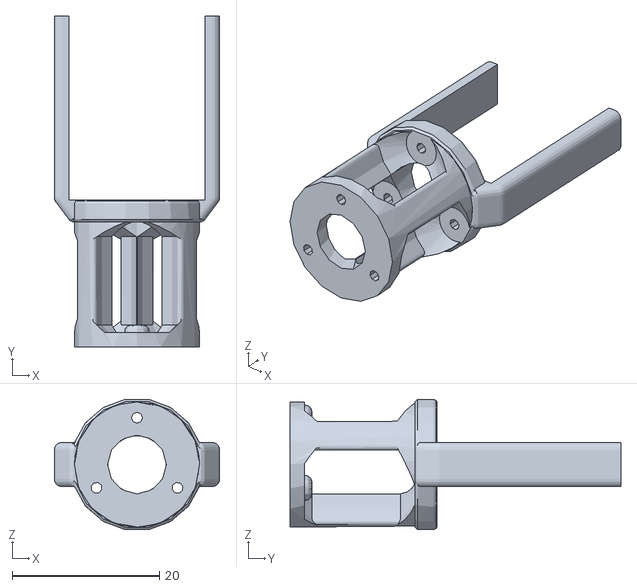
[picture p135: CAD file, 2019-07-22]
currgetriebe/innenfelgel.stl
22.5 x 45.0 x 17.7
