Khodii/OmniMoveCar/Models/MecanumPlanetGearNew2Right.stl

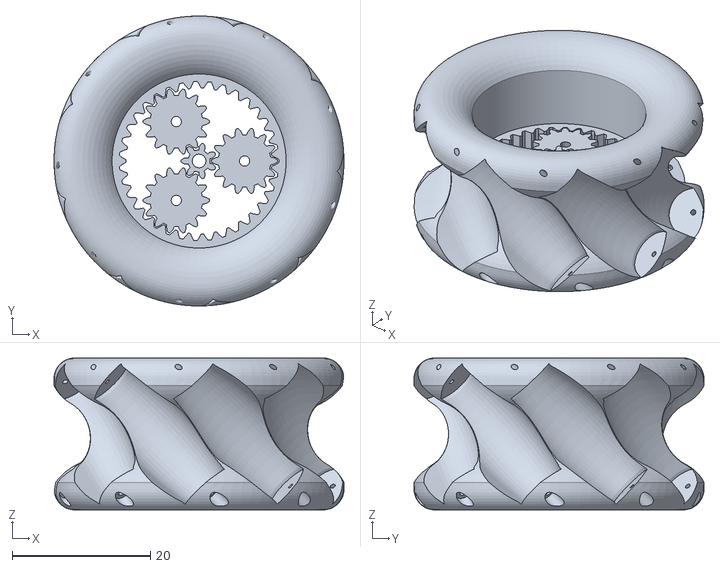
[picture p136: CAD file, 2019-06-10]
Models/MecanumPlanetGearNew2Right.stl
42.0 x 42.0 x 22.0
