Khodii/OmniMoveCar/newgeartests/owncomp/outsideRing.stl

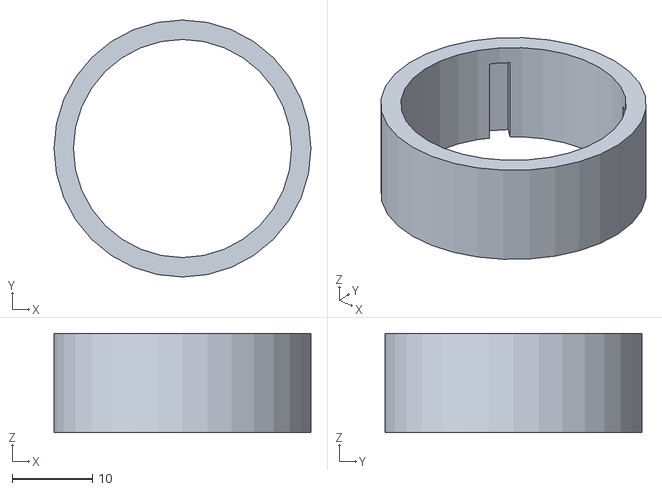
[picture p137: CAD file, 2019-07-02]
newgeartests/owncomp/outsideRing.stl
31.9 x 31.9 x 12.4
