Khodii/OmniMoveCar/24mm_customized_Gear_Bearing/4P7S26-005.stl

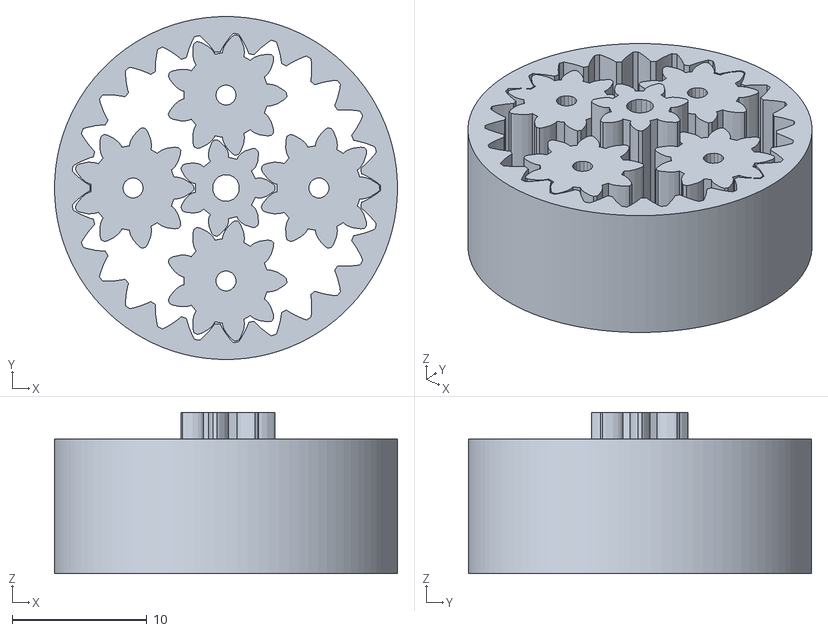
[picture p138: CAD file, 2019-05-25]
24mm_customized_Gear_Bearing/4P7S26-005.stl
25.5 x 25.5 x 12.0
