Khodii/OmniMoveCar/44mm_Mecanum_Wheel_Small_Solid_and_Low_Cost/files/Motor_Mount.STL

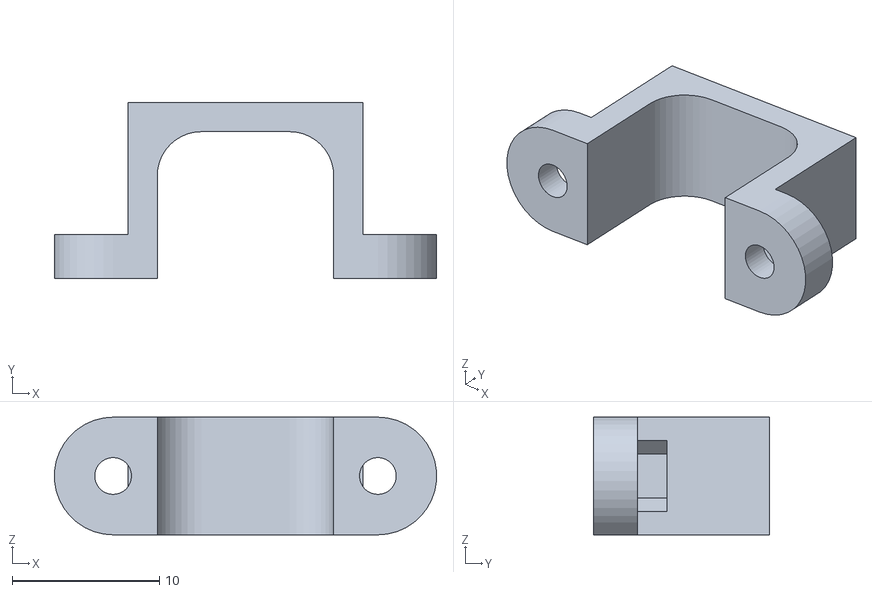
[picture p139: CAD file, 2019-05-18]
44mm_Mecanum_Wheel_Small_Solid_and_Low_Cost/files/Motor_Mount.STL
26.0 x 12.0 x 8.00
