Khodii/OmniMoveCar/Abgabe M3/STL-Modelle/PLA/lhalterung.stl

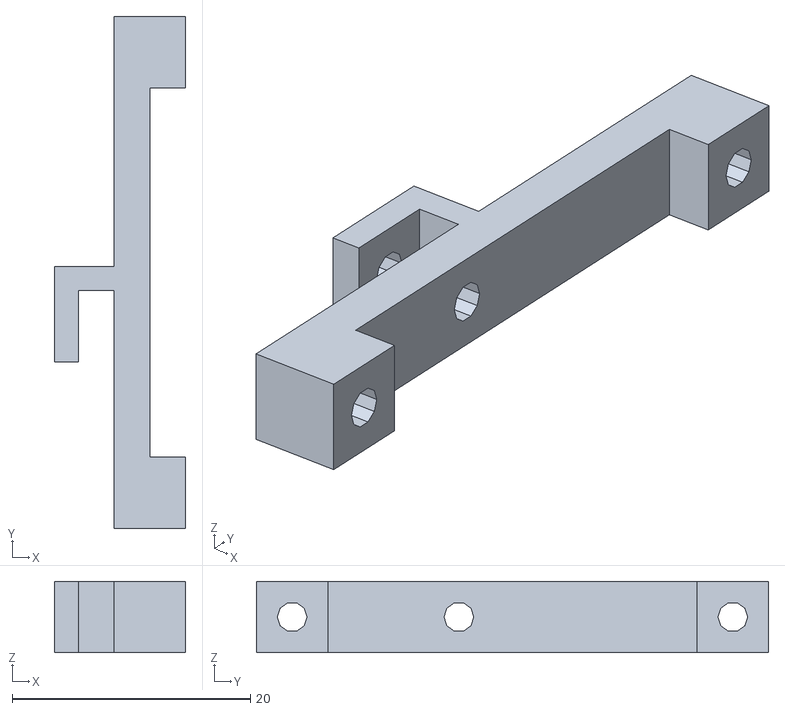
[picture p140: CAD file, 2019-06-12]
Abgabe M3/STL-Modelle/PLA/lhalterung.stl
11.0 x 43.0 x 6.00
