Khodii/OmniMoveCar/Abgabe M3/STL-Modelle/TPU/sigma.stl

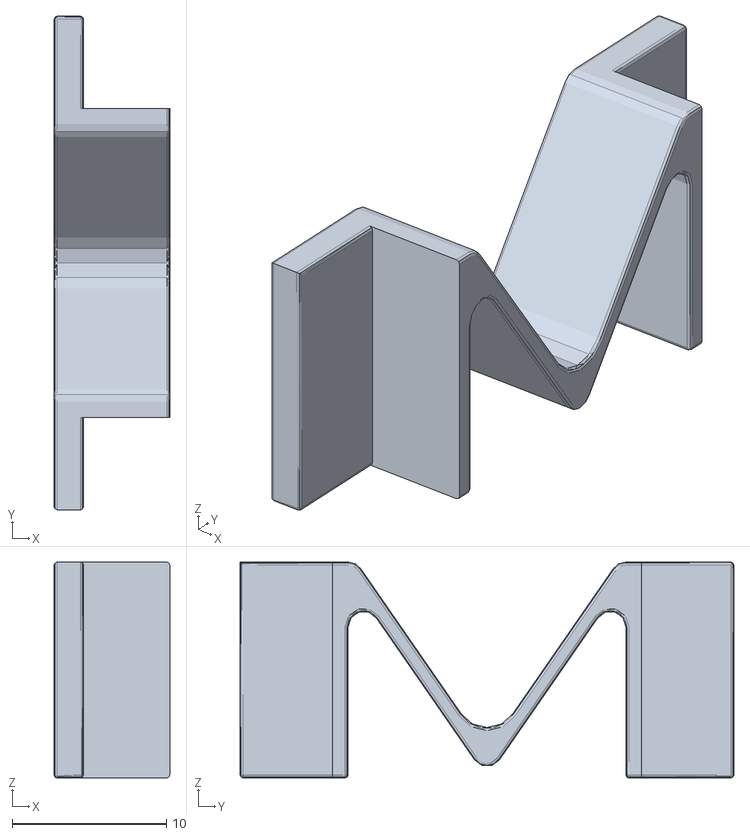
[picture p141: CAD file, 2019-06-12]
Abgabe M3/STL-Modelle/TPU/sigma.stl
7.50 x 32.0 x 14.0
