Khodii/OmniMoveCar/CAD/exports/PLA/lhalterung.stl

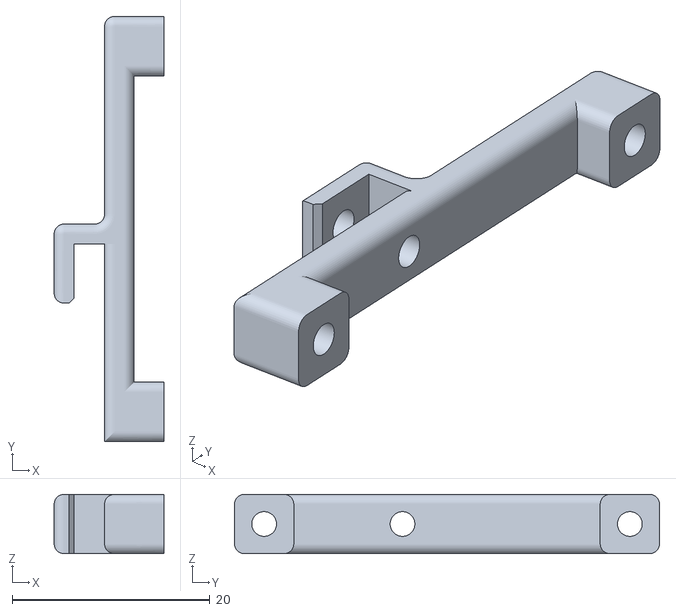
[picture p142: CAD file, 2019-07-22]
CAD/exports/PLA/lhalterung.stl
11.1 x 43.0 x 6.00
