Khodii/OmniMoveCar/currgetriebe/innenfelgeRing.stl

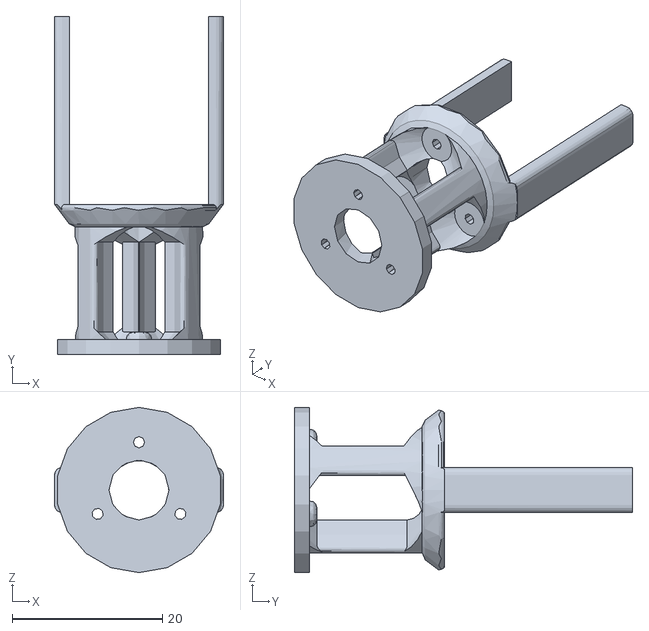
[picture p143: CAD file, 2019-07-22]
currgetriebe/innenfelgeRing.stl
22.5 x 45.0 x 22.0
