Khodii/OmniMoveCar/GetriebeVersionen/0,45.stl

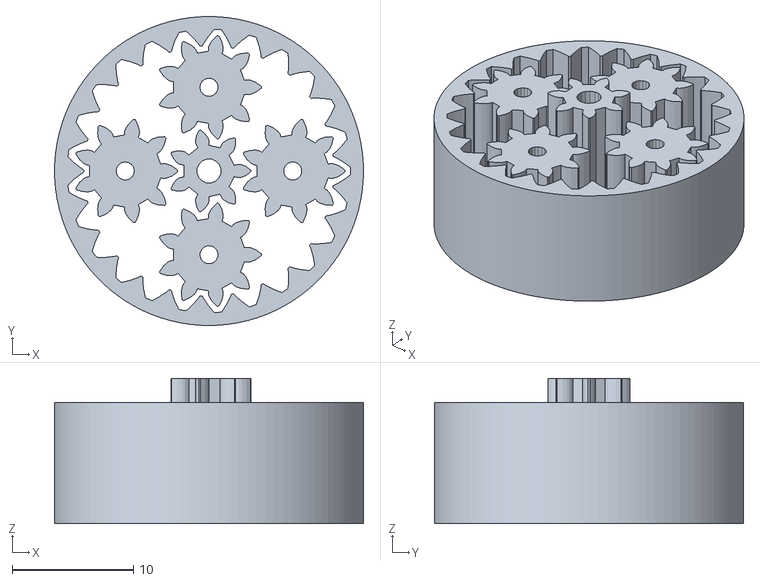
[picture p144: CAD file, 2019-06-10]
GetriebeVersionen/0,45.stl
25.5 x 25.5 x 12.0
