Khodii/OmniMoveCar/Models/MecanumPlanetGearNewLeftExloded.stl

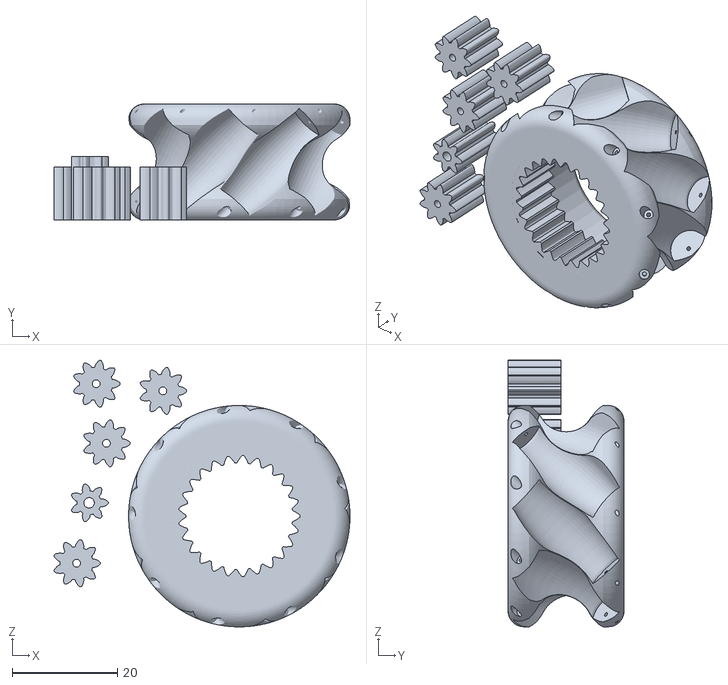
[picture p145: CAD file, 2019-05-26]
Models/MecanumPlanetGearNewLeftExloded.stl
56.1 x 22.0 x 50.6
