Khodii/OmniMoveCar/newgeartests/4_8_8_0,05_noexsun.stl

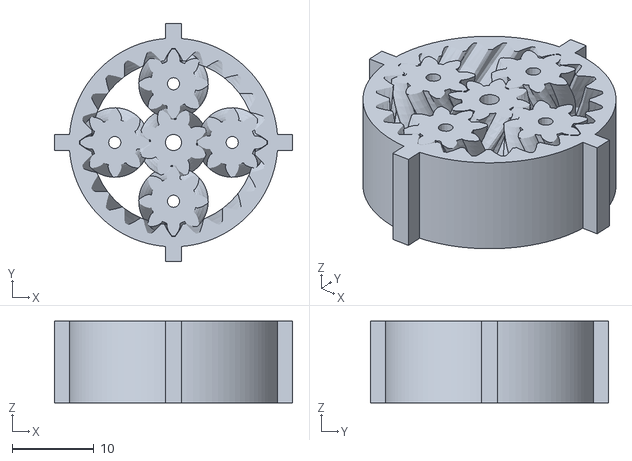
[picture p146: CAD file, 2019-07-02]
newgeartests/4_8_8_0,05_noexsun.stl
29.1 x 29.1 x 10.0
