Khodii/OmniMoveCar/24mm_customized_Gear_Bearing/4P7S26-straight-split.obj

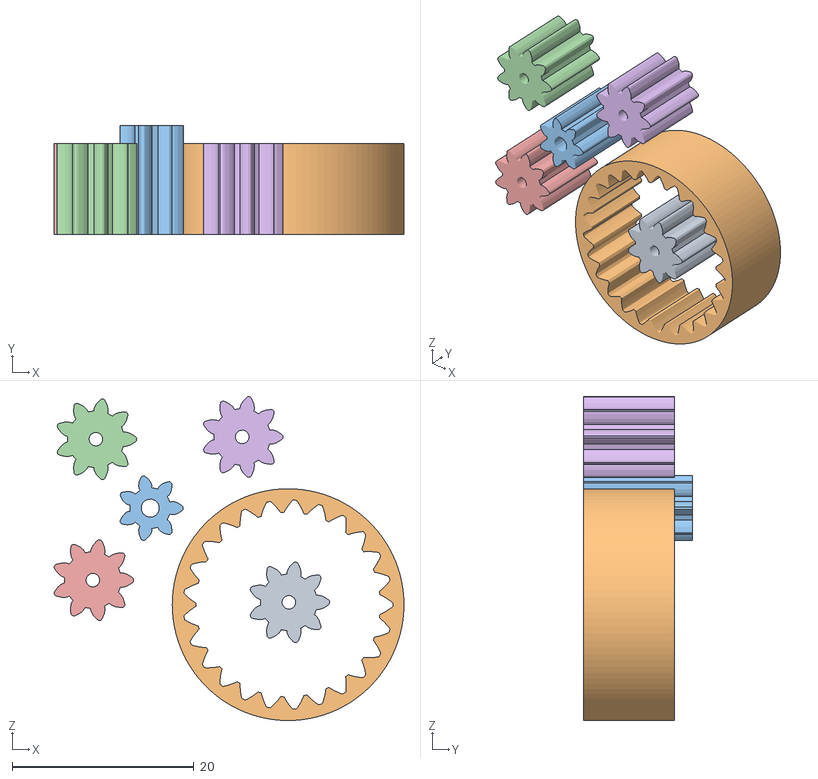
[picture p147: CAD file, 2019-05-23]
24mm_customized_Gear_Bearing/4P7S26-straight-split.obj
38.5 x 12.0 x 35.7
4P7S26-straight
4P7S26-straight.001
4P7S26-straight.002
4P7S26-straight.003
4P7S26-straight.004
4P7S26-straight.005
