Khodii/OmniMoveCar/44mm_Mecanum_Wheel_Small_Solid_and_Low_Cost/files/Top.STL

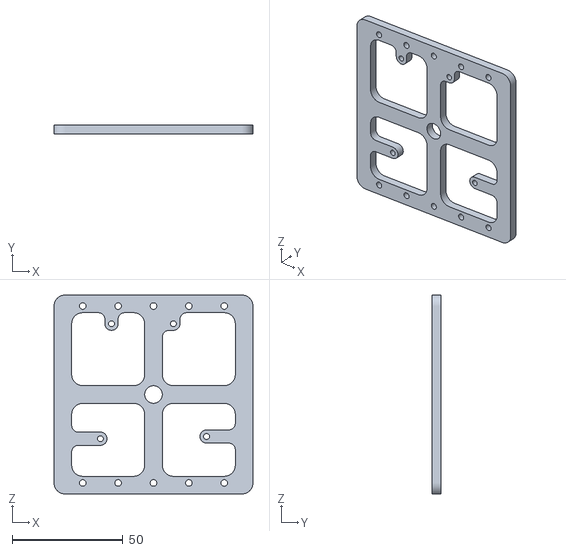
[picture p148: CAD file, 2019-05-18]
44mm_Mecanum_Wheel_Small_Solid_and_Low_Cost/files/Top.STL
90.0 x 4.00 x 90.0
