Khodii/OmniMoveCar/Abgabe M3/STL-Modelle/PLA/eierhaltersegment.stl

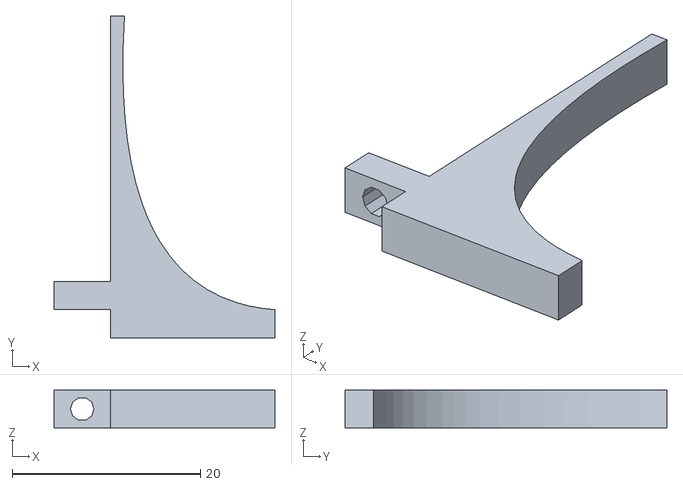
[picture p149: CAD file, 2019-06-12]
Abgabe M3/STL-Modelle/PLA/eierhaltersegment.stl
23.5 x 34.2 x 4.00
