Khodii/OmniMoveCar/Models/MecanumPlanetGearNewRightExloded.stl

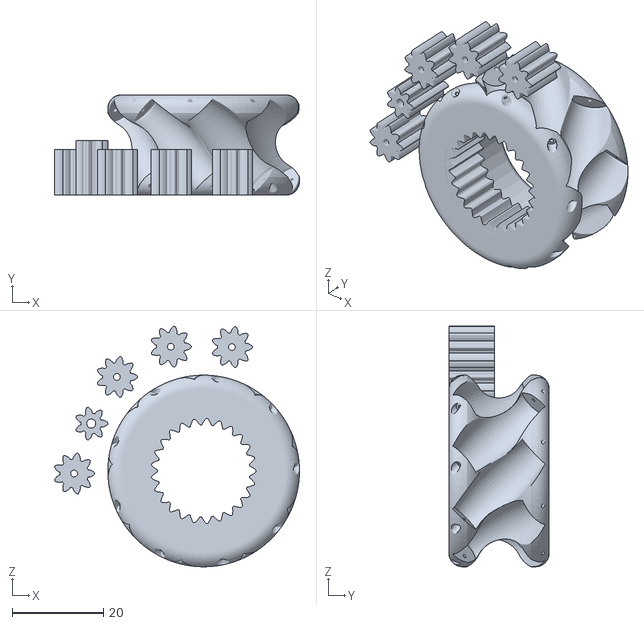
[picture p150: CAD file, 2019-05-26]
Models/MecanumPlanetGearNewRightExloded.stl
53.7 x 22.0 x 52.7
