Khodii/OmniMoveCar/24mm_customized_Gear_Bearing/4P6S26-straight-split.obj

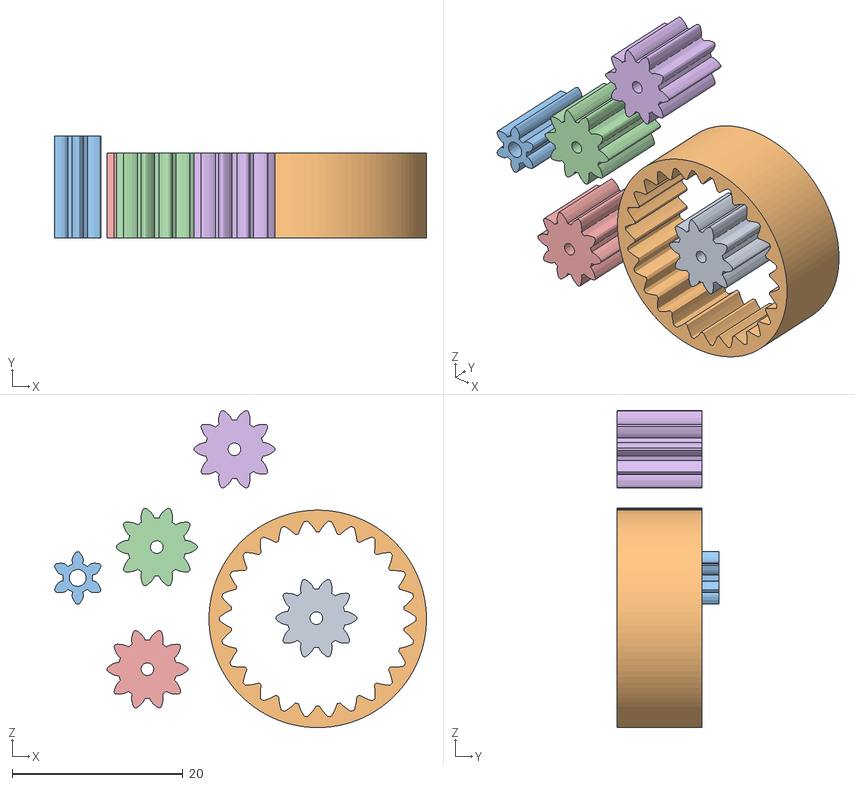
[picture p151: CAD file, 2019-05-23]
24mm_customized_Gear_Bearing/4P6S26-straight-split.obj
43.6 x 12.0 x 37.2
4P6S26-straight
4P6S26-straight.001
4P6S26-straight.002
4P6S26-straight.003
4P6S26-straight.004
4P6S26-straight.005
