Khodii/OmniMoveCar/24mm_customized_Gear_Bearing/5P8S22-straight-split.obj

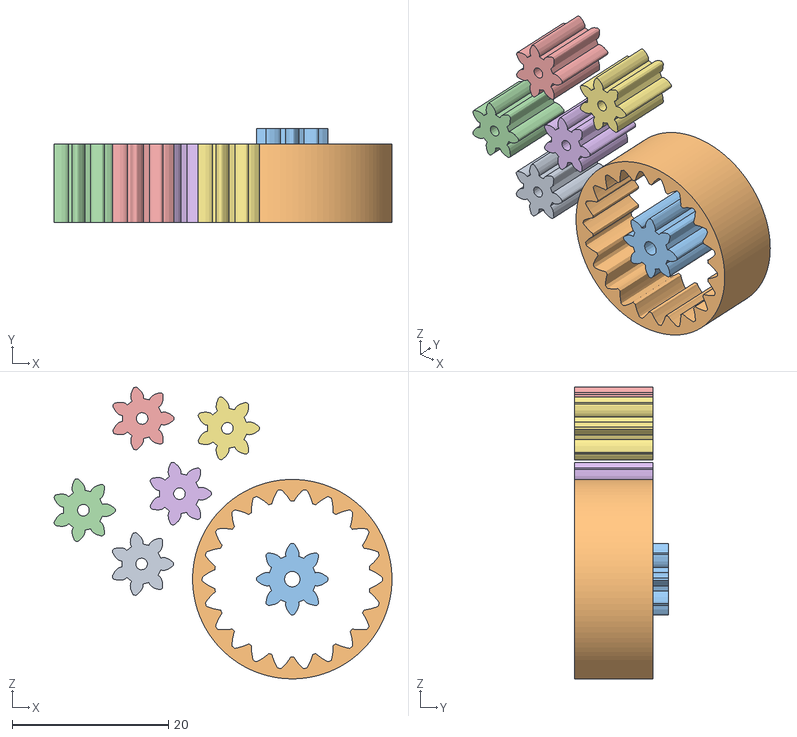
[picture p152: CAD file, 2019-05-23]
24mm_customized_Gear_Bearing/5P8S22-straight-split.obj
43.2 x 12.0 x 37.3
5P8S22-straight
5P8S22-straight.001
5P8S22-straight.002
5P8S22-straight.003
5P8S22-straight.004
5P8S22-straight.005
5P8S22-straight.006
