Khodii/OmniMoveCar/currgetriebe/testring.stl

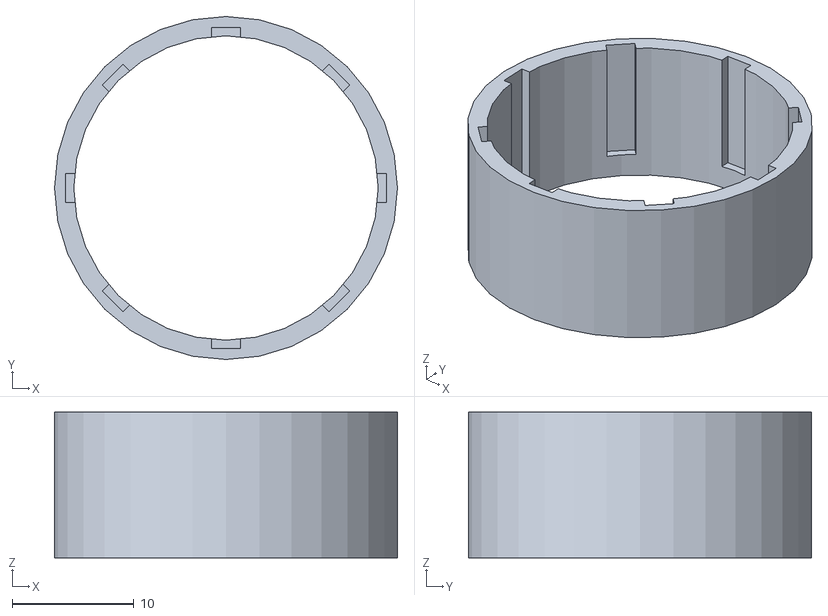
[picture p153: CAD file, 2019-07-22]
currgetriebe/testring.stl
28.2 x 28.2 x 12.0
