Khodii/OmniMoveCar/currgetriebe/felge.stl

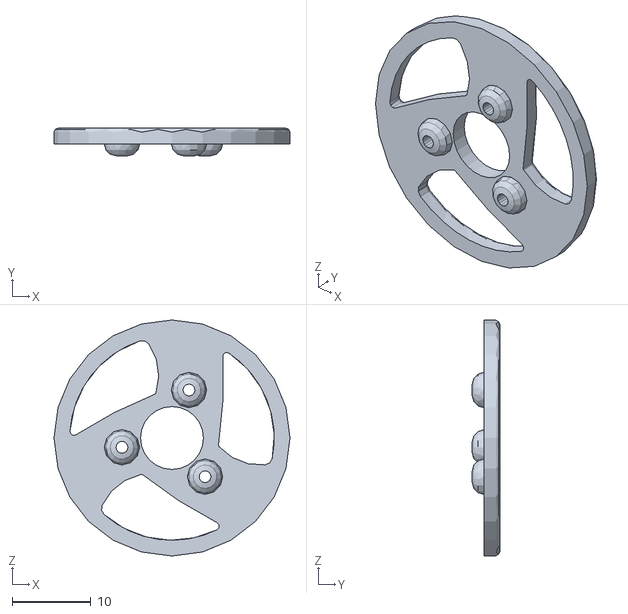
[picture p154: CAD file, 2019-07-22]
currgetriebe/felge.stl
30.0 x 3.50 x 30.0
