Khodii/OmniMoveCar/24mm_customized_Gear_Bearing/5P8S22-straight.stl

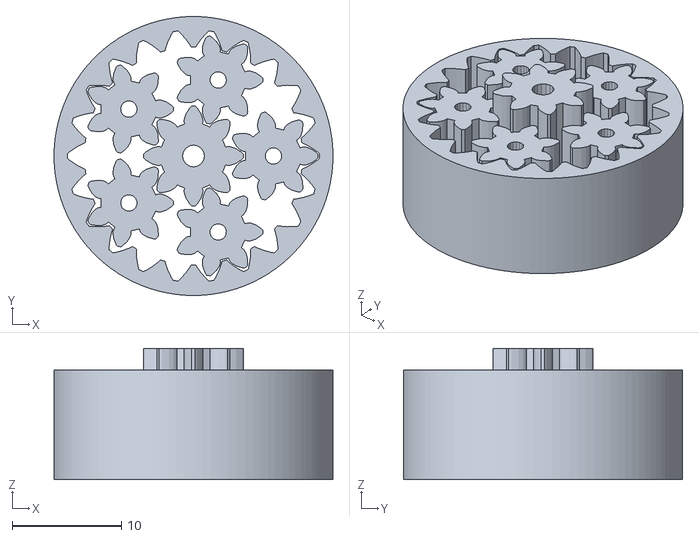
[picture p155: CAD file, 2019-05-23]
24mm_customized_Gear_Bearing/5P8S22-straight.stl
25.5 x 25.5 x 12.0
