Khodii/OmniMoveCar/24mm_customized_Gear_Bearing/4P6S26-holes_extruded.stl

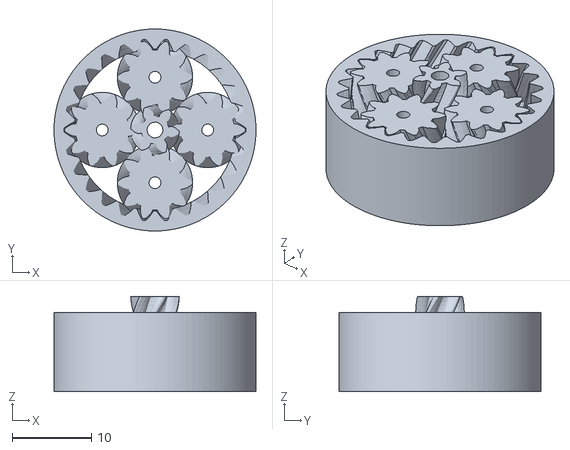
[picture p156: CAD file, 2019-05-22]
24mm_customized_Gear_Bearing/4P6S26-holes_extruded.stl
25.5 x 25.5 x 12.0
