Khodii/OmniMoveCar/24mm_customized_Gear_Bearing/4P7S26-holes.stl

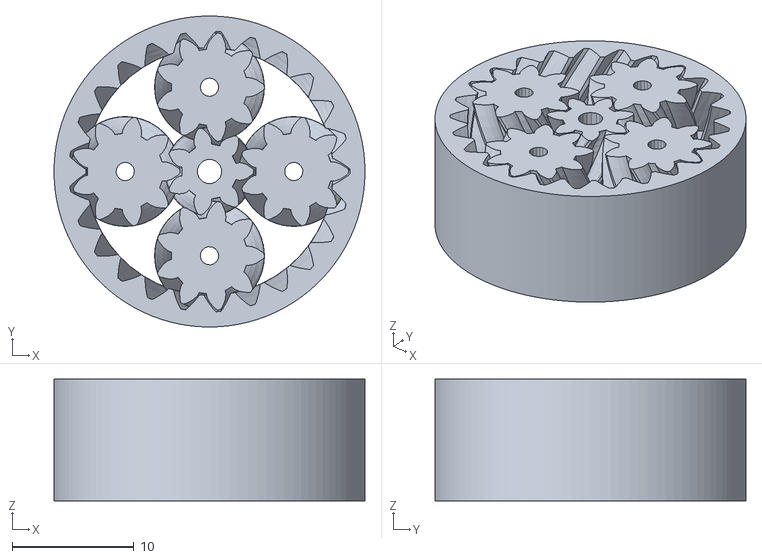
[picture p157: CAD file, 2019-05-22]
24mm_customized_Gear_Bearing/4P7S26-holes.stl
25.5 x 25.5 x 10.0
