Khodii/OmniMoveCar/24mm_customized_Gear_Bearing/4P7S26-015.stl

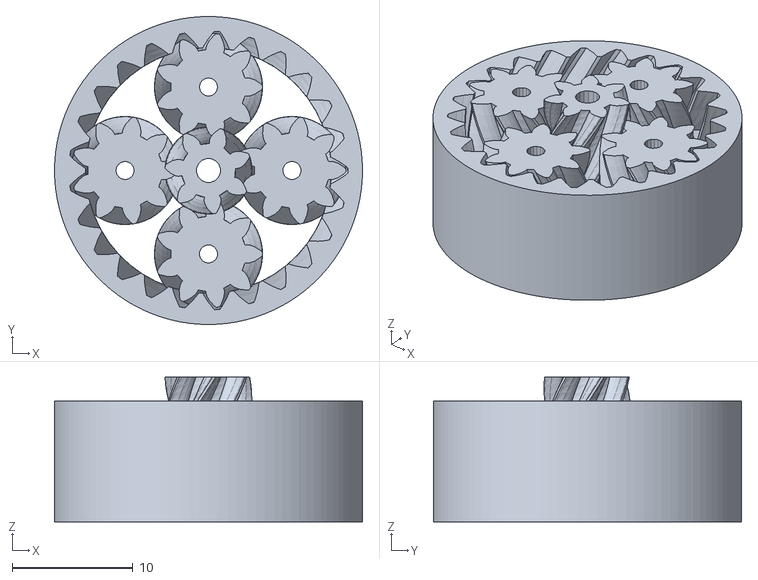
[picture p158: CAD file, 2019-05-22]
24mm_customized_Gear_Bearing/4P7S26-015.stl
25.5 x 25.5 x 12.0
