Khodii/OmniMoveCar/24mm_customized_Gear_Bearing/25_5-10bearing.stl

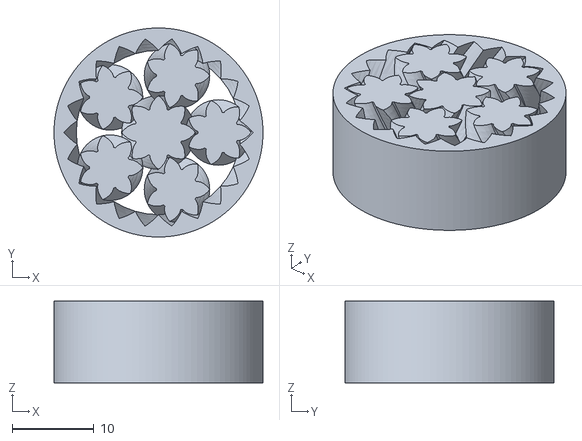
[picture p159: CAD file, 2019-05-21]
24mm_customized_Gear_Bearing/25_5-10bearing.stl
25.5 x 25.5 x 10.0
