Khodii/OmniMoveCar/(list of files, cad)

Other CAD files:
GetriebeVersionen/3xP/3xP12S7t0,25.stl
Technische Zeichnung/Marcel_TechDraw2.FCStd
Teggla/tegglafont.stl
GetriebeVersionen/0,30.stl
GetriebeVersionen/3xP/3xP14S7t0,15.stl
Technische Zeichnung/Marcel_TechDraw.FCStd
24mm_customized_Gear_Bearing/4p7s02.stl
CAD/exports/TPU/motorhalterung.stl
GetriebeVersionen/0,35.stl
GetriebeVersionen/3xP/3xP14S7t0,25.stl
Models/2stepgetriebe/Ring.obj
44mm_Mecanum_Wheel_Small_Solid_and_Low_Cost/files/Body_Left.STL
GetriebeVersionen/0,20.stl
GetriebeVersionen/3xP/3xP12S7t0,10.stl
Models/2stepgetriebe/RingSmall.obj
newgeartests/3_20_8_0,05_sliced.stl
currgetriebe/6_11_4to1getr.stl
GetriebeVersionen/0,10.stl
newgeartests/4_8_8_sliced.stl
Abgabe M3/STL-Modelle/PLA/MecanumPlanetGearNew3Right.stl
currgetriebe/OmniL.stl
GetriebeVersionen/0,25.stl
Models/MecanumPlanetGearNewLeft.obj
newgeartests/3_20_8_0,05.stl
Abgabe M3/STL-Modelle/PLA/MecanumPlanetGearNew3Left.stl
GetriebeVersionen/0,50.stl
Models/MecanumPlanetGearNewRight.obj
newgeartests/4_9_8_0,05.stl
24mm_customized_Gear_Bearing/4P6S26-straight.stl
GetriebeVersionen/0,40.stl
Models/MecanumPlanetGearRightE.obj
newgeartests/4_8_8.stl
Models/MecanumPlanetGearLeft.stl
newgeartests/4_9_7.stl
24mm_customized_Gear_Bearing/4P7S26-straight.stl
Models/MecanumPlanetGearRight.stl
newgeartests/4_8_8_0,5_sliced.stl
newgeartests/4_9_7_sliced.stl
newgeartests/3_20_8_0,01.stl
24mm_customized_Gear_Bearing/4P7S26-holes_extruded.stl
24mm_customized_Gear_Bearing/codeFor3P14S7.scad
24mm_customized_Gear_Bearing/codeForP9S7.scad
CAD/imports/H-Brücke/l298n-stepper-motor-driver-red-1.snapshot.3/L298N Stepper Motor Driver (Red).SLDPRT
CAD/imports/gyro/mpu6050-1.snapshot.1/MPU_6050.f3d
CAD/imports/gyro/mpu6050-1.snapshot.1/MPU_6050.iges
CAD/imports/gyro/mpu6050-1.snapshot.1/MPU_6050.stl
CAD/imports/lipo2/turnigy-nanotech-950mah-2s-25-50c-lipo-1.snapshot.4/Battery.stl
Models/MecanumPlanetGearLeft.obj
Models/MecanumPlanetGearNewLeftExloded.obj
Models/MecanumPlanetGearNewRightExloded.obj
Models/MecanumPlanetGearRight.obj
newgeartests/cutopen4P8S22.blend
newgeartests/cutopen4P8S22AppliedScaled.blend
