Khodii/OmniMoveCar/Bericht/techzeich/01.PDF

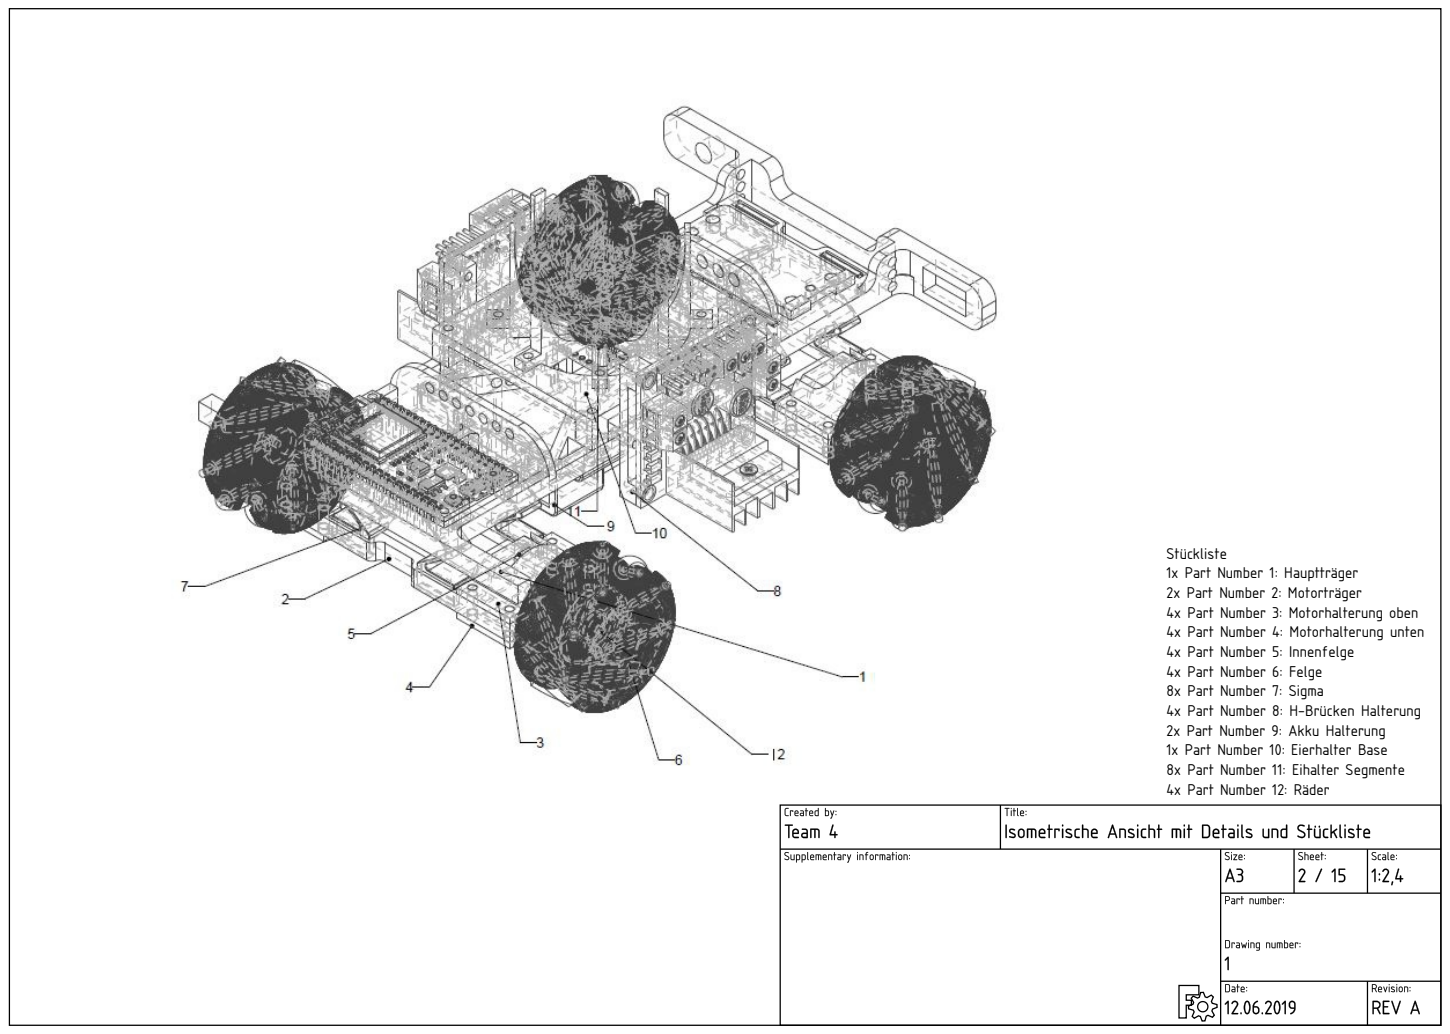
[picture p160: page 1]

Stückliste
1x Part Number 1: Hauptträger
2x Part Number 2: Motorträger
4x Part Number 3: Motorhalterung oben
4x Part Number 4: Motorhalterung unten
4x Part Number 5: Innenfelge
4x Part Number 6: Felge
8x Part Number 7: Sigma
4x Part Number 8: H-Brücken Halterung
2x Part Number 9: Akku Halterung
1x Part Number 10: Eierhalter Base
8x Part Number 11: Eihalter Segmente
4x Part Number 12: Räder
