Khodii/OmniMoveCar/Bericht/techzeich/00.PDF

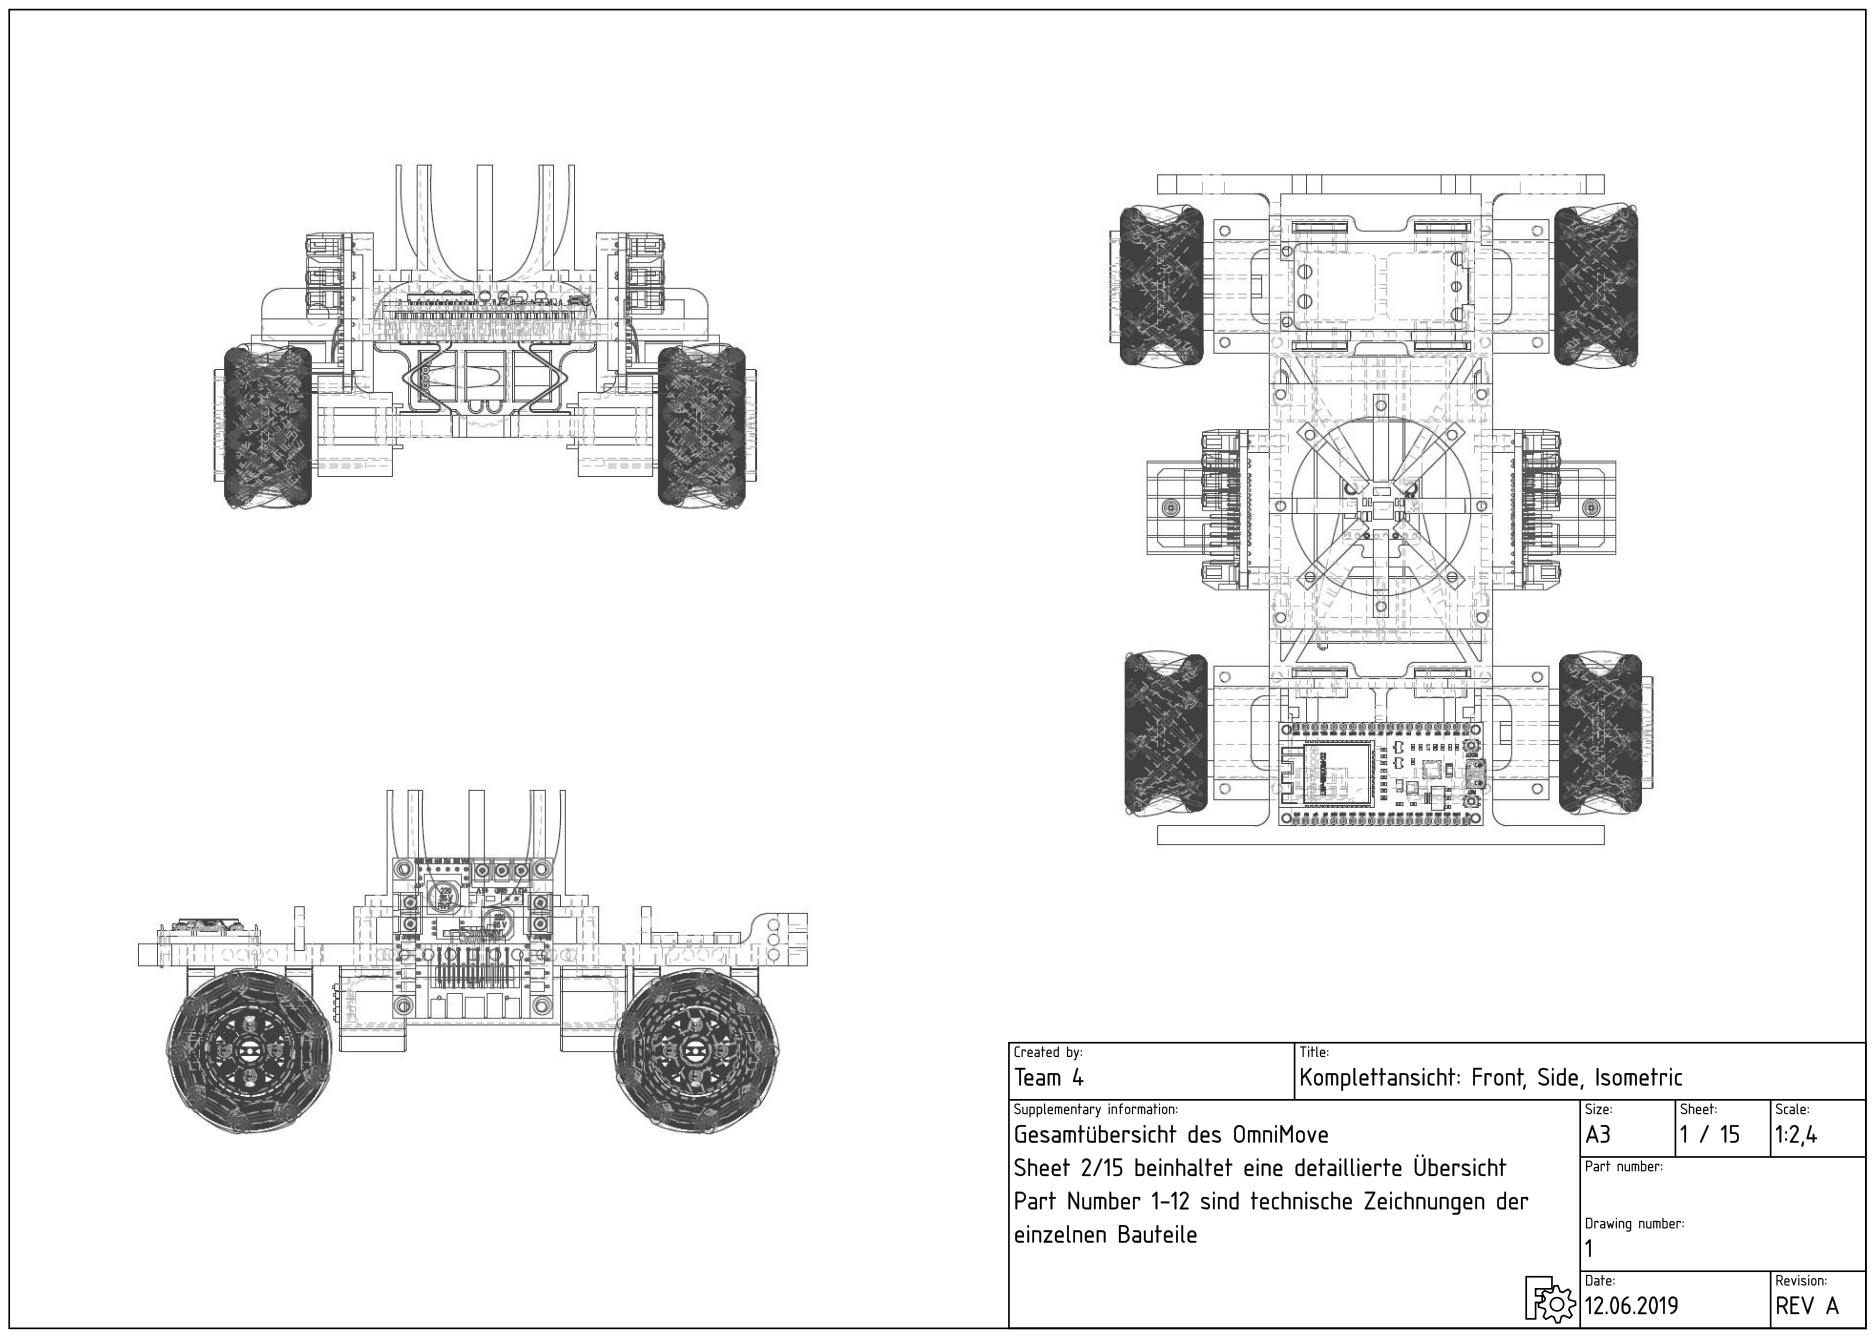
[picture p161: page 1]
