Khodii/OmniMoveCar/Bericht/techzeich/12.PDF

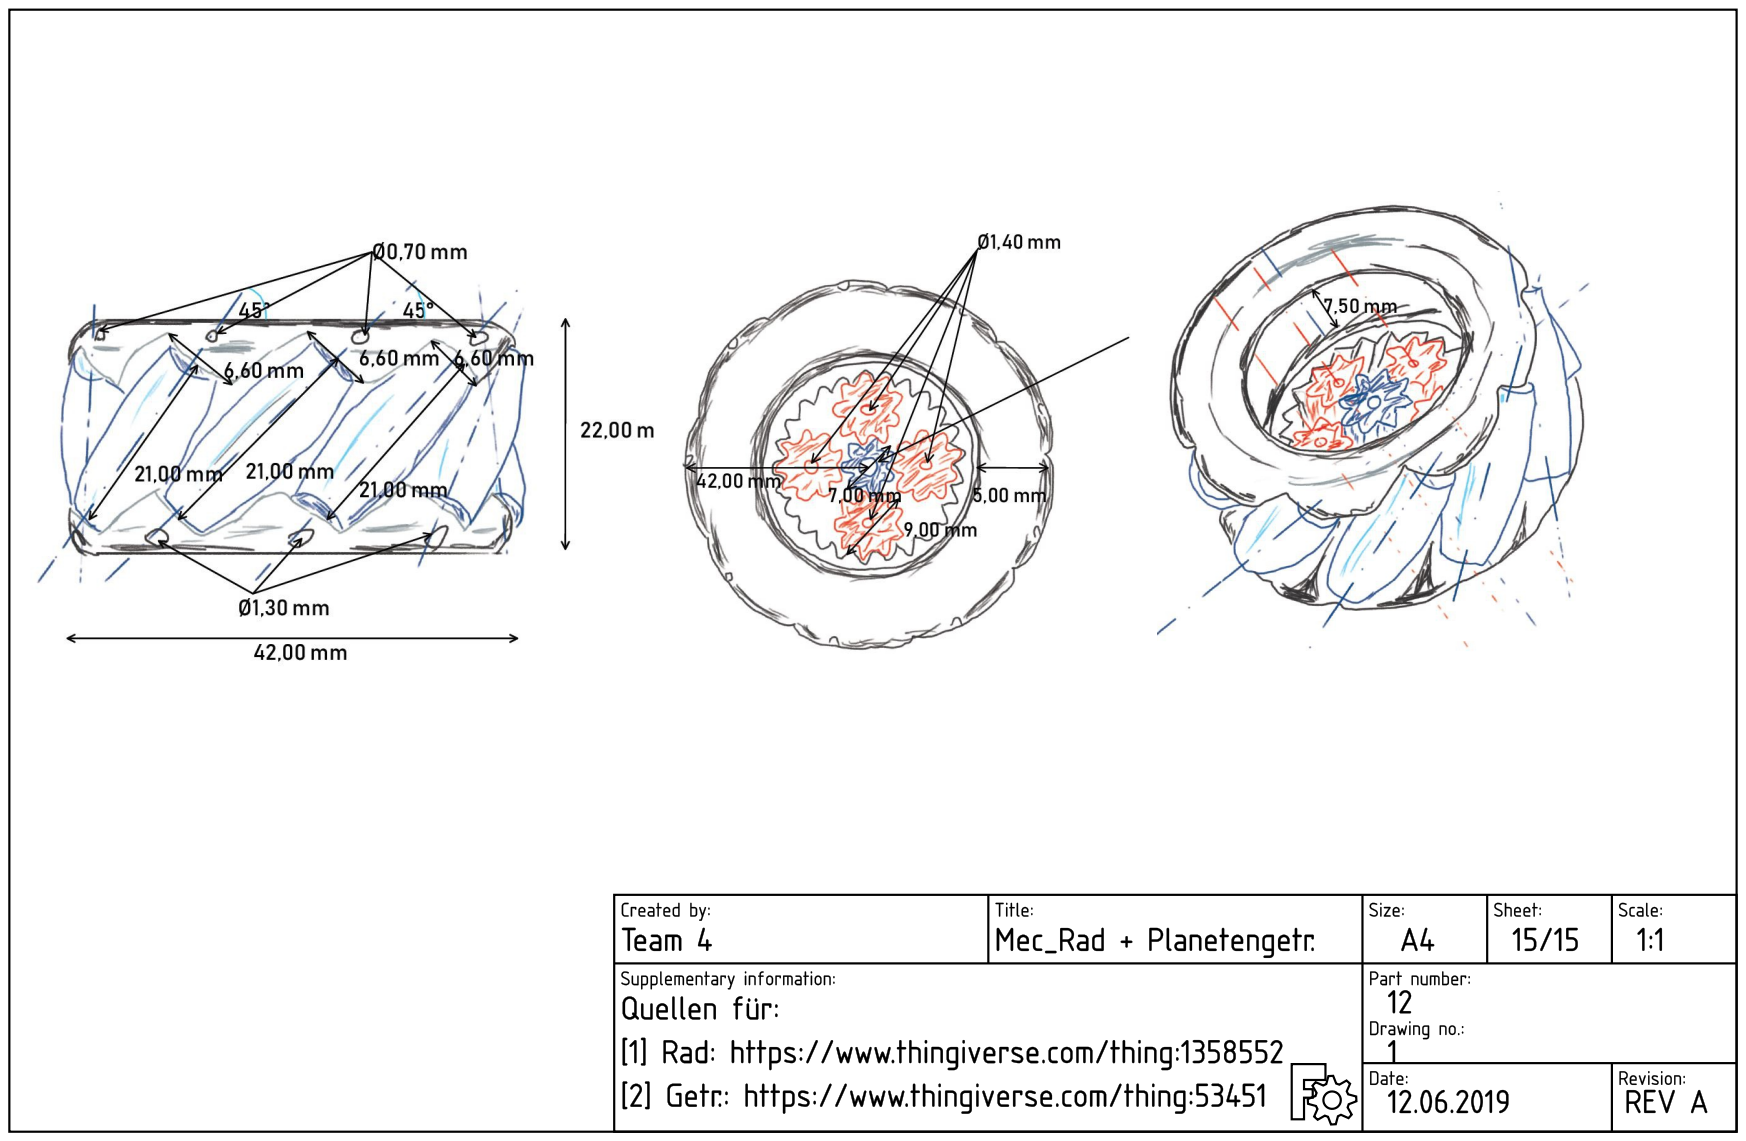
[picture p162: page 1]
