Khodii/OmniMoveCar/Bericht/techzeich/1.PDF

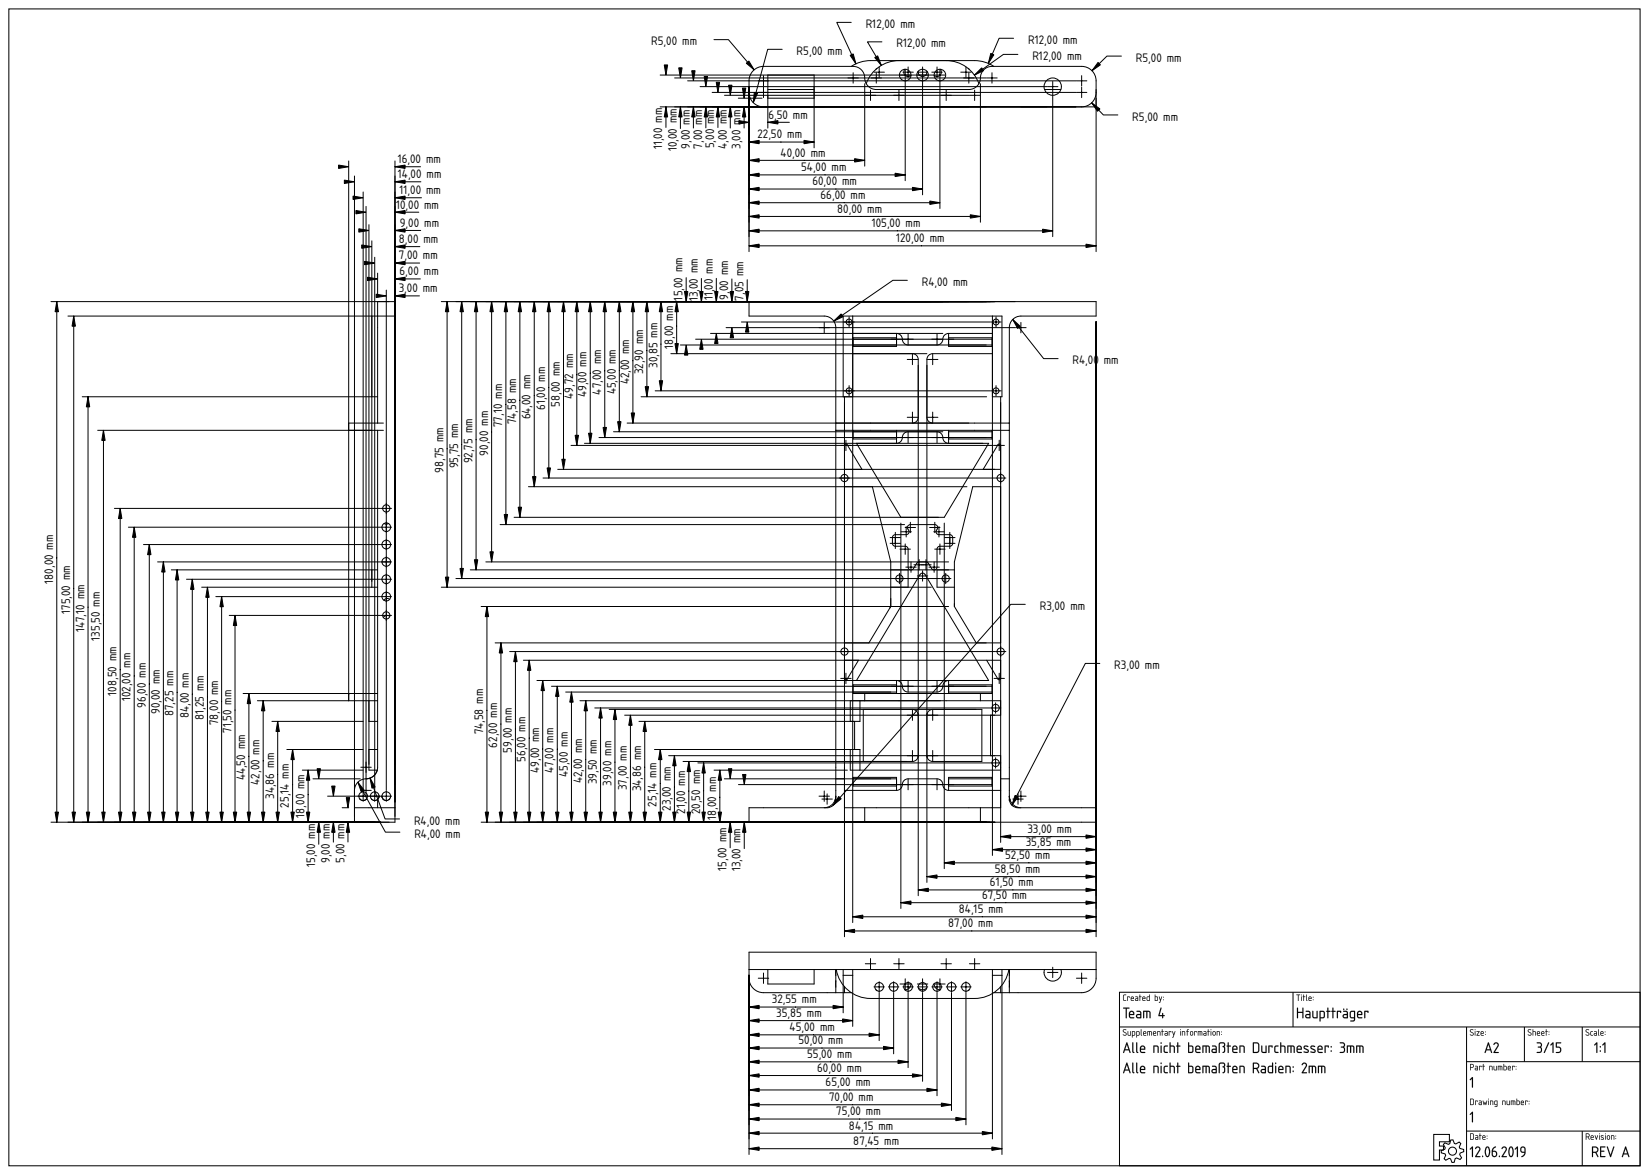
[picture p163: page 1]
