Khodii/OmniMoveCar/Bericht/techzeich/10.PDF

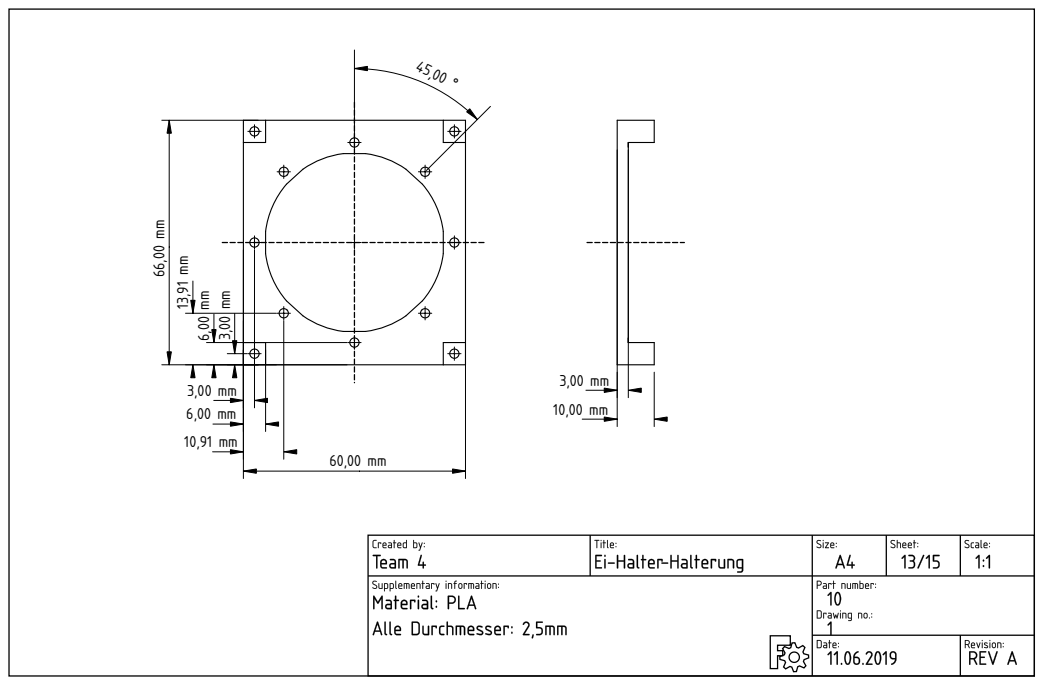
[picture p164: page 1]
