Khodii/OmniMoveCar/Bericht/techzeich/11.PDF

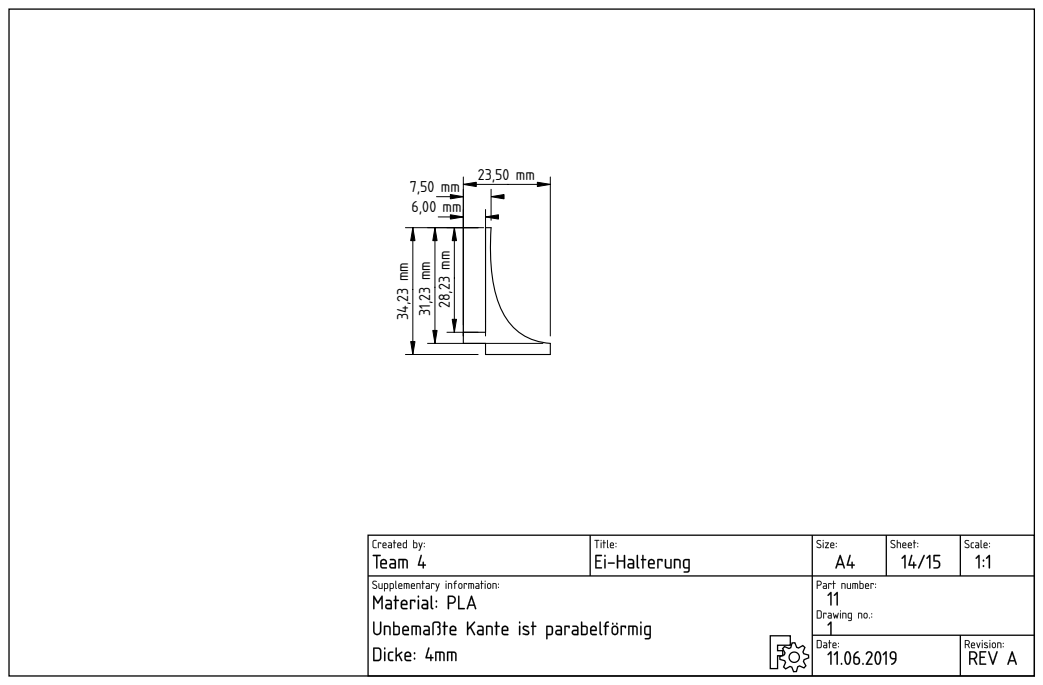
[picture p165: page 1]
