Khodii/OmniMoveCar/Bericht/techzeich/1iso.PDF

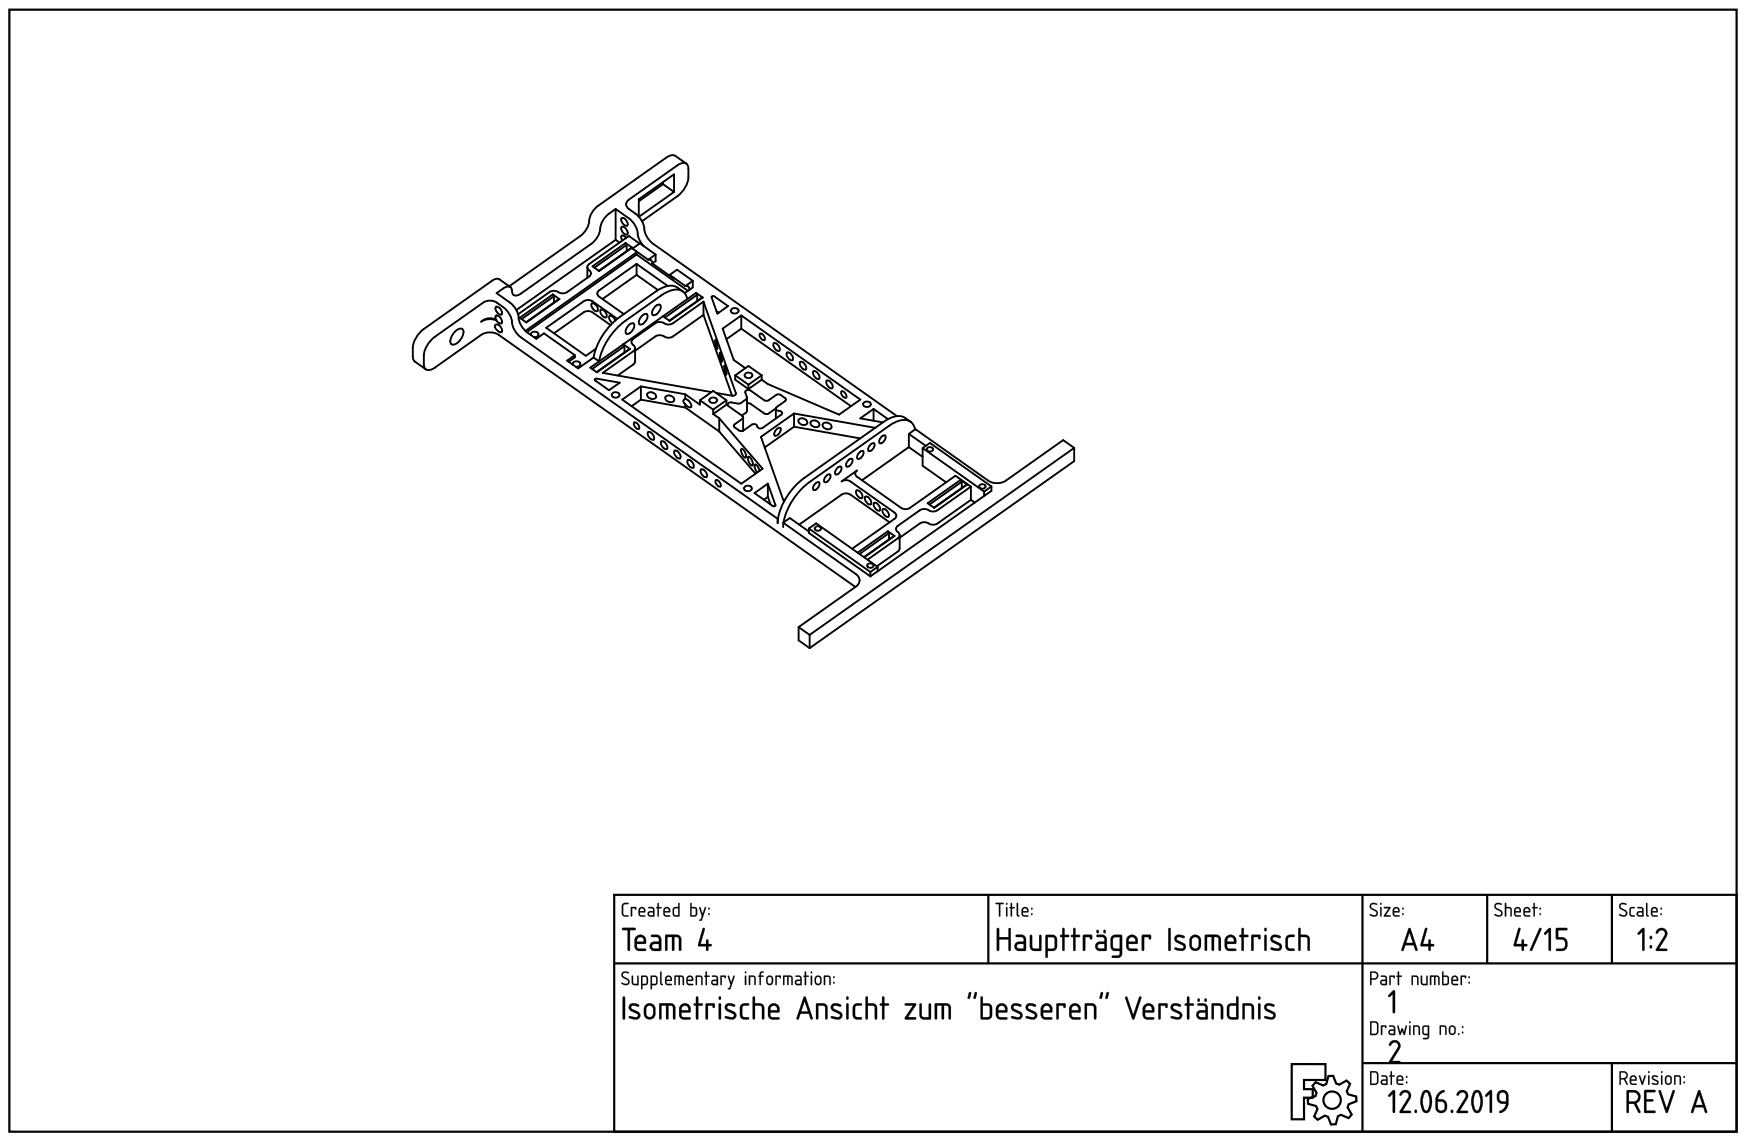
[picture p166: page 1]
