Khodii/OmniMoveCar/Bericht/techzeich/2.PDF

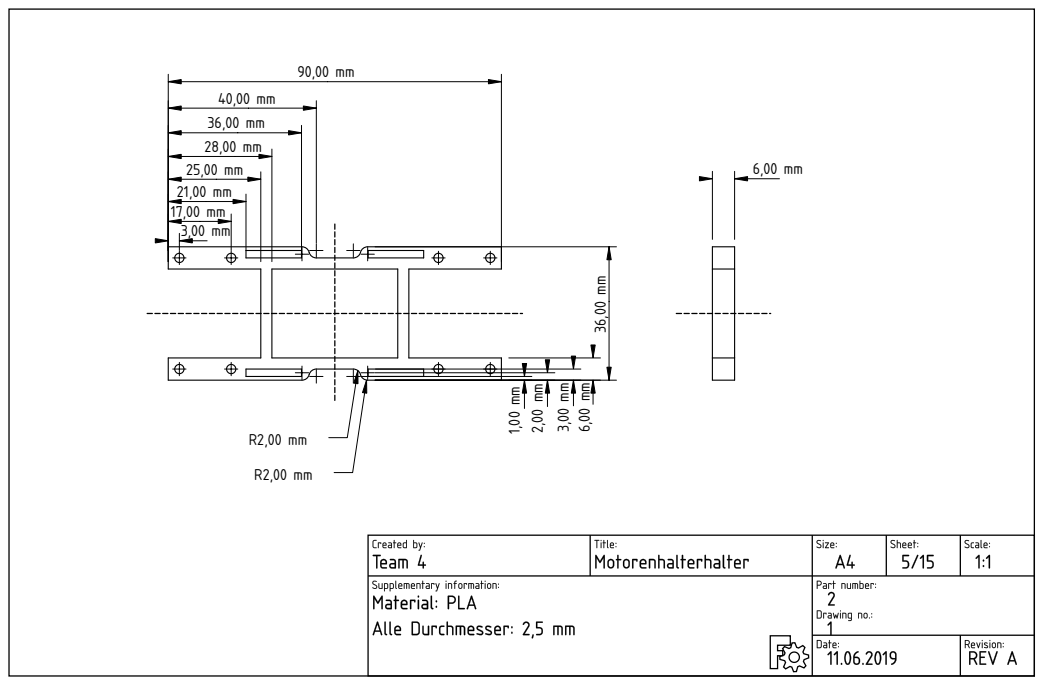
[picture p167: page 1]
