Khodii/OmniMoveCar/Bericht/techzeich/3.PDF

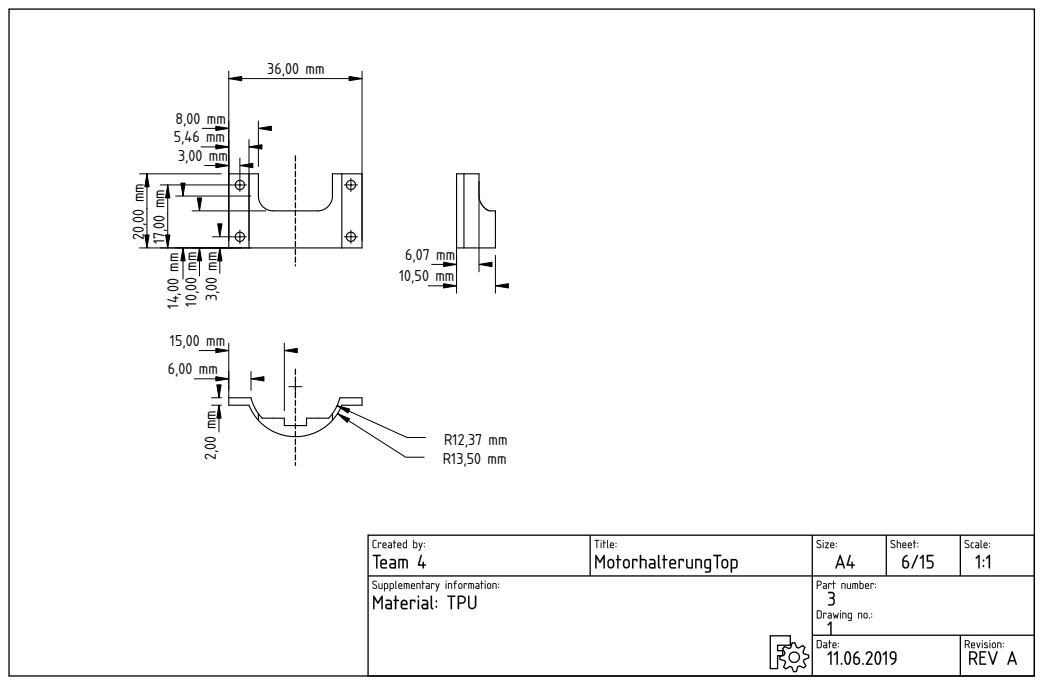
[picture p168: page 1]
