Khodii/OmniMoveCar/Bericht/techzeich/4.PDF

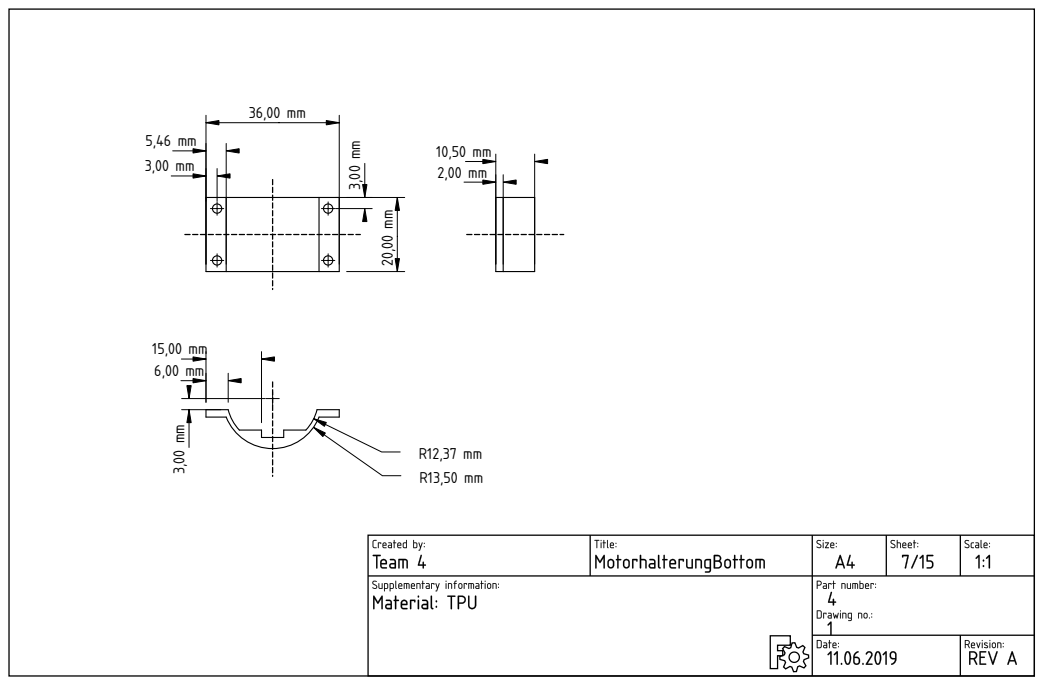
[picture p169: page 1]
