Khodii/OmniMoveCar/Bericht/techzeich/5.PDF

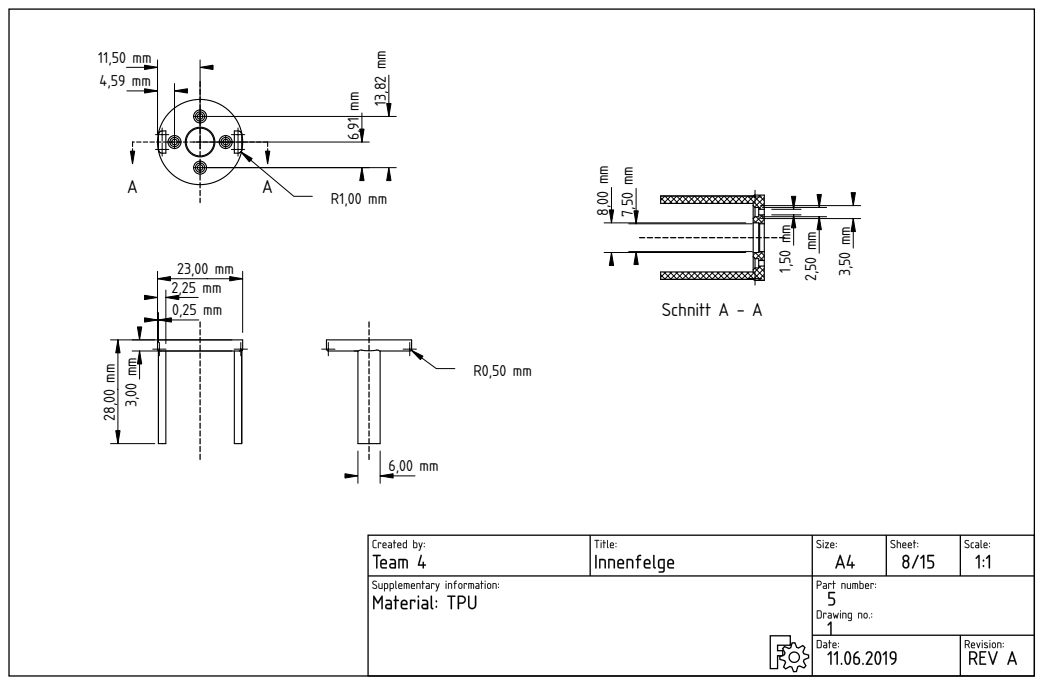
[picture p170: page 1]
Sch; nitt A
