Khodii/OmniMoveCar/Bericht/techzeich/6.PDF

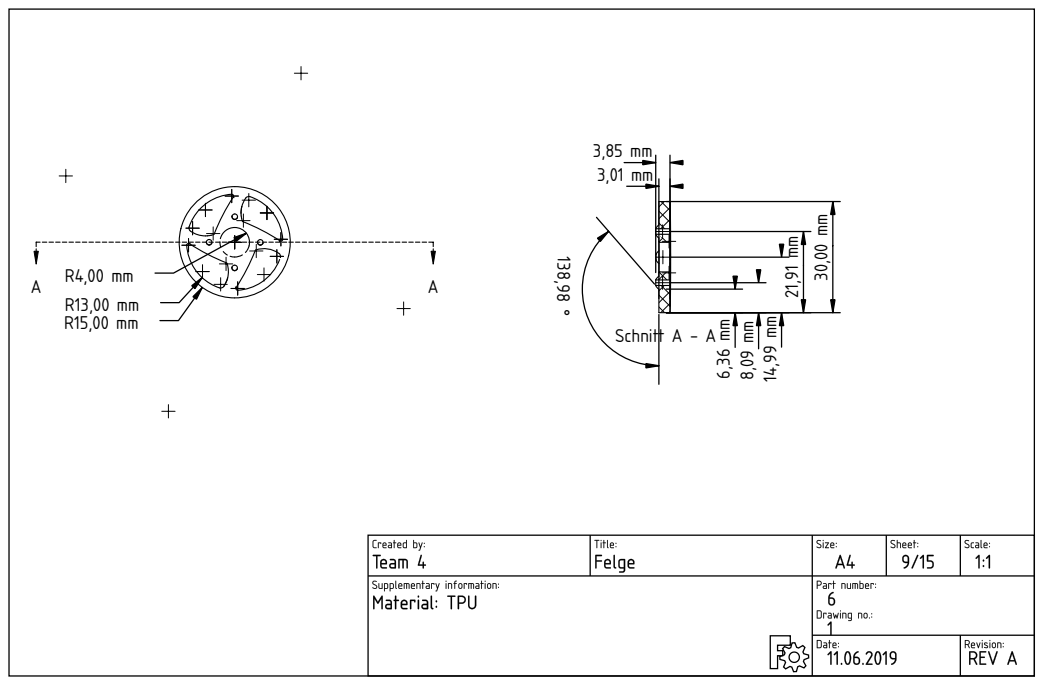
[picture p171: page 1]
Sch; nitt A
