Khodii/OmniMoveCar/Bericht/techzeich/7.PDF

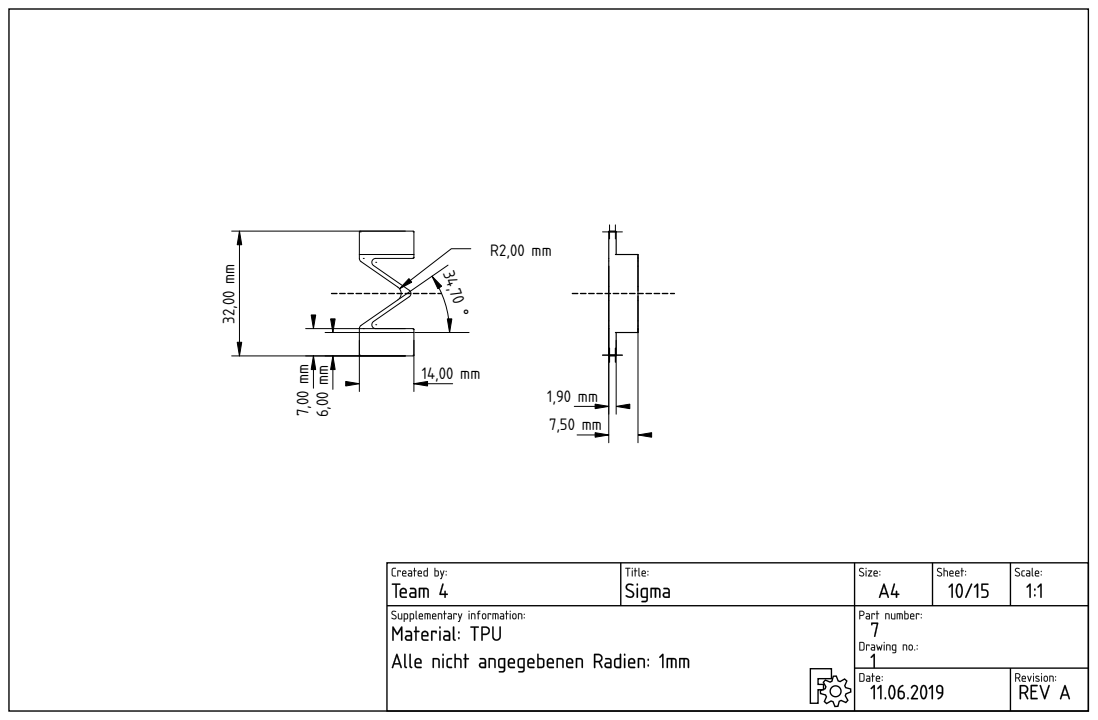
[picture p172: page 1]
