Khodii/OmniMoveCar/Bericht/techzeich/8.PDF

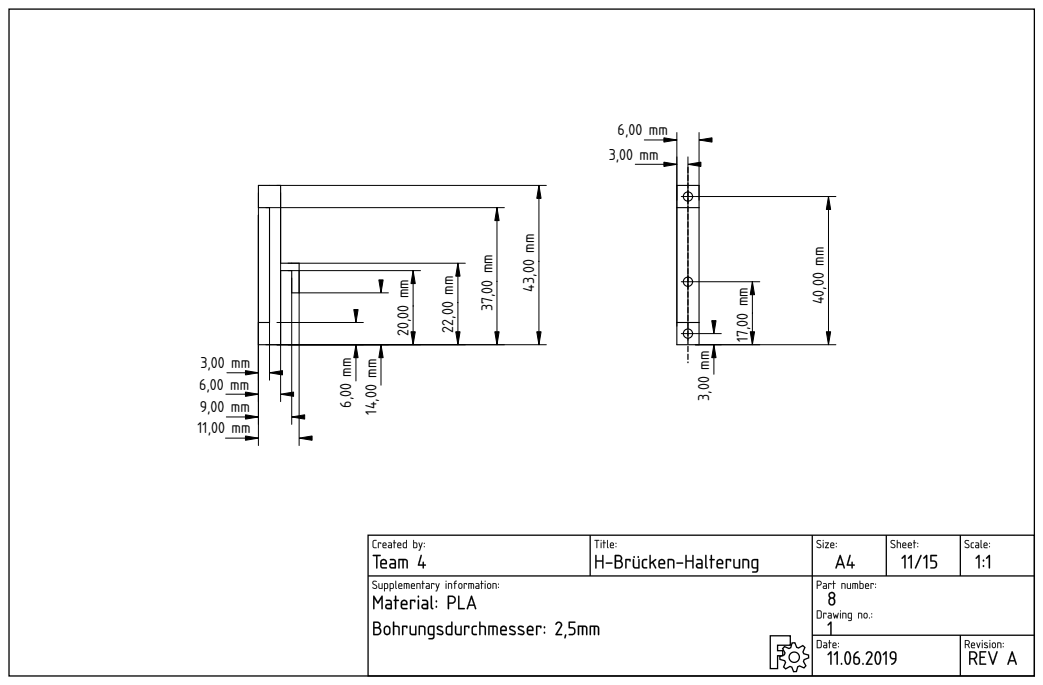
[picture p173: page 1]
