Khodii/OmniMoveCar/Bericht/techzeich/9.PDF

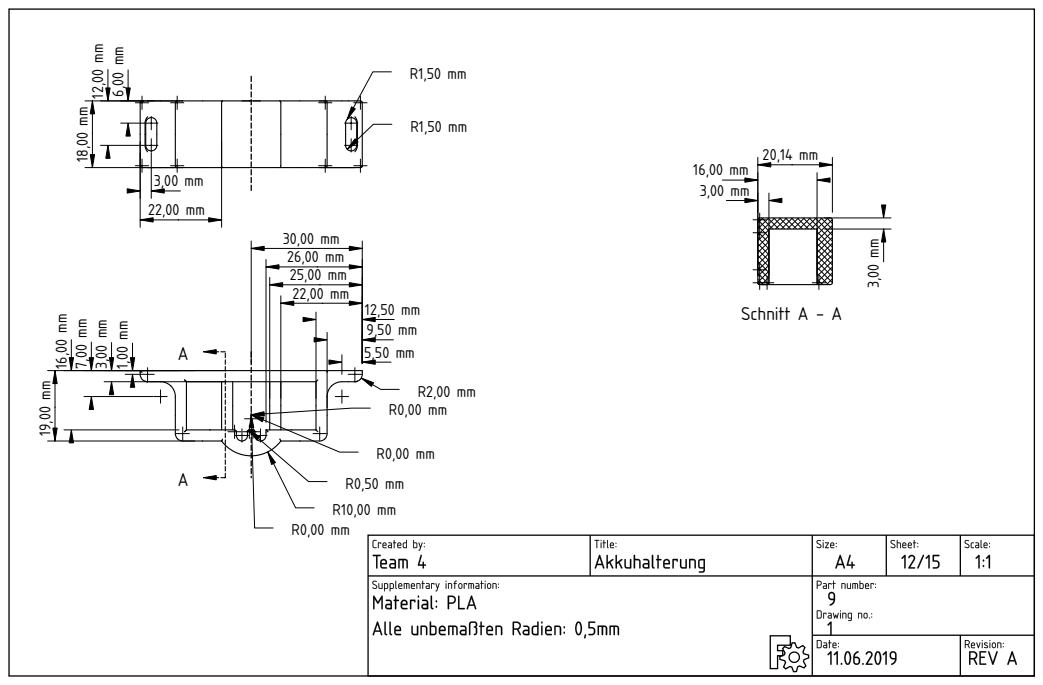
[picture p174: page 1]
Sch; nitt A
