Khodii/OmniMoveCar/(list of files, drawings)

Other design files:
Schaltplan.fzz
