Khodii/OmniMoveCar/(commit log)

2019-05-07 added Anforderungsliste
    [Anforderungsliste.xlsx]
2019-05-07 Added Lastenheft - Jonas
    [Anforderungsliste.xlsx]
2019-05-10 Add files via upload
    Zusammengefasst, vereinheitlicht, überarbeitet
    [Anforderungsliste.xlsx]
2019-05-11 word und pdf updated
    [Anforderungsliste.xlsx]
2019-05-18 Added test design
    [Body_Left.STL, Body_Right.STL, Motor_Mount.STL, Roller.STL, Top.STL, bottom.STL]
2019-05-20 3d model reibungstest
    [reibungstest.stl]
2019-05-20 Added MecanumPlanetGear
    [MecanumPlanetGearLeft.obj, MecanumPlanetGearRight.obj, bearing_20190520-61-6oq5m5.stl]
2019-05-21 g-code reibungstest
    [reibungstest.g]
2019-05-21 sink motor in wheel
    [25_5-10bearing.stl, code.scad]
2019-05-21 converted to stl
    [MecanumPlanetGearLeft.stl, MecanumPlanetGearRight.stl]
2019-05-21 created printable g-code
2019-05-21 middled rods
    [MecanumPlanetGearLeft.obj, MecanumPlanetGearRight.obj]
2019-05-21 fixed middle rods
    [MecanumPlanetGearLeft.stl, MecanumPlanetGearRight.stl]
2019-05-22 new bearing designs
    [4P6S26-holes_extruded.stl, 4P7S26-holes.stl, 4P7S26-holes_extruded.stl, code.scad]
2019-05-22 Added compiled g-code
    [4P6S26-holes.g, 4P7S26-holes.g, 5P8S22-holes.g]
2019-05-22 015 tolerance added
    [code.scad]
2019-05-22 updated g-files
    [4P6S26-holes.g, 4P7S26-holes.g, 5P8S22-holes.g]
2019-05-22 added other models and changed overall design
    [4P7S26-015.stl]
2019-05-23 remade träger
    [reibungstest.g, reibungstest.stl]
2019-05-23 designed MotorTräger
2019-05-23 Created MotorTräger
2019-05-23 Added motorhalterung
2019-05-23 Added Motorträger to Main
2019-05-23 deleted last motorträgerbestückt.asm
2019-05-23 Added drillholes into motorträger
2019-05-23 Some Imports
    [3D VIEW - Turnigy Batterie Nanotech 1800mAh 2S.IGS, L298N Stepper Motor Driver (Red).SLDASM, L298N Stepper Motor Driver (Red).SLDPRT, XT60 Connectors.stp]
2019-05-23 Added straight gears
    [4P6S26-straight.stl, 4P7S26-straight.stl, 5P8S22-straight.stl]
2019-05-23 added splited up models as well
    [4P6S26-straight-split.obj, 4P7S26-straight-split.obj, 5P8S22-straight-split.obj]
2019-05-24 Added HBridges and Ls
    [MecanumPlanetGearRightE.obj]
2019-05-24 Created Wheels (unfinished)
2019-05-24 Motorachse gedreht
2019-05-24 finished wheels
2019-05-24 Imported lipo2 & gyro
    [Battery.step, Battery.stl, MPU_6050.f3d, MPU_6050.iges, MPU_6050.step, MPU_6050.stl]
2019-05-24 Added bms
2019-05-25 added sigma halterungen und ein paar rundungen
2019-05-25 added some test exports
    [motorhalterung.stl, motorhalterungoben.stl, motortrger0.stl, sigma.stl]
2019-05-25 Added BMS and gyro
2019-05-25 Added new wheels
    [4P7S26-005.stl, MecanumPlanetGearNewLeft.obj, MecanumPlanetGearNewLeftExloded.obj, MecanumPlanetGearNewRight.obj, MecanumPlanetGearNewRightExloded.obj]
2019-05-26 formatet wheels to stl
    [MecanumPlanetGearNewLeftExloded.stl, MecanumPlanetGearNewRightExloded.stl]
2019-05-26 Add files via upload
    jetzt aber wirklich mit nicks skizzen
2019-05-27 Add files via upload
    jetzt nur noch scannen und baukasten anpassen
2019-06-03 added getriebehalterunginnen
    [4p7s02.stl, 4p7sonlyinner.obj, MecanumPlanetGearNewLeftExloded.obj, getriebehalterunginnen.stl]
2019-06-04 init Felgen
    [felge.stl, innenfelgel.stl, motorhalterung.stl, motorhalterungoben.stl, sigma.stl]
2019-06-04 TPU motorset
    [motorset.g]
2019-06-05 added variance tolerance
    [0,10.stl, 0,15.stl, 0,20.stl, 0,25.stl, 0,30.stl, 0,35.stl, 0,40.stl, 0,45.stl]
2019-06-10 some new gears and wires
    [0,10.stl, 0,15.stl, 0,20.stl, 0,25.stl, 0,30.stl, 0,35.stl, 0,40.stl, 0,45.stl]
2019-06-10 some updates
    [haupttrger0.stl, motortrger0.stl]
2019-06-10 new designed planetary gears & first Technical drawing
    [3xP12S7t0,10.stl, 3xP12S7t0,25.stl, 3xP14S7t0,15.stl, 3xP14S7t0,25.stl, MecanumPlanetGearNew2.stl, MecanumPlanetGearNew2Left.stl, MecanumPlanetGearNew2Right.stl, MecanumPlanetGearNew3Left.stl]
2019-06-11 Ein paar technische Zeichnungen
    [Car.FCStd]
2019-06-12 Abgabe M3 added and tech draws
    [Car.FCStd]
2019-06-12 .FCStd updated
    [Car.FCStd]
2019-06-12 technische zeichnung mec rad und plantengetr.
    [Marcel_TechDraw.FCStd]
2019-06-12 exported all stls
    [MecanumPlanetGearNew3Left.stl, MecanumPlanetGearNew3Right.stl, akkuhalterung.stl, eierhaltersegment.stl, eierhaltertrger0.stl, felge.stl, haupttrger0.stl, innenfelgel.stl]
2019-06-12 updated hand drawn wheel
    [felge.stl, innenfelgel.stl]
2019-06-12 zeichnung überarbeitet mec_räder + getriebe
    [Marcel_TechDraw.FCStd]
2019-06-12 Cad zeichnungen final (Seiten 3 - 14)
    [Car.FCStd]
2019-06-12 Abgabe Ordnerstruktur
    [MecanumPlanetGearNew3Left.stl, MecanumPlanetGearNew3Right.stl, akkuhalterung.stl, eierhaltersegment.stl, eierhaltertrger0.stl, felge.stl, haupttrger0.stl, innenfelgel.stl]
2019-06-12 neuester stand marcel
    [Marcel_TechDraw.FCStd, Marcel_TechDraw2.FCStd]
2019-06-12 g code gelöscht, pdfs neu betitelt passend
    [motorset.g]
2019-06-12 finale version (?)
    [Marcel_TechDraw2.FCStd]
2019-06-13 motorhalterung new tests
    [MecanumInseredDoubleGearHalterungInnen.stl]
2019-06-13 Exported getriebe parts
    [GearRing2.obj, Ring.obj, RingSmall.obj, SunMain.obj]
2019-06-27 Many changes on Hauptträger
    [haupttrger0.stl, motorgetriebehalterung.stl]
2019-07-02 own compound + pin tests
    [3_20_8_0,01.stl, 3_20_8_0,05.stl, 3_20_8_0,05_sliced.stl, 3_23_8_0,01.stl, 4_8_8.stl, 4_8_8_0,05_noexsun.stl, 4_8_8_0,5.stl, 4_8_8_0,5_sliced.stl]
2019-07-02 modded 2stage 66:1
    [2StageGearsSun2mm.stl, owncompoundgears.stl]
2019-07-02 forgot ring closure
    [Ring_Closures_For_Test.stl]
2019-07-03 added indent to sun
    [2StageGearsSun2mm.stl]
2019-07-03 updated halterung
    [lhalterung.stl]
2019-07-04 Added 1:4.14 gear + 24mm test ring
    [3P6S11.stl, TestRing24mm.stl, code.scad]
2019-07-05 Added esp programm, added webpage, sync per websocket
    [3P6S11.stl, TestRing24mm.stl, code.scad]
2019-07-05 failed attempt at dns
    [main.cpp]
2019-07-08 improved felge
    [6_11_4to1getr.stl, TestWheel.stl, felge.stl, innenfelgel.stl, testring.stl]
2019-07-09 updated Hauptträger, sigmas, Motorhalterung
    [haupttrger0.stl, motorhalterungoben.stl, sigma.stl]
2019-07-09 changed motorhalterung
    [motorhalterung.stl]
2019-07-12 init motorhalterx
    [motortrgerx0.stl]
2019-07-12 Arduino H init
2019-07-12 exported slotted omnis
    [OmniL.stl, omni.stl]
2019-07-14 should actually do stuff with the motors now
2019-07-14 start of send back motor speeds
2019-07-14 fixed wrong speed conversions
    [movement.cpp, movement.h, util.cpp]
2019-07-14 tried to fix websocket sending with no success
    [communication.cpp, main.cpp, movement.cpp, movement.h]
2019-07-15 getriebe gereade test
    [code.scad, getrGerade.stl]
2019-07-15 forgot export
    [innenfelgeRing.stl]
2019-07-18 gerades getriebe, longer ring
    [code.scad, getrGerade.stl]
2019-07-18 fixed motor speeds, added spannungsteiler
    [main.cpp, movement.cpp]
2019-07-18 Added MPU + Voltage
2019-07-18 limit to one connection to prevent problems
    [main.cpp]
2019-07-19 harcoded faster movement + %
    [3_18_6.stl]
2019-07-20 improved eier halter
    [eierhalterpins.stl, eierhalterträger.stl]
2019-07-22 schaltplan added as fzz
    [Schaltplan.fzz]
2019-07-22 finer control, accurate battery %
2019-07-22 Updated powerpoint
2019-07-22 Added bumper
    [frontbumperreplacement.stl]
2019-07-22 Added Teggla Logo
    [Tesla_Keychain.stl]
2019-07-22 Added Exports
    [frontbumperreplacement.stl, tegglafont.stl, tesla_keychain.stl]
2019-07-22 added esp32 vs 8266
2019-07-22 reglerentwurf und schaltplan bilder added, schaltplan updated
    [Schaltplan.fzz]
2019-07-28 kapitel 2, größtenteils 3 und regler in bericht added
2019-07-29 fritzing schaltplan updated
    [Schaltplan.fzz]
2019-07-29 added kosten to tex via csv
    [kosten.csv]
2019-07-29 Added lastenheft und anforderungsliste
2019-07-30 Added CAD
2019-07-30 added Schaltplan und Akku
2019-07-30 fist part gear
2019-07-30 Added current getriebe
